AthenasArch/ESP32-CLP-Parana-V1.0/Documentos/CLP_ESP32_PIN_MAP/ESP32.xlsx

Sheet: WROOM
Name | Type | GPIO | OBS | ADC | UART | Parallel QSPI | APPLICATION | USED FOR | Setado no projeto
IO00 | I/O | GPIO00 | outputs PWM signal at boot | ADC2_CH01 |  |  | BOOTLOADER-SWITCH | INPUT | ok
TXD0 | I/O | GPIO01 |  |  | U0TXD |  | Fiwmare |  | ok
IO02 | I/O | GPIO02 |  | ADC2_CH02 |  | HSPIWP | PWM |  | ok
RXD0 | I/O | GPIO03 |  |  | U0RXD |  | Fiwmare |  | ok
IO04 | I/O | GPIO04 |  | ADC2_CH0 |  | HSPIHD | PWM |  | ok
IO05 | I/O | GPIO05 |  |  |  | VSPICS0 | SPI-CS | SPI-CS | ok
SCK/CLK* | I/O | GPIO06 |  |  | U1CTS | SPICLK | INTERNAL |  | ok
SDO/SD0* | I/O | GPIO07 |  |  | U2RTS | SPIQ | INTERNAL |  | ok
SDI/SD1* | I/O | GPIO08 |  |  | U2CTS | SPID | INTERNAL |  | ok
SHD/SD2* | I/O | GPIO09 |  |  | U1RXD | SPIHD | INTERNAL |  | ok
SWP/SD3* | I/O | GPIO10 |  |  | U1TXD | SPIWP | INTERNAL |  | ok
SCS/CMD* | I/O | GPIO11 |  |  | U1RTS | SPICS0 | INTERNAL |  | ok
IO12 | I/O | GPIO12 |  | ADC2_CH05 |  | HSPIQ | RELAY | OUTPUT | ok
IO13 | I/O | GPIO13 |  | ADC2_CH04 |  | HSPID | RELAY | OUTPUT | ok
IO14 | I/O | GPIO14 |  | ADC2_CH06 |  | HSPICLK | RELAY | OUTPUT | ok
IO15 | I/O | GPIO15 |  | ADC2_CH03 |  | HSPICS0 | BUTTON | INPUT | ok
IO16 | I/O | GPIO16 |  |  | U2RXD |  | EXTERNAL-COMM | RX2 | ok
IO17 | I/O | GPIO17 |  |  | U2TXD |  | EXTERNAL-COMM | TX2 | ok
IO18 | I/O | GPIO18 |  |  |  | VSPICLK | SPI-SCK | - | ok
IO19 | I/O | GPIO19 |  |  | U0CTS | VSPIQ | SPI-MISO | - | ok
IO21 | I/O | GPIO21 |  |  |  | VSPIHD | I2C | SDA | ok
IO22 | I/O | GPIO22 |  |  | U0RTS | VSPIWP | I2C | SCL | ok
IO23 | I/O | GPIO23 |  |  |  | VSPID | SPI-MOSI | - | ok
IO25 | I/O | GPIO25 |  | ADC2_CH08 |  |  | BUZZER | OUTPUT | ok
IO26 | I/O | GPIO26 |  | ADC2_CH09 |  |  | Temperature DS18B20 | ANALOG | ok
IO27 | I/O | GPIO27 |  | ADC2_CH07 |  |  | RELAY | OUTPUT | ok
IO32 | I/O | GPIO32 |  | ADC1_CH04 |  |  | DIGITAL-INPUT | INPUT | ok
IO33 | I/O | GPIO33 |  | ADC1_CH05 |  |  | DIGITAL-INPUT | INPUT | ok
IO34 | I | GPIO34 |  | ADC1_CH06 |  |  | DIGITAL-INPUT | INPUT | ok
IO35 | I | GPIO35 |  | ADC1_CH07 |  |  | DIGITAL-INPUT | INPUT | ok
SENSOR_VP | I | GPIO36 |  | ADC1_CH0 |  |  | ANALOG-INPUT | ANALOG | ok
SENSOR_VN | I | GPIO39 |  | ADC1_CH03 |  |  | ANALOG-INPUT | ANALOG | ok
GND | P |  |  |  |  |  | INTERNAL |  | ok
3V3 | P |  |  |  |  |  | INTERNAL |  | ok
EN | I |  |  |  |  |  | INTERNAL |  | ok
GND | P |  |  |  |  |  | INTERNAL |  | ok
NC | - |  |  |  |  |  | INTERNAL |  | ok
GND | P |  |  |  |  |  | INTERNAL |  | ok
GND | P |  |  |  |  |  | INTERNAL |  | ok

Sheet: ESP32 Chip
Name | No. | Type |  |  |  |  |  |  |  |  | Function
VDDA | 1 | P | Analog power supply (2.3V ~ 3.6V)
LNA_IN | 2 | I/O | RF input and output
VDD3P3 | 3 | P | Power supply (2.3V ~ 3.6V)
VDD3P3 | 4 | P | Power supply (2.3V ~ 3.6V)
SENSOR_VP | 5 | I | GPIO36 | ADC_PRE_AMP | ADC1_CH0 |  |  |  |  |  | RTC_GPIO0 Note: Connects a 270 pF capacitor from SENSOR_VP to SENSOR_ CAPP w
SENSOR_CAPP | 6 | I | GPIO37 | ADC_PRE_AMP | ADC1_CH1 |  |  |  |  |  | RTC_GPIO1 Note: Connects a 270 pF capacitor from SENSOR_VP to SENSOR_ CAPP w
SENSOR_CAPN | 7 | I | GPIO38 | ADC1_CH2 | ADC_PRE_AMP |  |  |  |  |  | RTC_GPIO2 Note: Connects a 270 pF capacitor from SENSOR_VN to SENSOR_ CAPN w
SENSOR_VN | 8 | I | GPIO39 | ADC1_CH3 | ADC_PRE_AMP |  |  |  |  |  | RTC_GPIO3 Note: Connects a 270 pF capacitor from SENSOR_VN to SENSOR_ CAPN w
CHIP_PU | 9 | I | High: On; enables the chip Low: Off; resets the chip Note: Do not leave the CHIP_PU pin floating.
VDET_1 | 10 | I | GPIO34 | ADC1_CH6 |  |  |  |  |  |  | RTC_GPIO4
VDET_2 | 11 | I | GPIO35 | ADC1_CH7 |  |  |  |  |  |  | RTC_GPIO5
32K_XP | 12 | I/O | GPIO32 | 32K_XP (32.768 kHz crystal oscillator input) | ADC1_CH4 | TOUCH9 |  |  |  |  | RTC_GPIO9
32K_XN | 13 | I/O | GPIO33 | 32K_XN (32.768 kHz crystal oscillator output) | ADC1_CH5 | TOUCH8 |  |  |  |  | RTC_GPIO8
GPIO25 | 14 | I/O | GPIO25 | DAC_1 | ADC2_CH8 | RTC_GPIO6 |  |  |  |  | EMAC_RXD0
GPIO26 | 15 | I/O | GPIO26 | DAC_2 | ADC2_CH9 | RTC_GPIO7 |  |  |  |  | EMAC_RXD1
GPIO27 | 16 | I/O | GPIO27 | ADC2_CH7 | TOUCH7 | RTC_GPIO17 |  |  |  |  | EMAC_RX_DV
MTMS | 17 | I/O | GPIO14 | ADC2_CH6 | TOUCH6 | RTC_GPIO16 | MTMS | HSPICLK | HS2_CLK | SD_CLK | EMAC_TXD2
MTDI | 18 | I/O | GPIO12 | ADC2_CH5 | TOUCH5 | RTC_GPIO15 | MTDI | HSPIQ | HS2_DATA2 | SD_DATA2 | EMAC_TXD3
VDD3P3_RTC | 19 | P | Input power supply for RTC IO (1.8V ~ 3.6V)
MTCK | 20 | I/O | GPIO13 | ADC2_CH4 | TOUCH4 | RTC_GPIO14 | MTCK | HSPID | HS2_DATA3 | SD_DATA3 | EMAC_RX_ER
MTDO | 21 | I/O | GPIO15 | ADC2_CH3 | TOUCH3 | RTC_GPIO13 | MTDO | HSPICS0 | HS2_CMD | SD_CMD | EMAC_RXD3
GPIO2 | 22 | I/O | GPIO2 | ADC2_CH2 | TOUCH2 | RTC_GPIO12 | HSPIWP | HS2_DATA0 |  |  | SD_DATA0
GPIO0 | 23 | I/O | GPIO0 | ADC2_CH1 | TOUCH1 | RTC_GPIO11 | CLK_OUT1
GPIO4 | 24 | I/O | GPIO4 | ADC2_CH0 | TOUCH0 | RTC_GPIO10 | HSPIHD | HS2_DATA1 | SD_DATA1 |  | EMAC_TX_ER
GPIO16 | 25 | I/O | GPIO16 | HS1_DATA4 | U2RXD |  |  |  |  |  | EMAC_CLK_OUT
VDD_SDIO | 26 | P | Output power supply: 1.8V or the same voltage as
GPIO17 | 27 | I/O | GPIO17 | HS1_DATA5 | U2TXD |  |  |  |  |  | EMAC_CLK_OUT_180
SD_DATA_2 | 28 | I/O | GPIO9 | SD_DATA2 | SPIHD | HS1_DATA2 | UNUSABLE !!! (Flash memory) |  |  |  | U1RXD
SD_DATA_3 | 29 | I/O | GPIO10 | SD_DATA3 | SPIWP | HS1_DATA3 | UNUSABLE !!! (Flash memory) |  |  |  | U1TXD
SD_CMD | 30 | I/O | GPIO11 | SD_CMD | SPICS0 | HS1_CMD | UNUSABLE !!! (Flash memory) |  |  |  | U1RTS
SD_CLK | 31 | I/O | GPIO6 | SD_CLK | SPICLK | HS1_CLK | UNUSABLE !!! (Flash memory) |  |  |  | U1CTS
SD_DATA_0 | 32 | I/O | GPIO7 | SD_DATA0 | SPIQ | HS1_DATA0 | UNUSABLE !!! (Flash memory) |  |  |  | U2RTS
SD_DATA_1 | 33 | I/O | GPIO8 | SD_DATA1 | SPID | HS1_DATA1 | UNUSABLE !!! (Flash memory) |  |  |  | U2CTS
GPIO5 | 34 | I/O | GPIO5 | VSPICS0 | HS1_DATA6 |  |  |  |  |  | EMAC_RX_CLK
GPIO18 | 35 | I/O | GPIO18 | VSPICLK |  |  |  |  |  |  | HS1_DATA7
GPIO23 | 36 | I/O | GPIO23 | VSPID |  |  |  |  |  |  | HS1_STROBE
VDD3P3_CPU | 37 | P | Input power supply for CPU IO (1.8V ~ 3.6V)
GPIO19 | 38 | I/O | GPIO19 | VSPIQ | U0CTS |  |  |  |  |  | EMAC_TXD0
GPIO22 | 39 | I/O | GPIO22 | VSPIWP | U0RTS |  |  |  |  |  | EMAC_TXD1
U0RXD | 40 | I/O | GPIO3 | U0RXD |  |  |  |  |  |  | CLK_OUT2
U0TXD | 41 | I/O | GPIO1 | U0TXD | CLK_OUT3 |  |  |  |  |  | EMAC_RXD2
GPIO21 | 42 | I/O | GPIO21 | VSPIHD |  |  |  |  |  |  | EMAC_TX_EN
VDDA | 43 | P | Analog power supply (2.3V ~ 3.6V)
XTAL_N | 44 | O | External crystal output
XTAL_P | 45 | I | External crystal input
VDDA | 46 | P | Digital power supply for PLL (2.3V ~ 3.6V)
CAP2 | 47 | I | Connects to a 3 nF capacitor and 20 kÎ© resistor in parallel
CAP1 | 48 | I | Connects to a 10 nF series capacitor to ground
GND | 49 | P | Ground

Sheet: Planilha1
ITEM | APLICAÇÃO | DESCRIÇÃO | QTDE | UNIDADE MEDIDA | OBSERVAÇÕES
0 | Alimentação AC | Tensão de alimentação | 1 | 90 a 240 VAC
1 | Alimentação DC | Tensão de alimentação | 1 | 12VDC
2 | - | Corrente de alimentação | 1 | 200mA
3 | Entradas | Entradas Digitais (Contato seco) | 4 | 7-24VDC
5 |  | Entradas analógicas (Tensão) | 2 | 0-32V
6 |  | Entrada digital (por chave tactil - botão) | 1 | -
 |  | Entrada de sinal AC - 90 a 240VAC | 2
8 | Saídas | Saídas Relé | 4 | -
- | - | - Tensão AC | " | 250V
- | - | - Corrente AC | " | 5A
- | - | - Tensão DC | " | 30V
- | - | - Corrente DC | " | 5A
9 | Saídas | Saídas por trasistores de efeito de campo - Mosfet’s (0 A 12V) | 2 | -
- | - | - Tensão DC | " | 30V
- | - | - Corrente DC | " | 5A
 | Buzzer | Buzzer passivo | 1 | 12VDC
10 | Comunicações | Porta de comunicação serial - (RS232) | 1 | TTL
11 | - | comunicação ISP | 1 | TTL
12 | - | comunicação I2C | 1 | TTL
14 | - | Rolégio em tempo real (RTC) - Precisão | 1 | SIM
 |  | WIFI 2,4 Gh | 1 | SIM
 |  | BLUETOOTH 5.0 | 1 | SIM
15 | Programação | Programação direta na placa | 1 | SIM
16 |  | Ambiente de programação | - | - | Arduino IDE (Ladder em desenvolvimento)
17 | Características | Condições de temperatura ambiente - min | - | -40°
18 |  | Condições de temperatura ambiente - max | - | +80°
19 |  | Dimensões | - | 150x119mm
20 | DISPLAY | display touch screen |  | 2,8" a 7,0" | Programação na interface do fabricante
