AthenasArch/ESP32-CLP-Parana-V1.0/Documentos/Schematic_v2.0/GETEWAY_V2.0.pdf

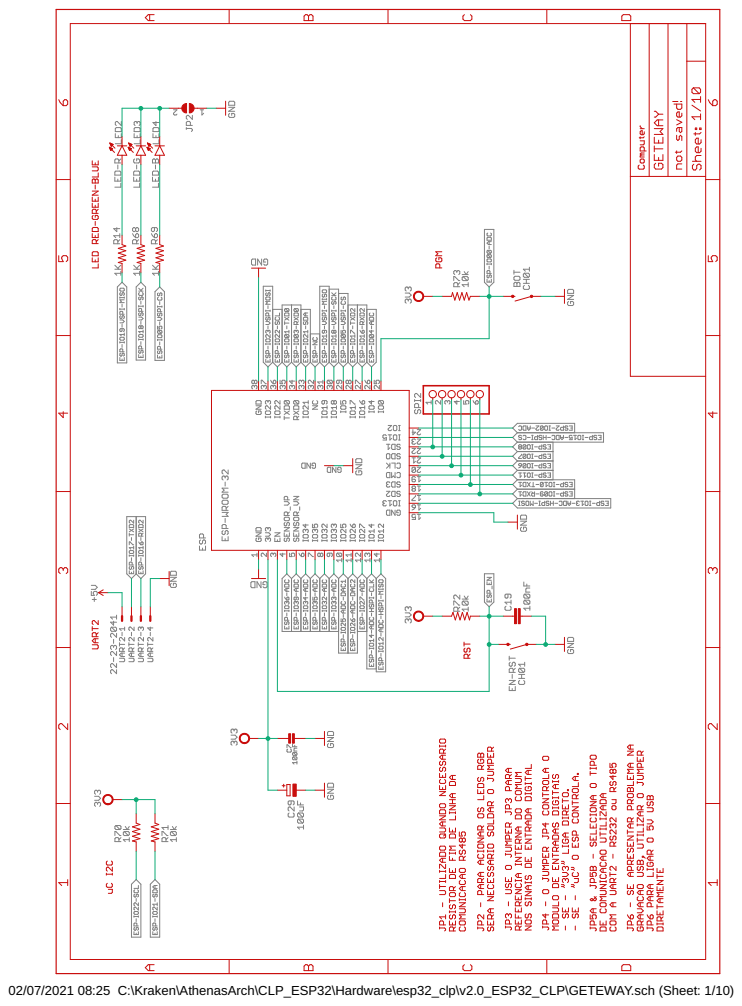
[picture p1: page 1]

02/07/2021 08:25 C:\Kraken\AthenasArch\CLP_ESP32\Hardware\esp32_clp\v2.0_ESP32_CLP\GETEWAY.sch (Sheet: 1/10)

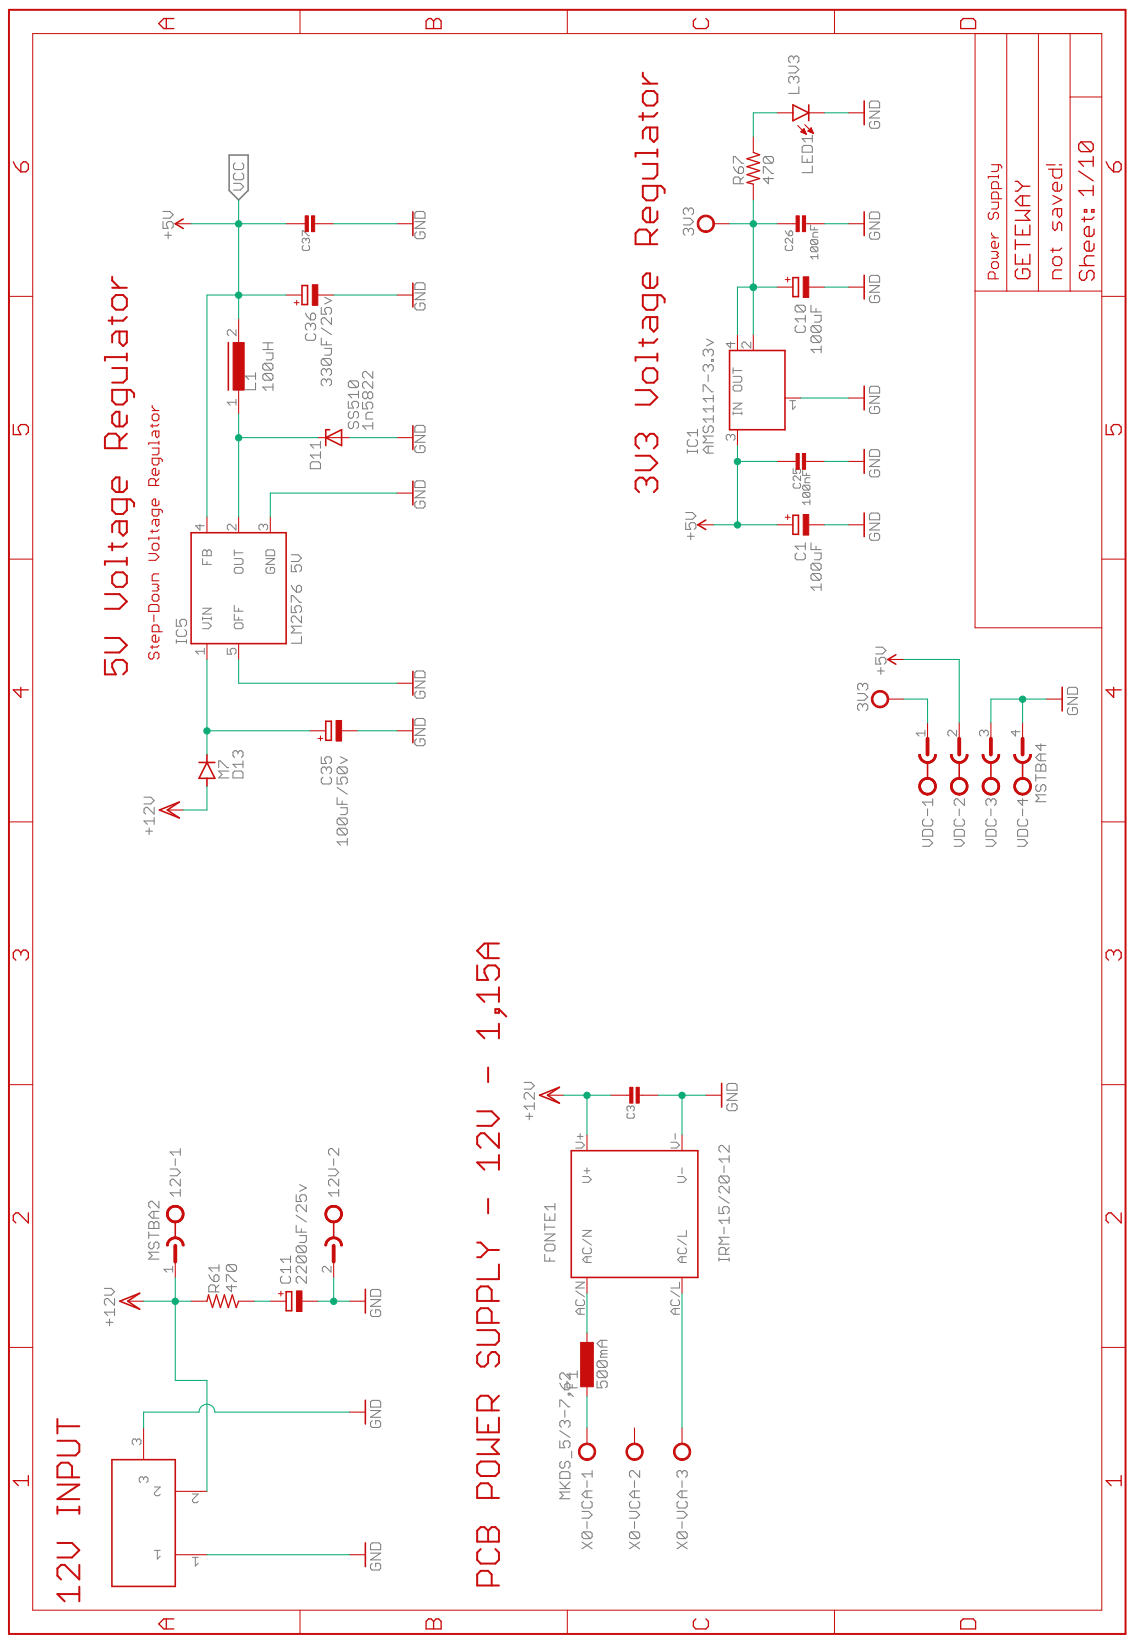
[picture p2: page 2]

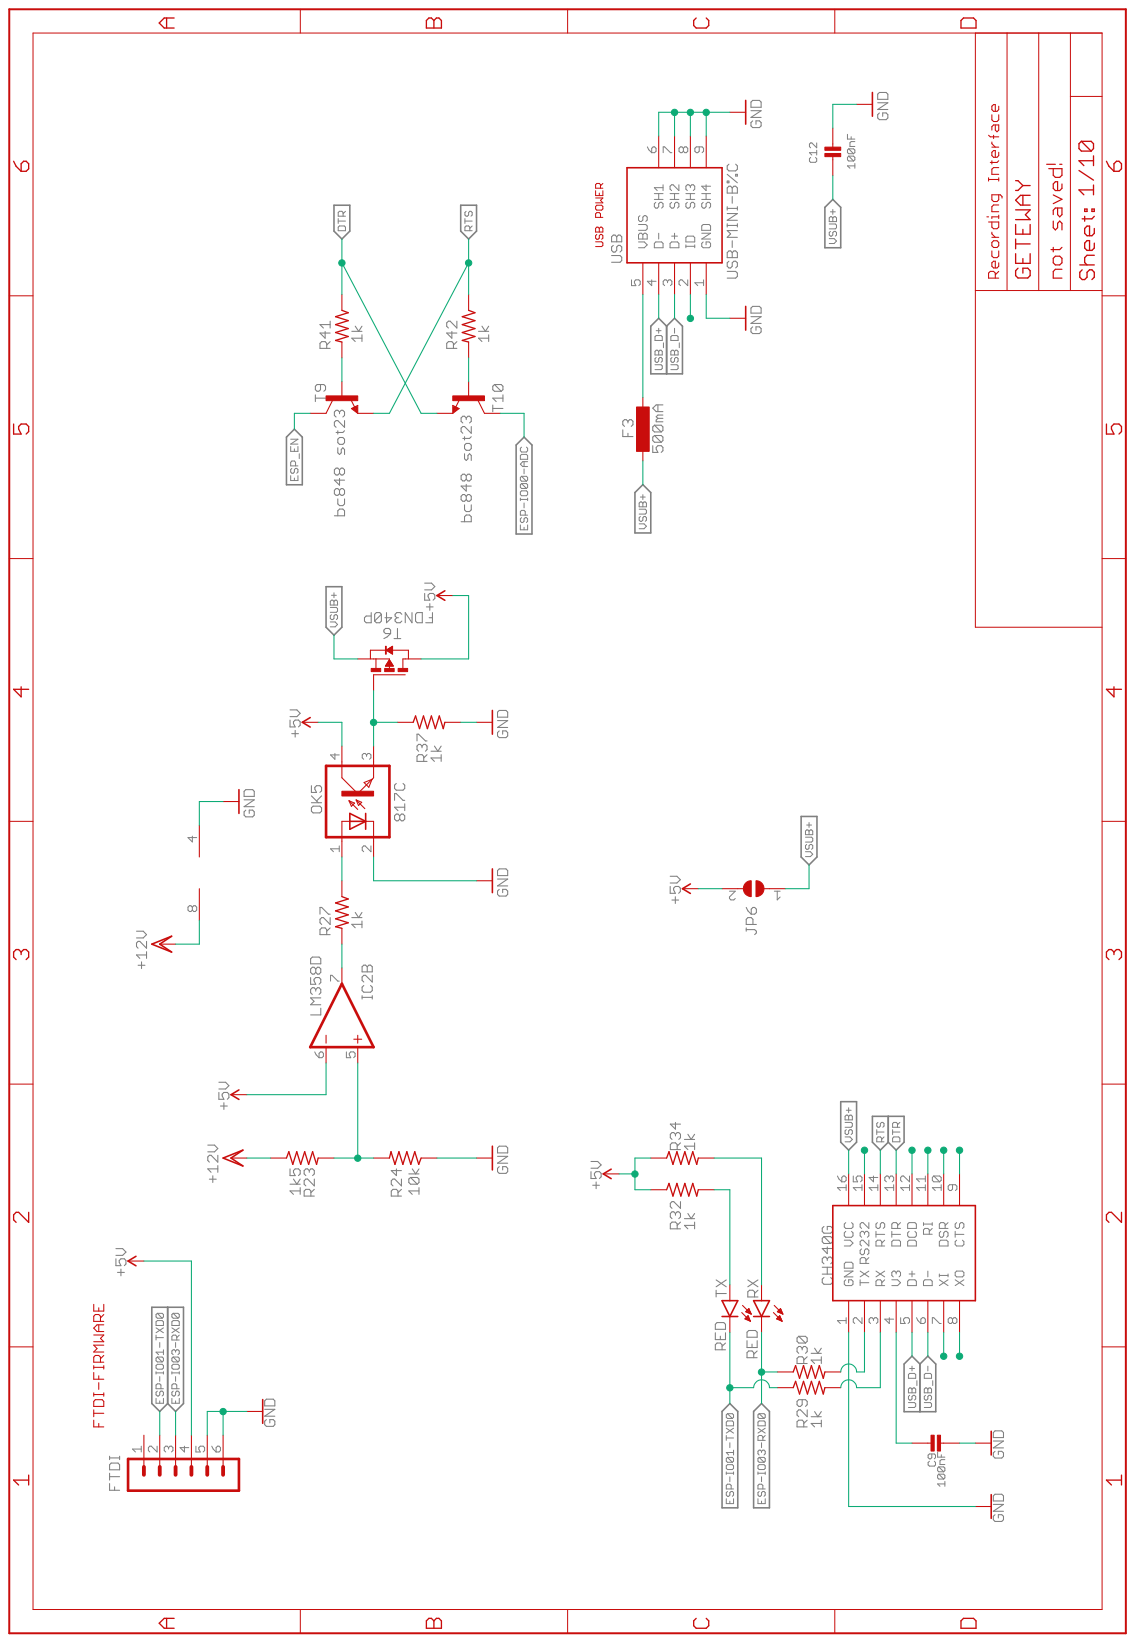
[picture p3: page 3]

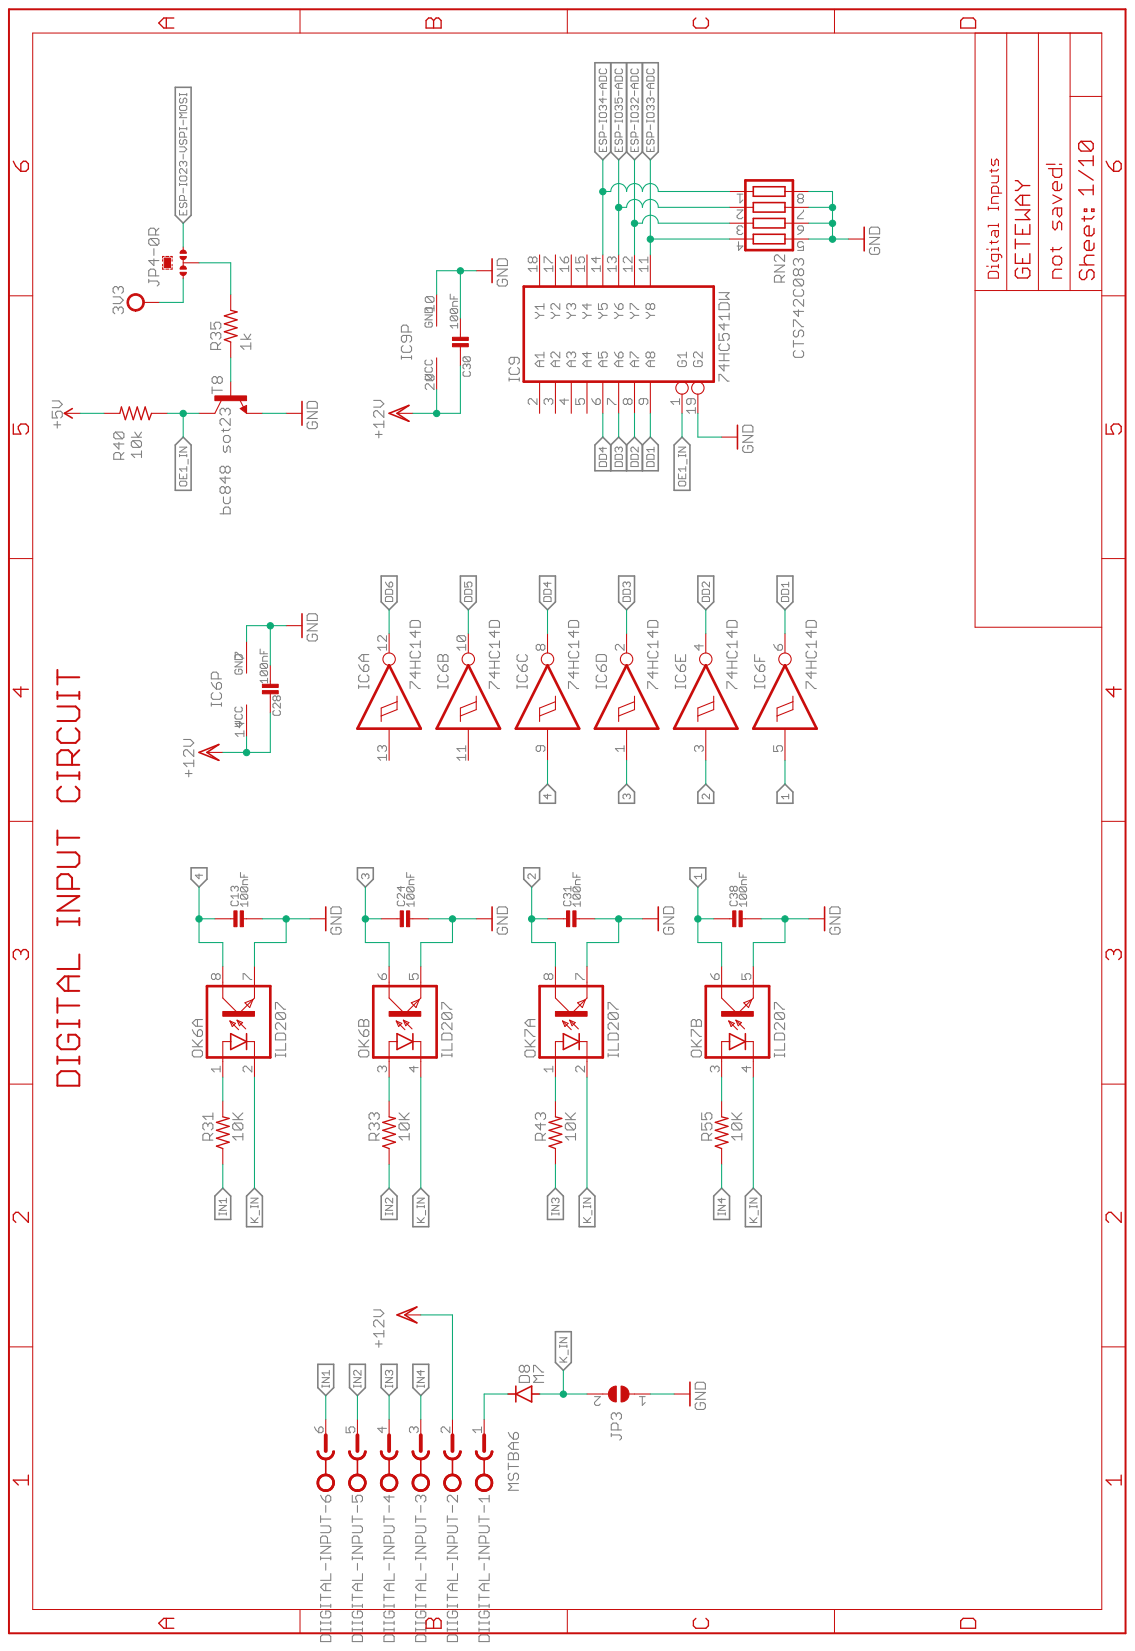
[picture p4: page 4]

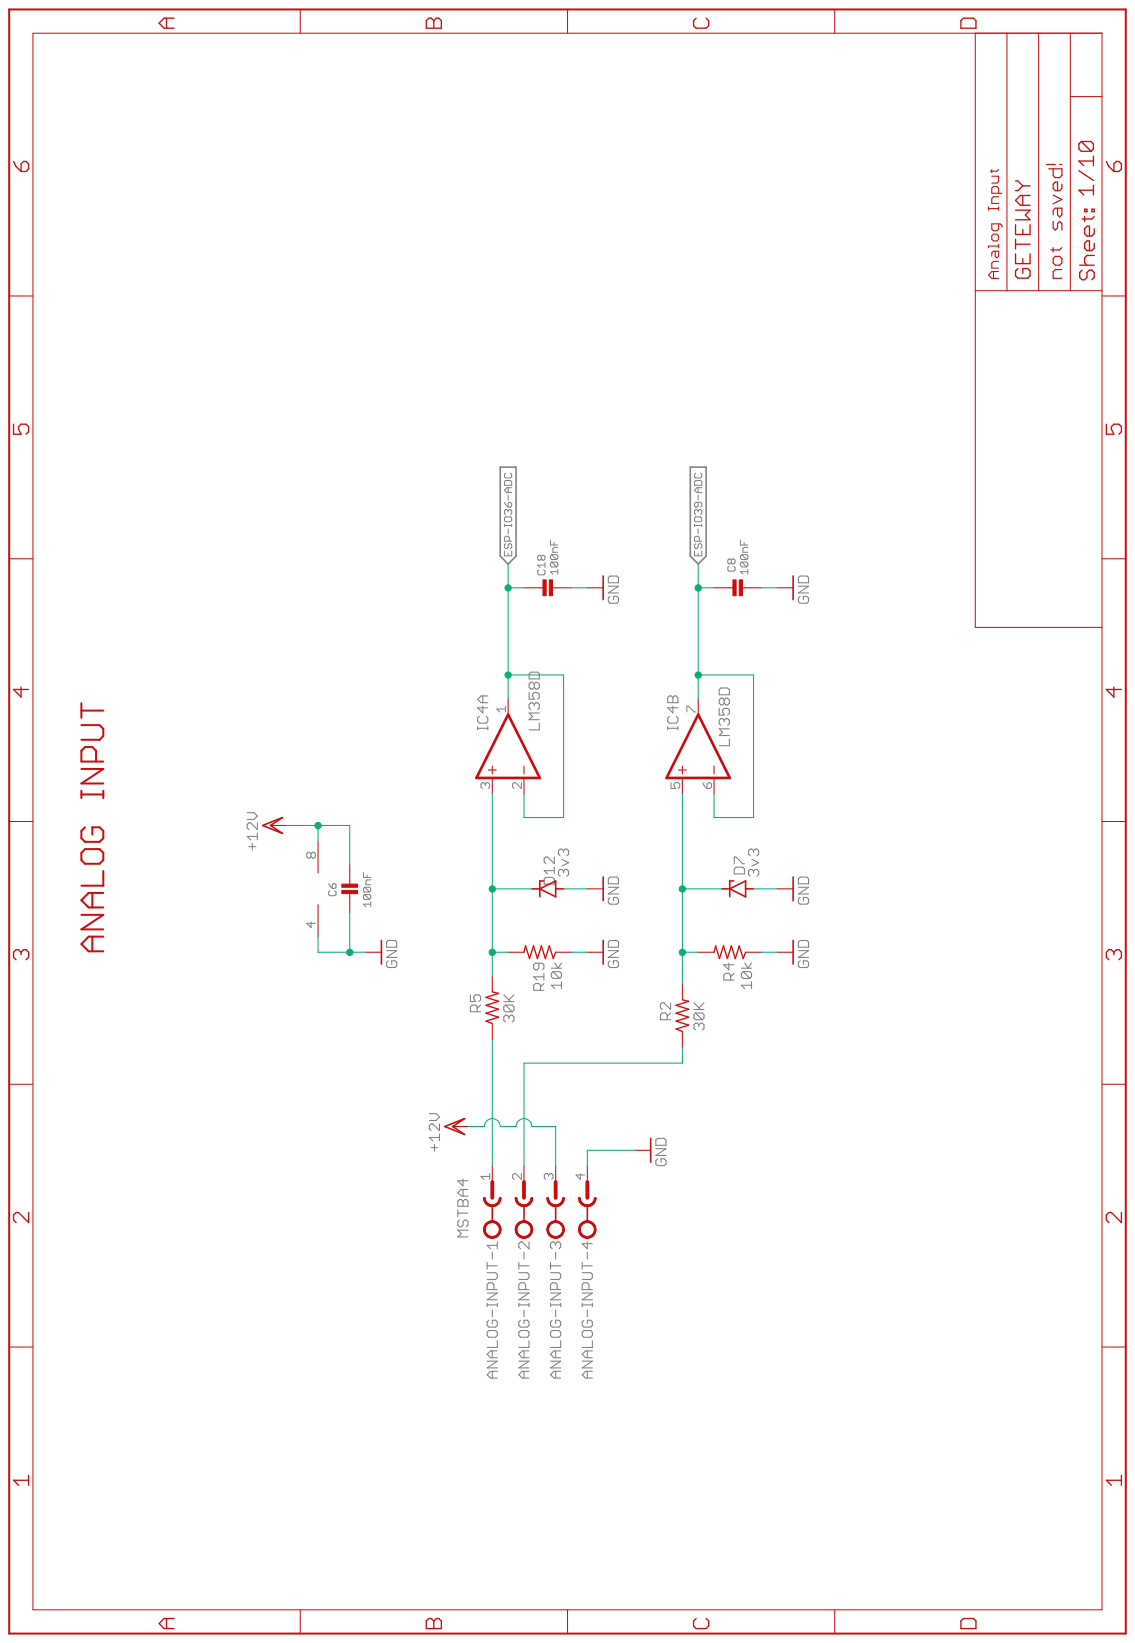
[picture p5: page 5]

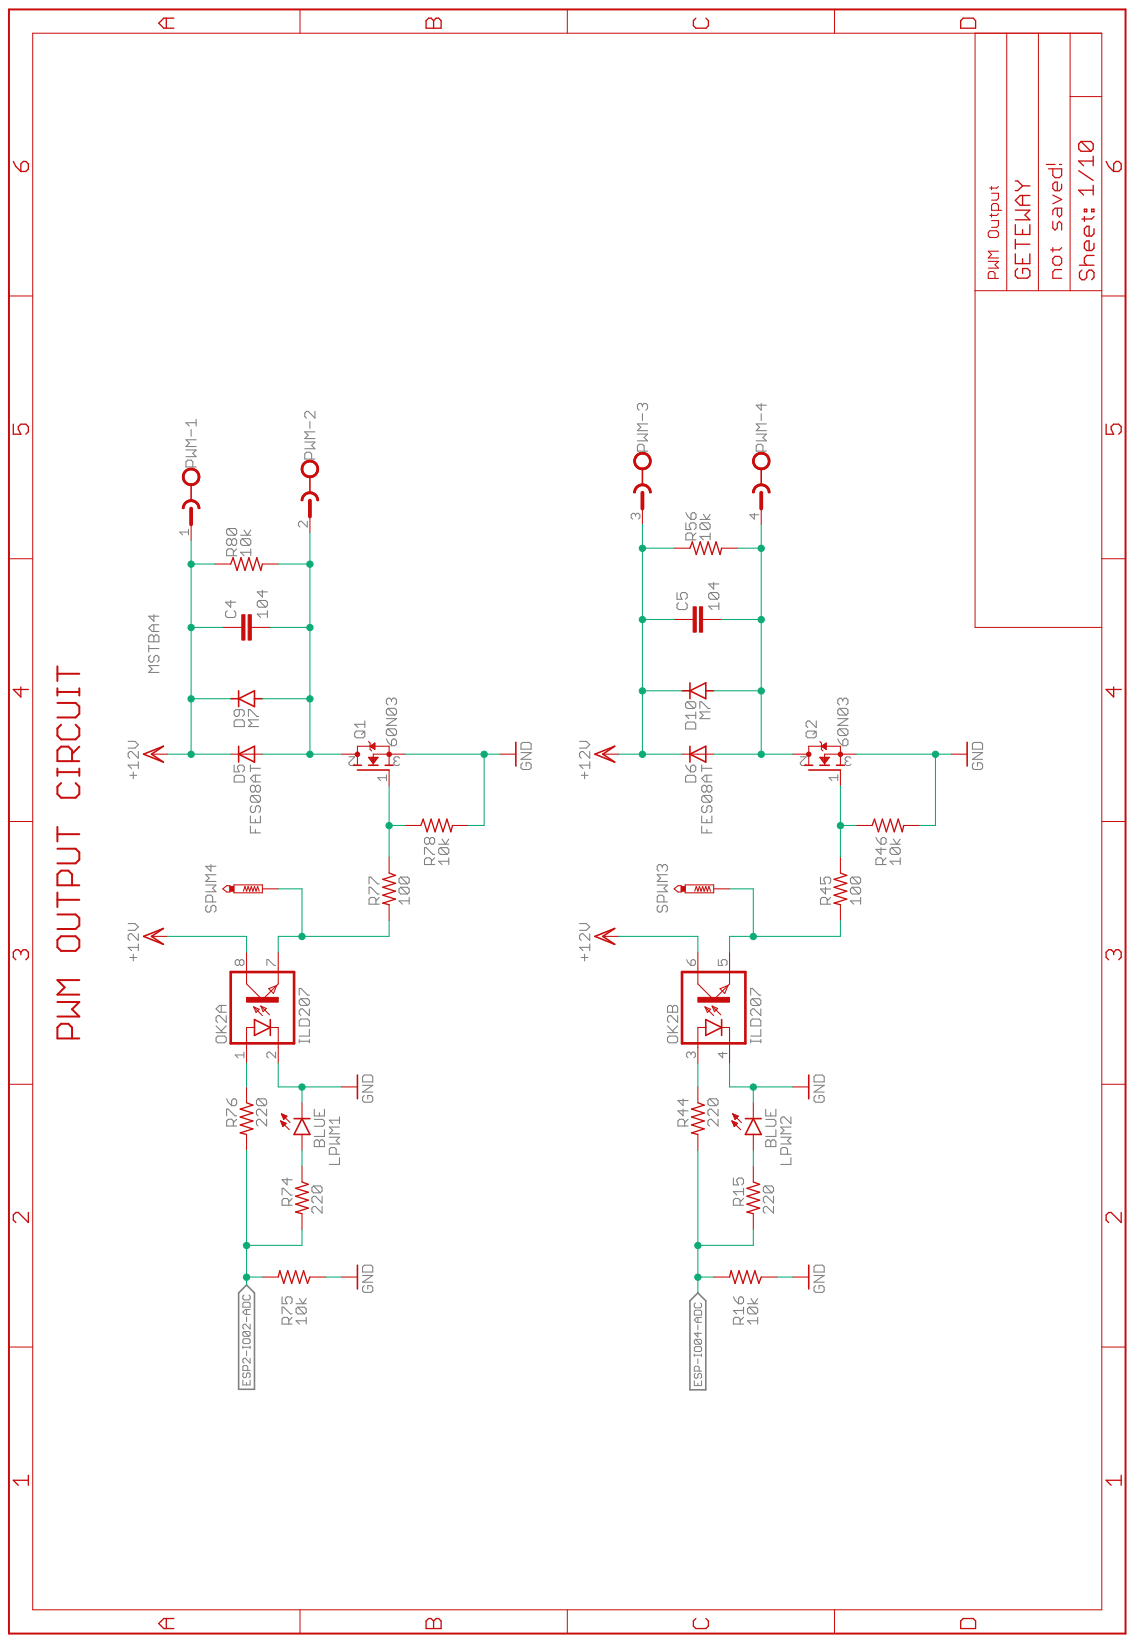
[picture p6: page 6]

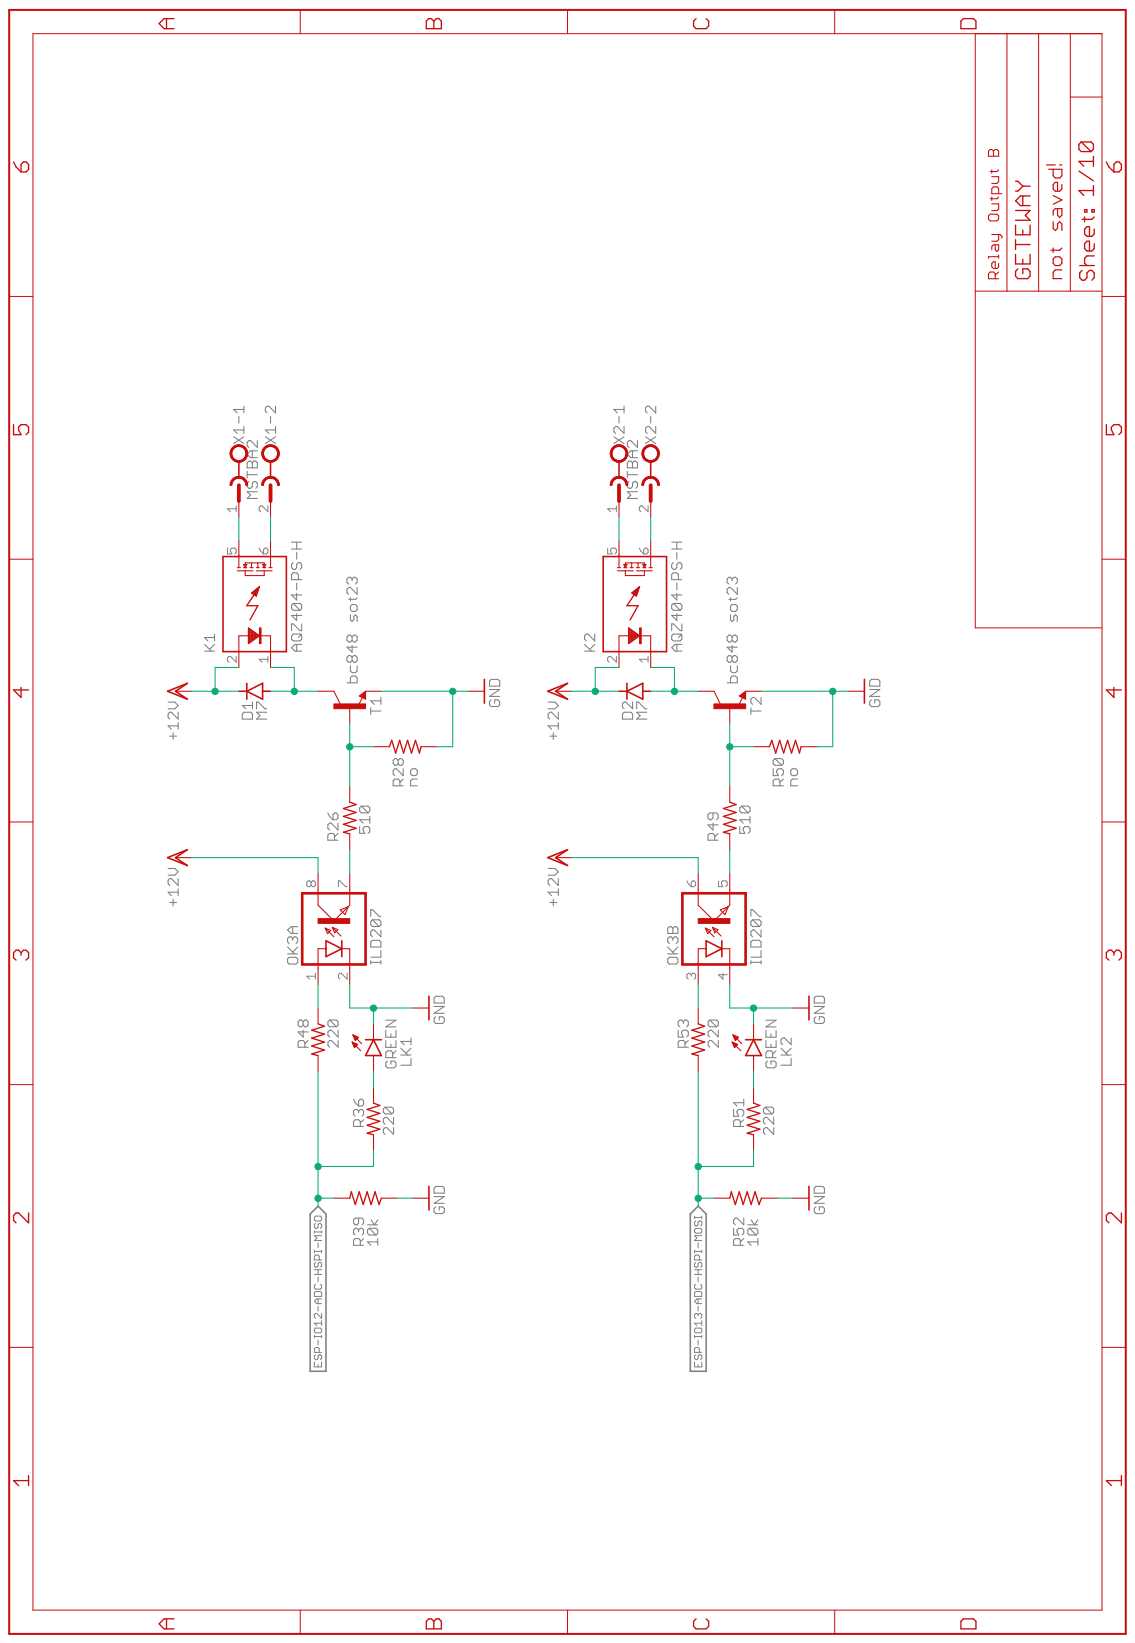
[picture p7: page 7]

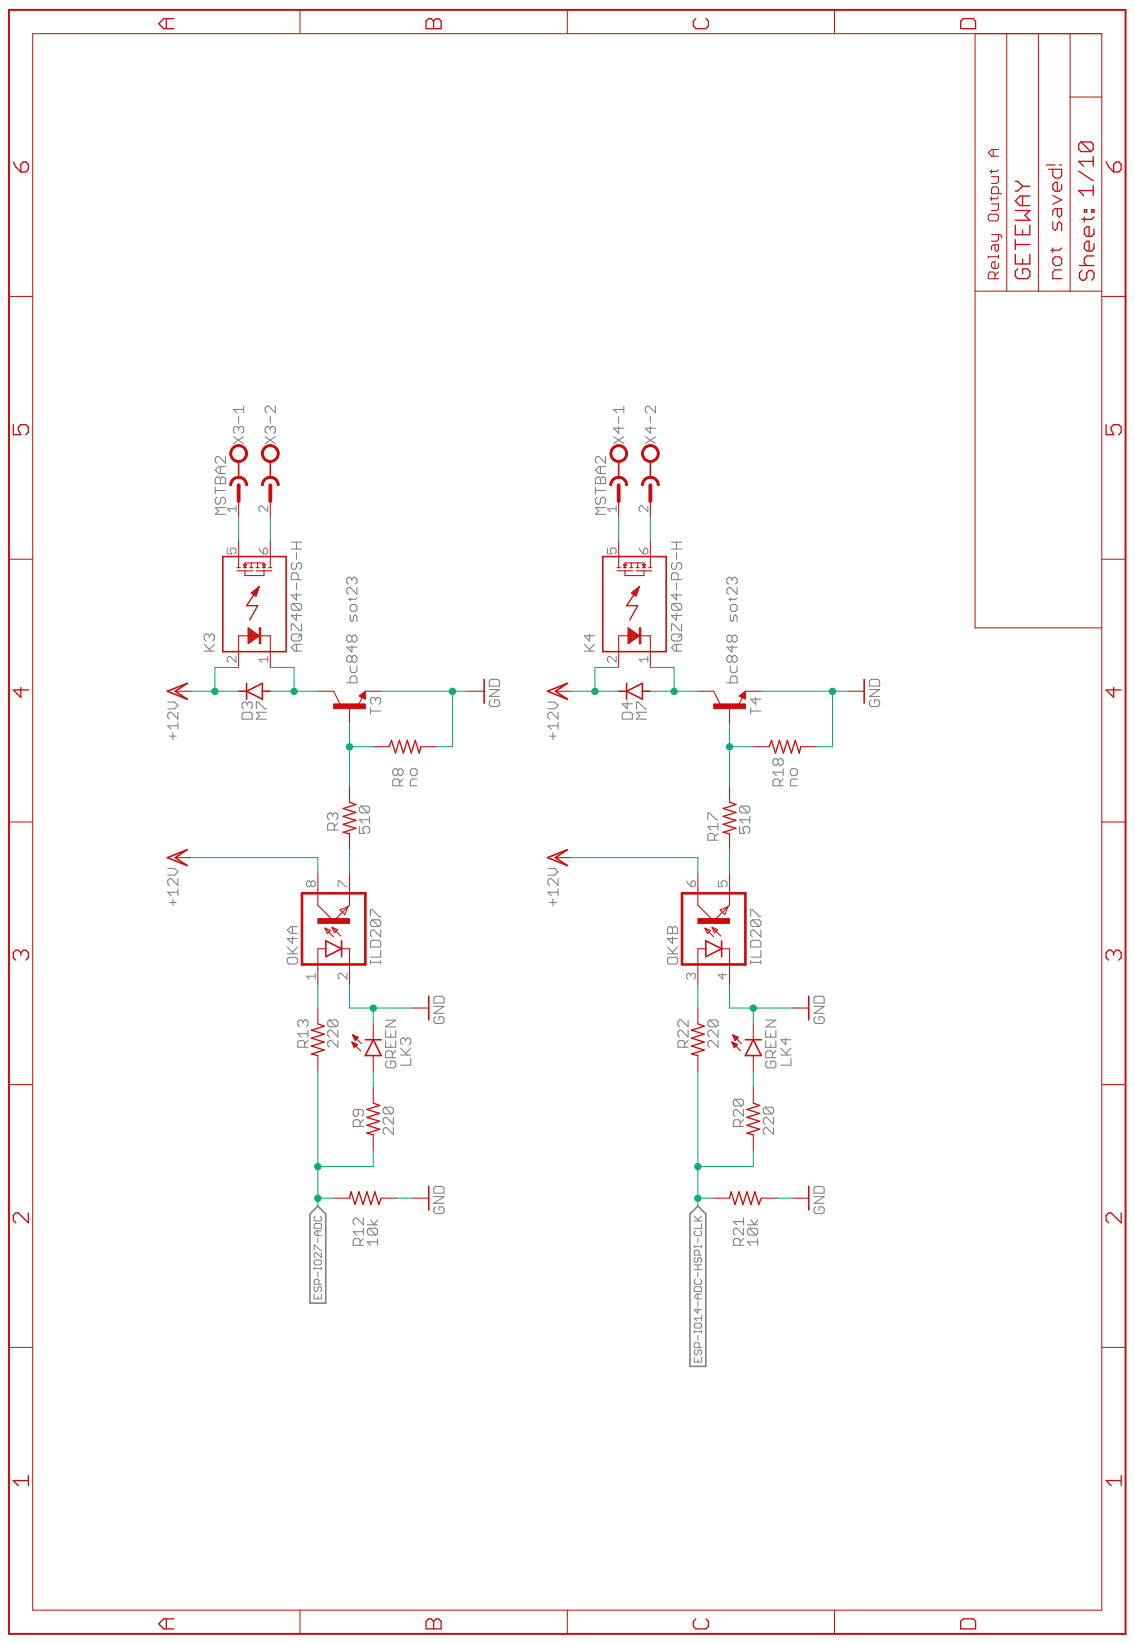
[picture p8: page 8]

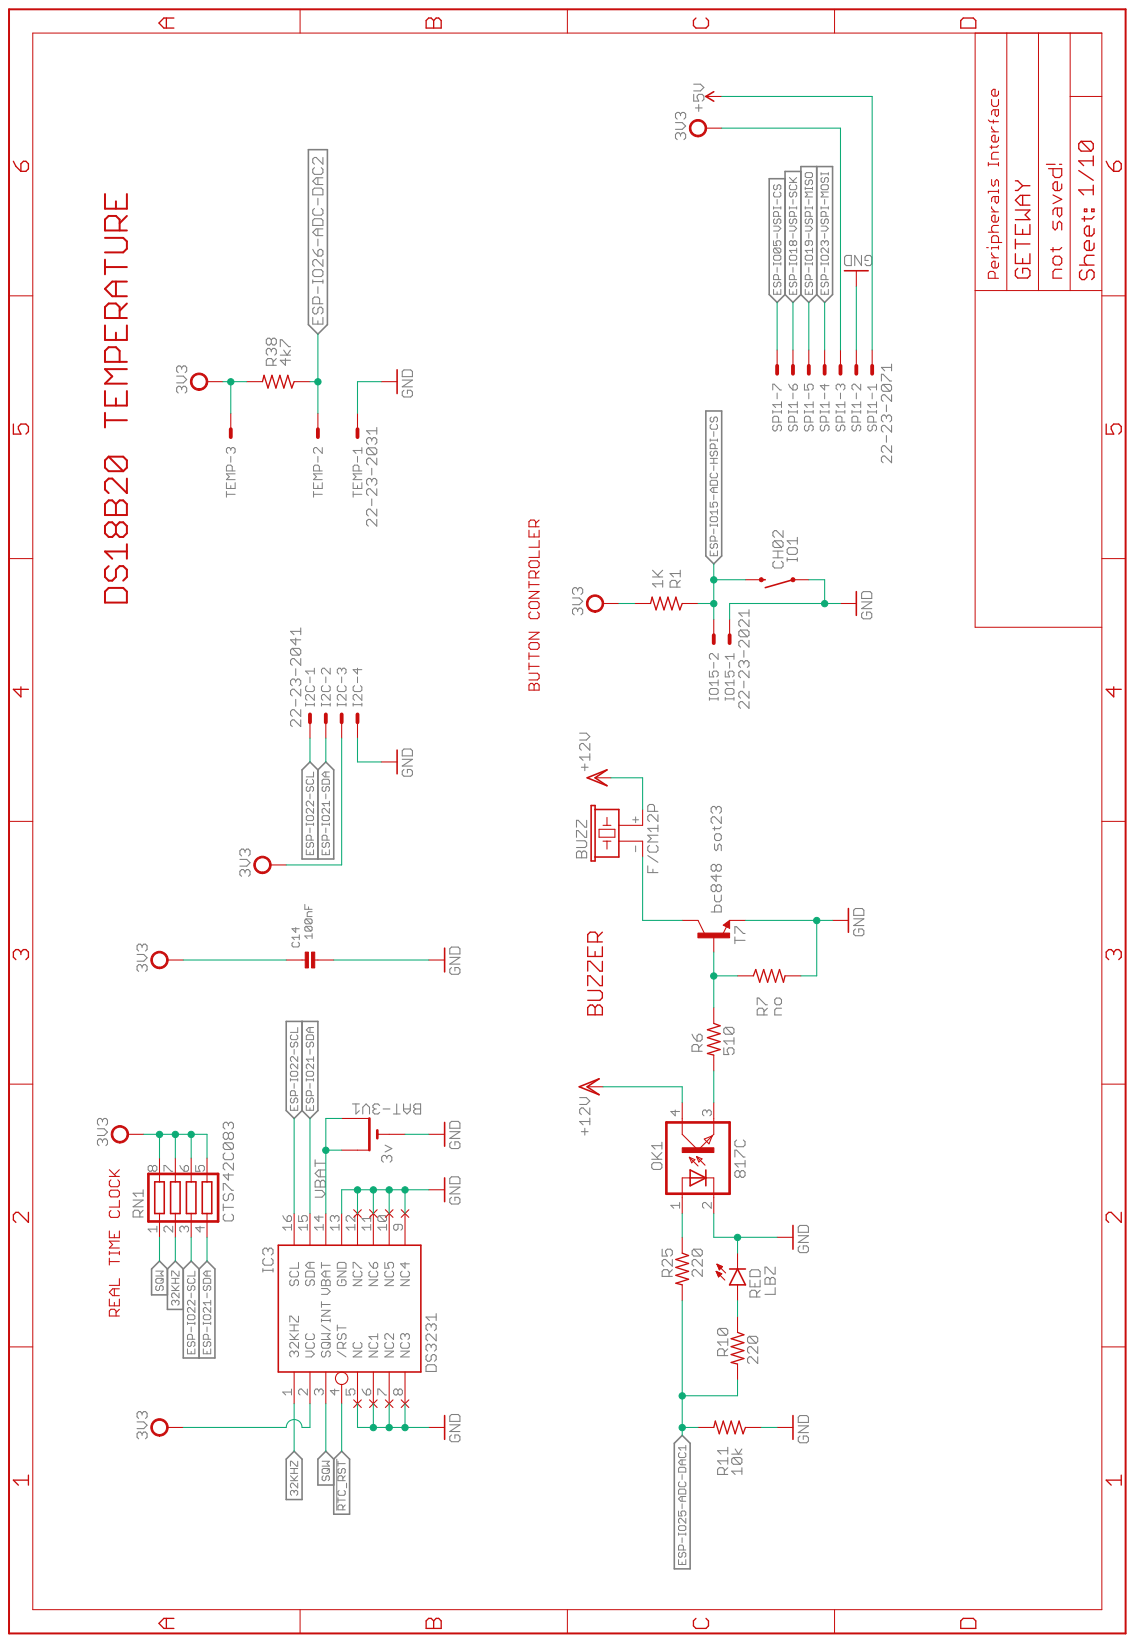
[picture p9: page 9]

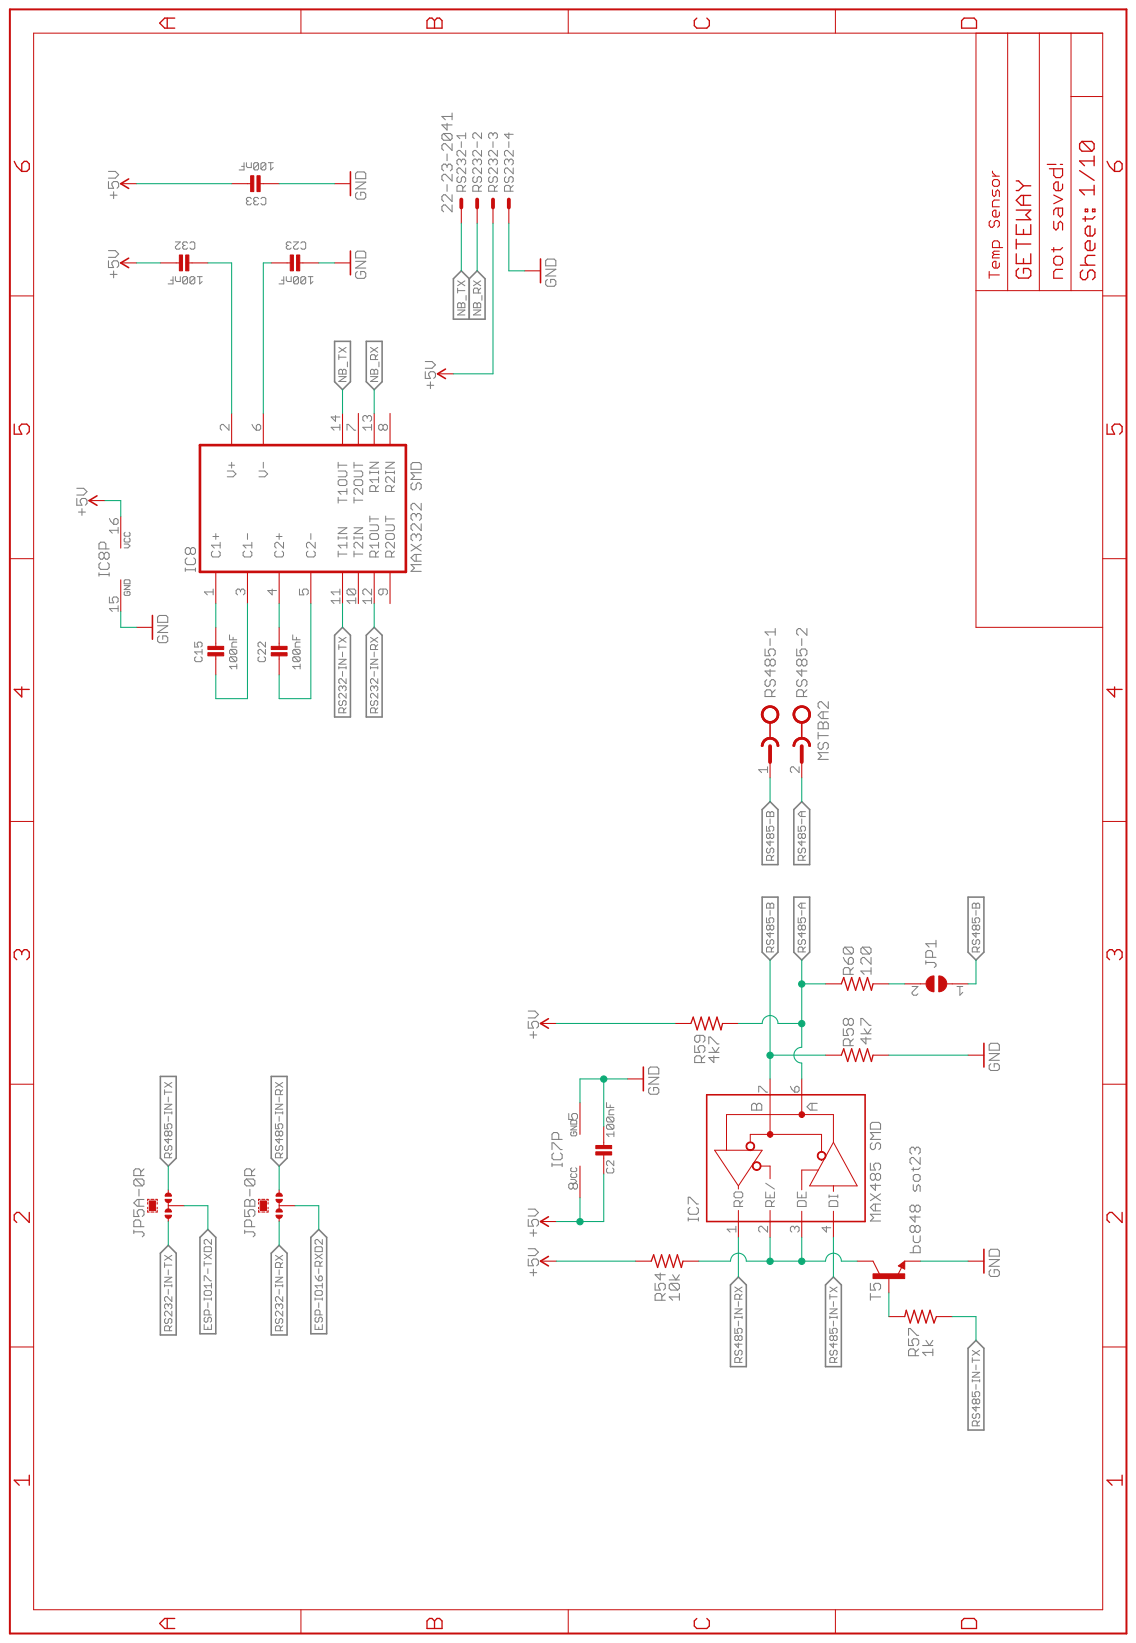
[picture p10: page 10]
