AthenasArch/ESP32-CLP-Parana-V1.0/v2.0_ESP32_CLP/ESP32_CLP.pdf

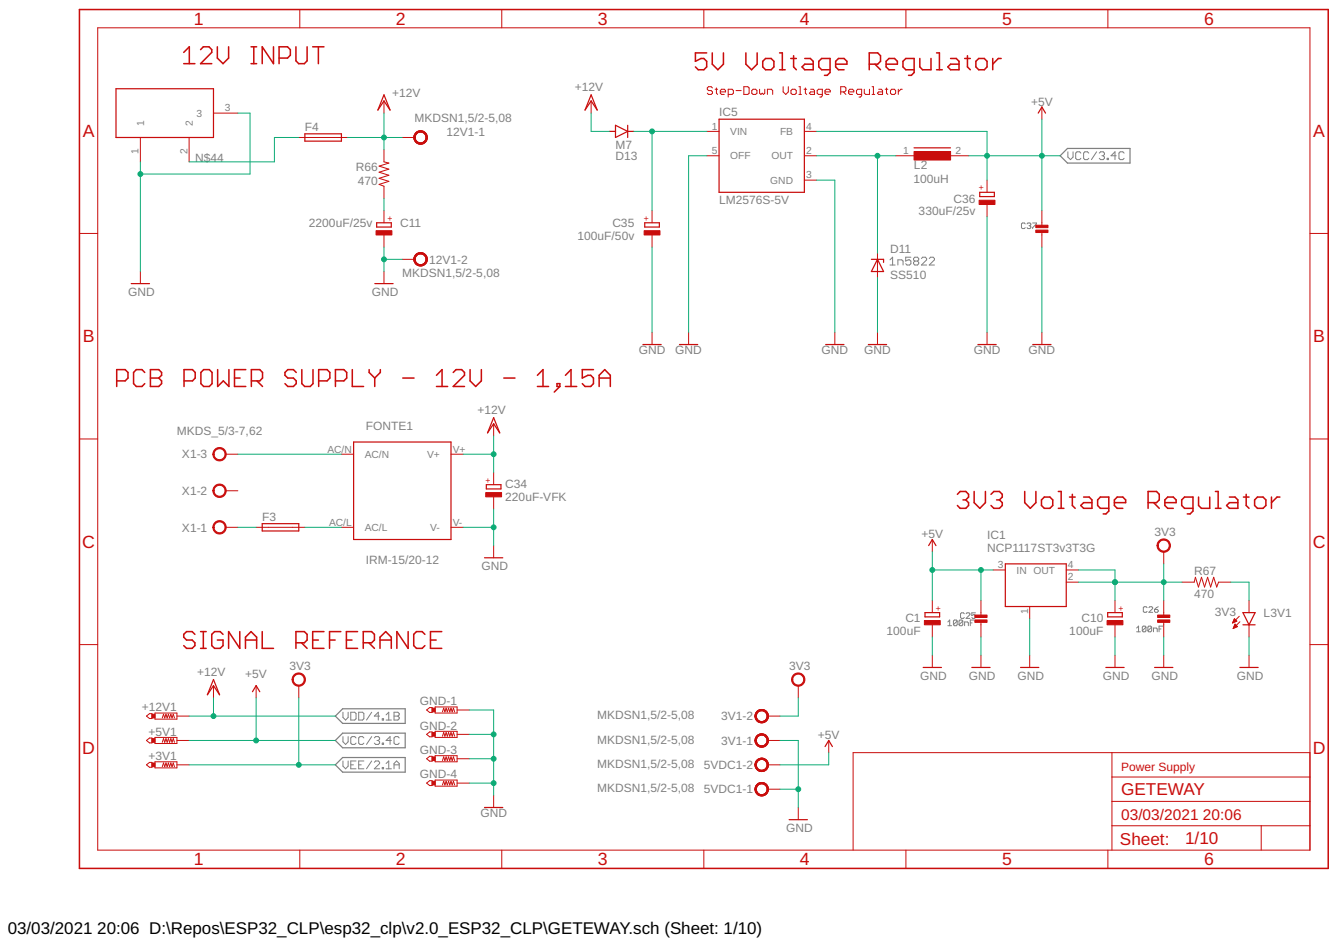
[picture p11: page 1]

03/03/2021 20:06 D:\Repos\ESP32_CLP\esp32_clp\v2.0_ESP32_CLP\GETEWAY.sch (Sheet: 1/10)

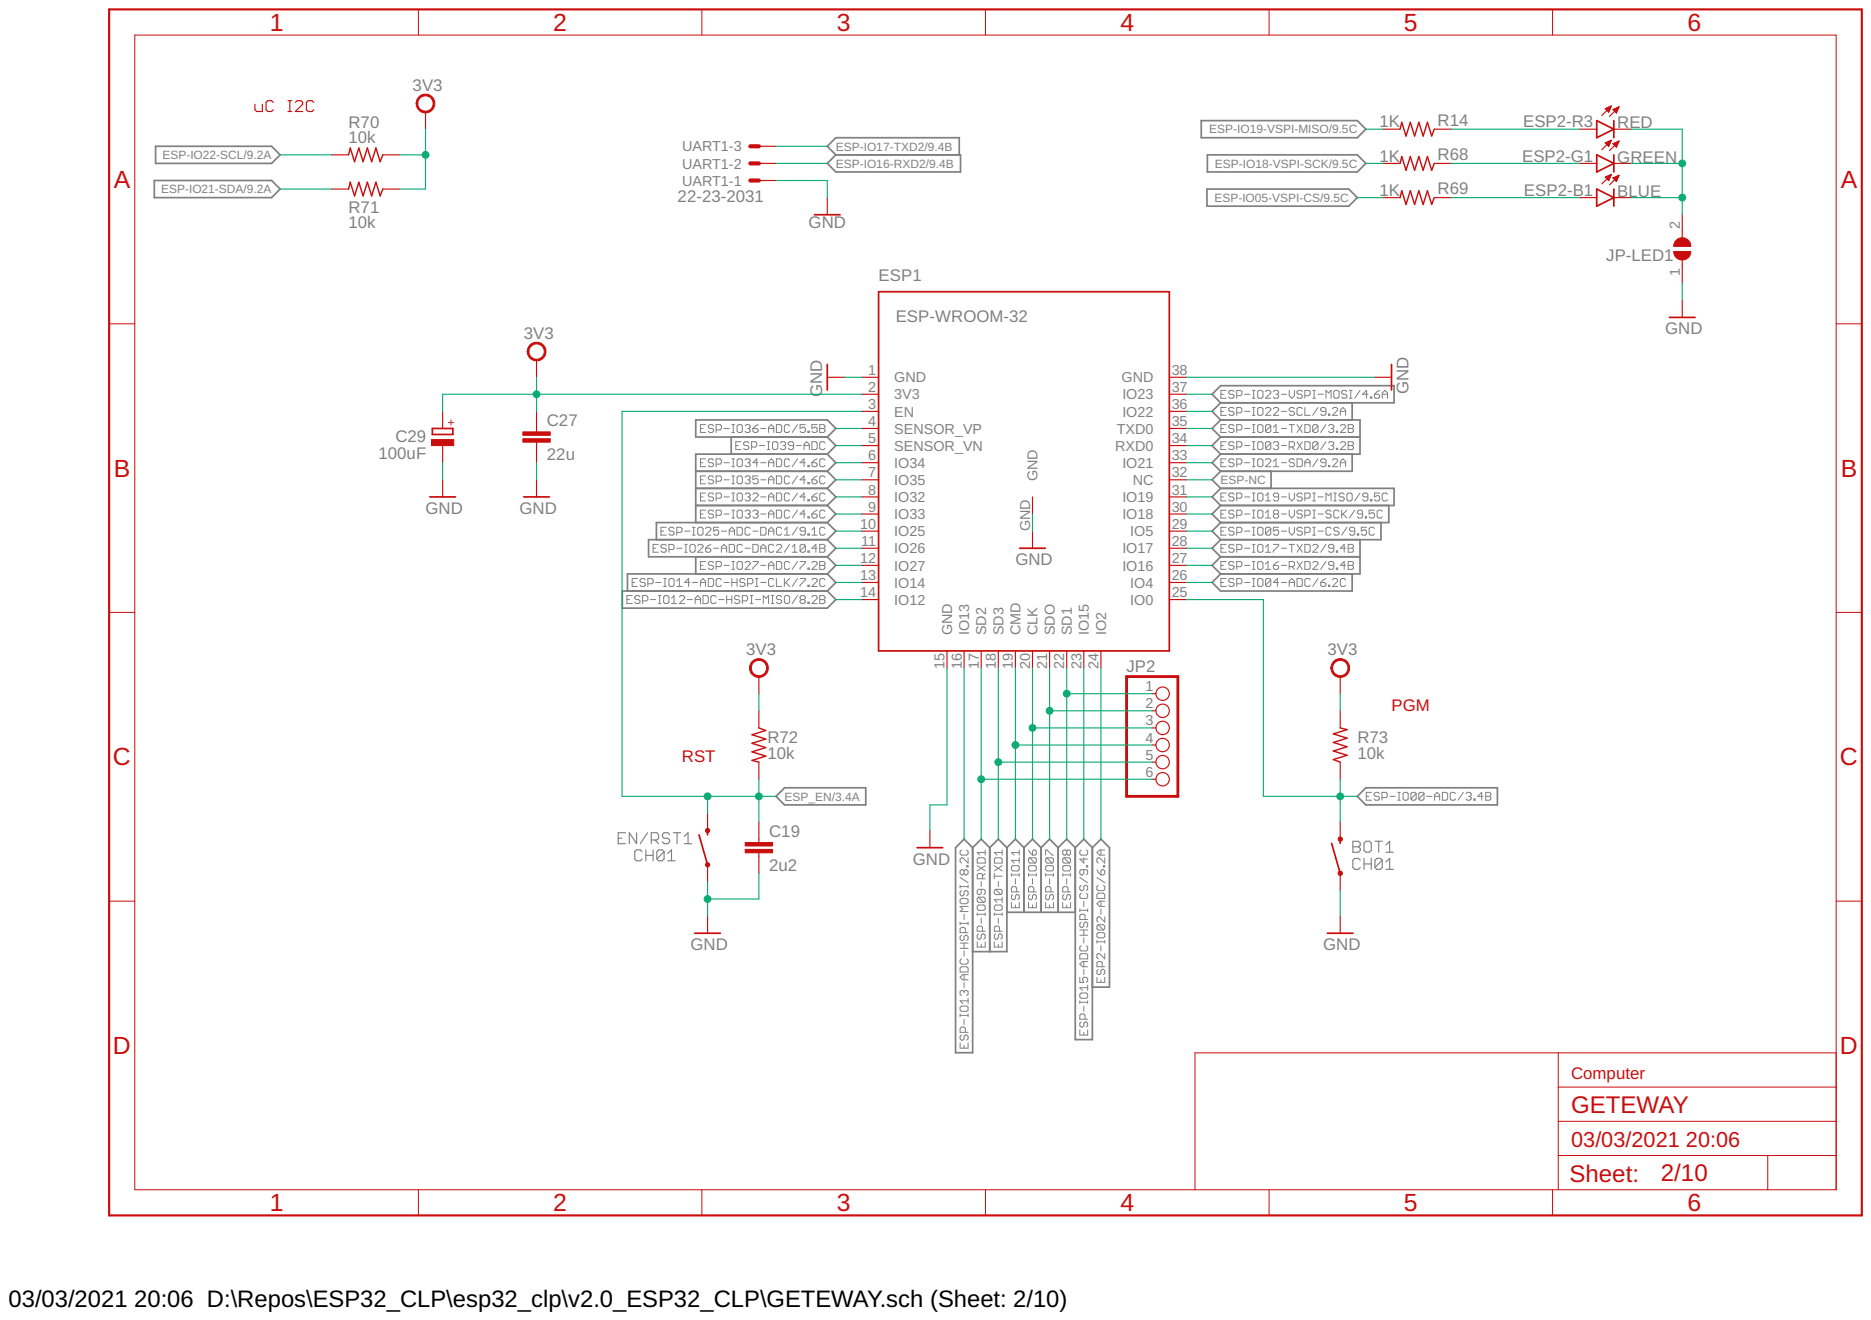
[picture p12: page 2]

03/03/2021 20:06 D:\Repos\ESP32_CLP\esp32_clp\v2.0_ESP32_CLP\GETEWAY.sch (Sheet: 2/10)

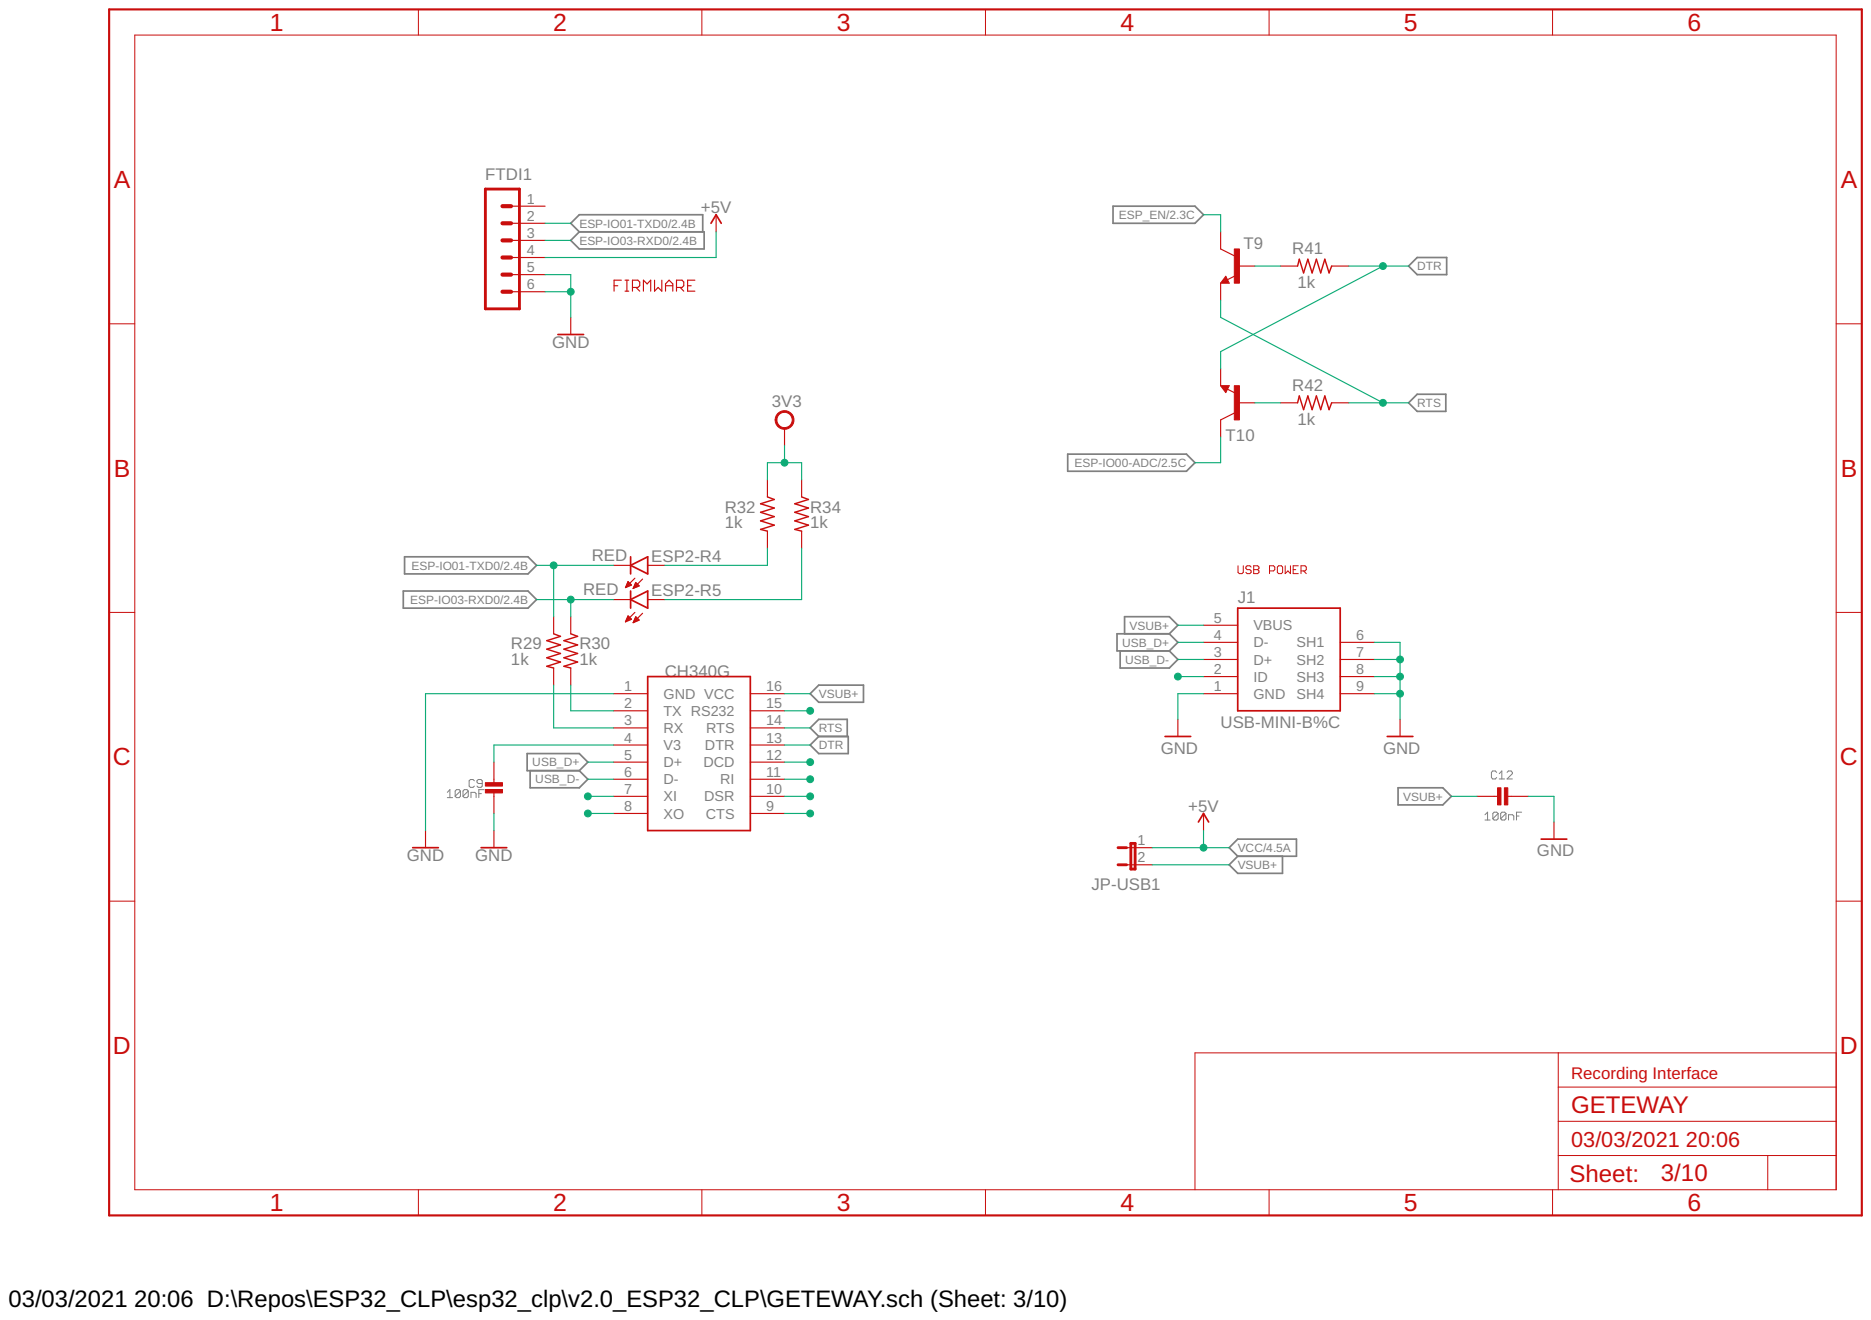
[picture p13: page 3]

03/03/2021 20:06 D:\Repos\ESP32_CLP\esp32_clp\v2.0_ESP32_CLP\GETEWAY.sch (Sheet: 3/10)

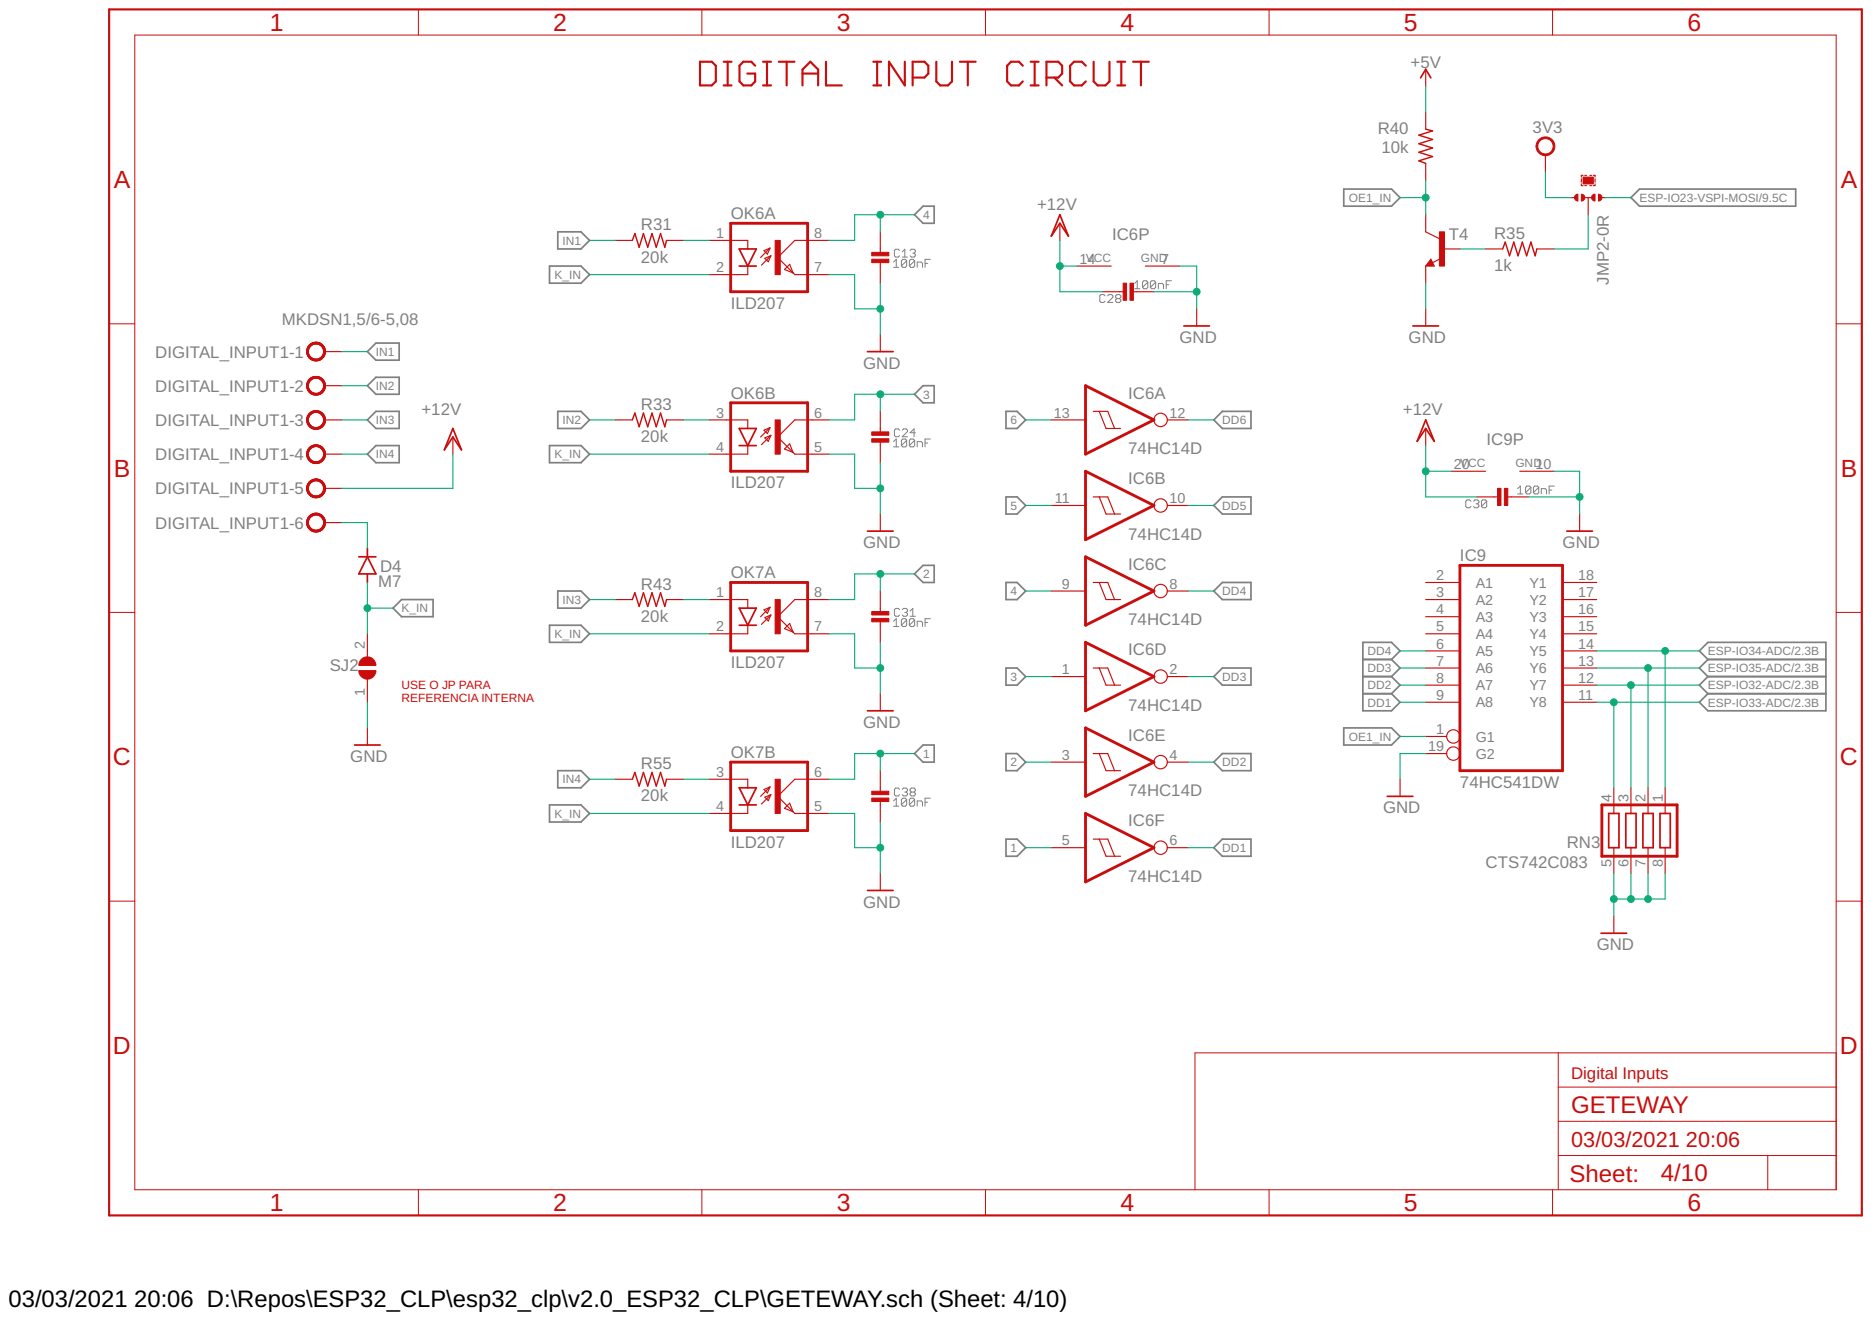
[picture p14: page 4]

USE O JP PARA REFERENCIA INTERNA

03/03/2021 20:06 D:\Repos\ESP32_CLP\esp32_clp\v2.0_ESP32_CLP\GETEWAY.sch (Sheet: 4/10)

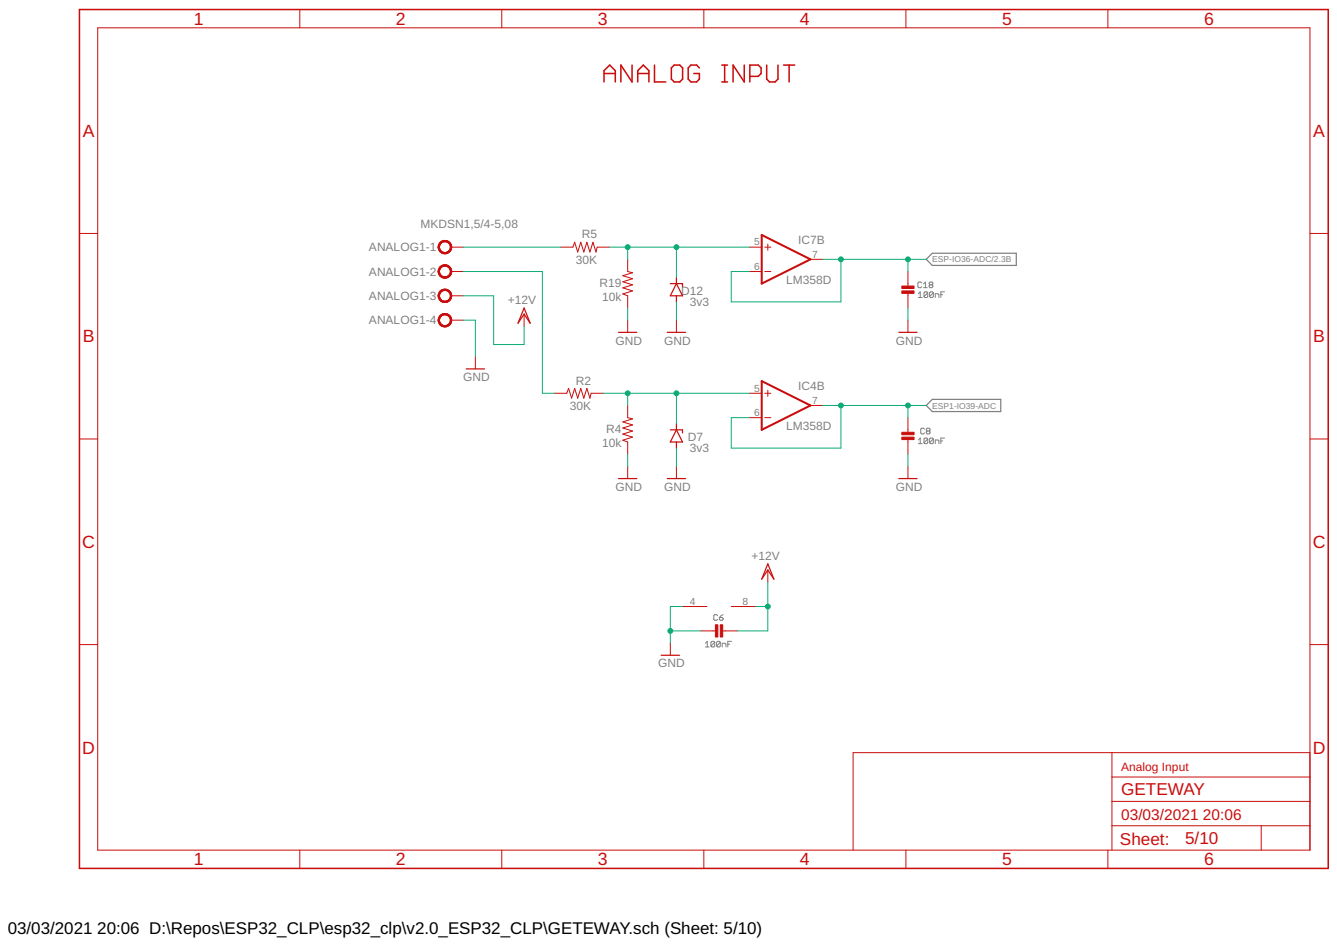
[picture p15: page 5]

03/03/2021 20:06 D:\Repos\ESP32_CLP\esp32_clp\v2.0_ESP32_CLP\GETEWAY.sch (Sheet: 5/10)

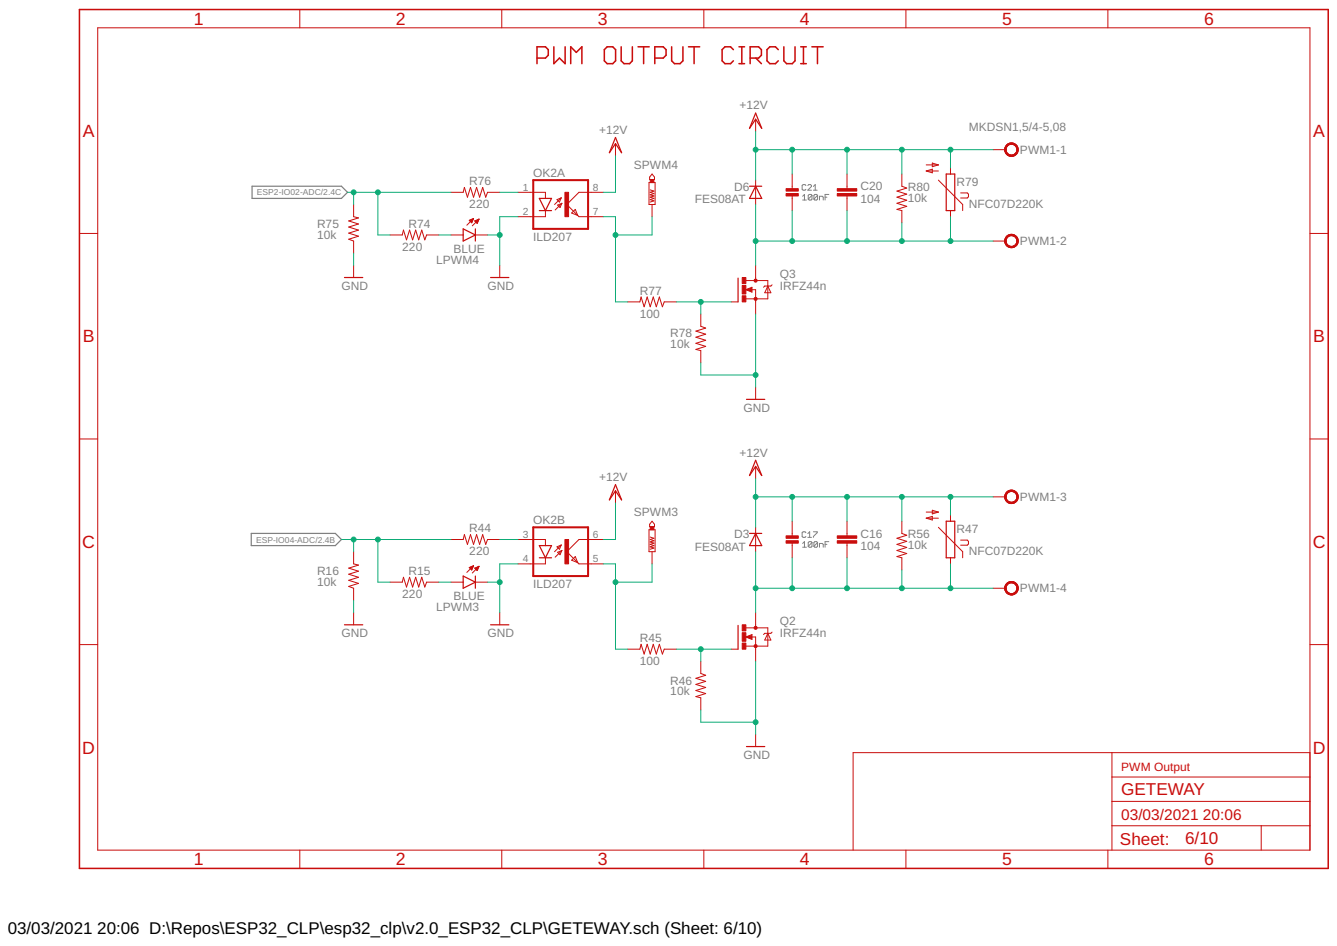
[picture p16: page 6]

03/03/2021 20:06 D:\Repos\ESP32_CLP\esp32_clp\v2.0_ESP32_CLP\GETEWAY.sch (Sheet: 6/10)

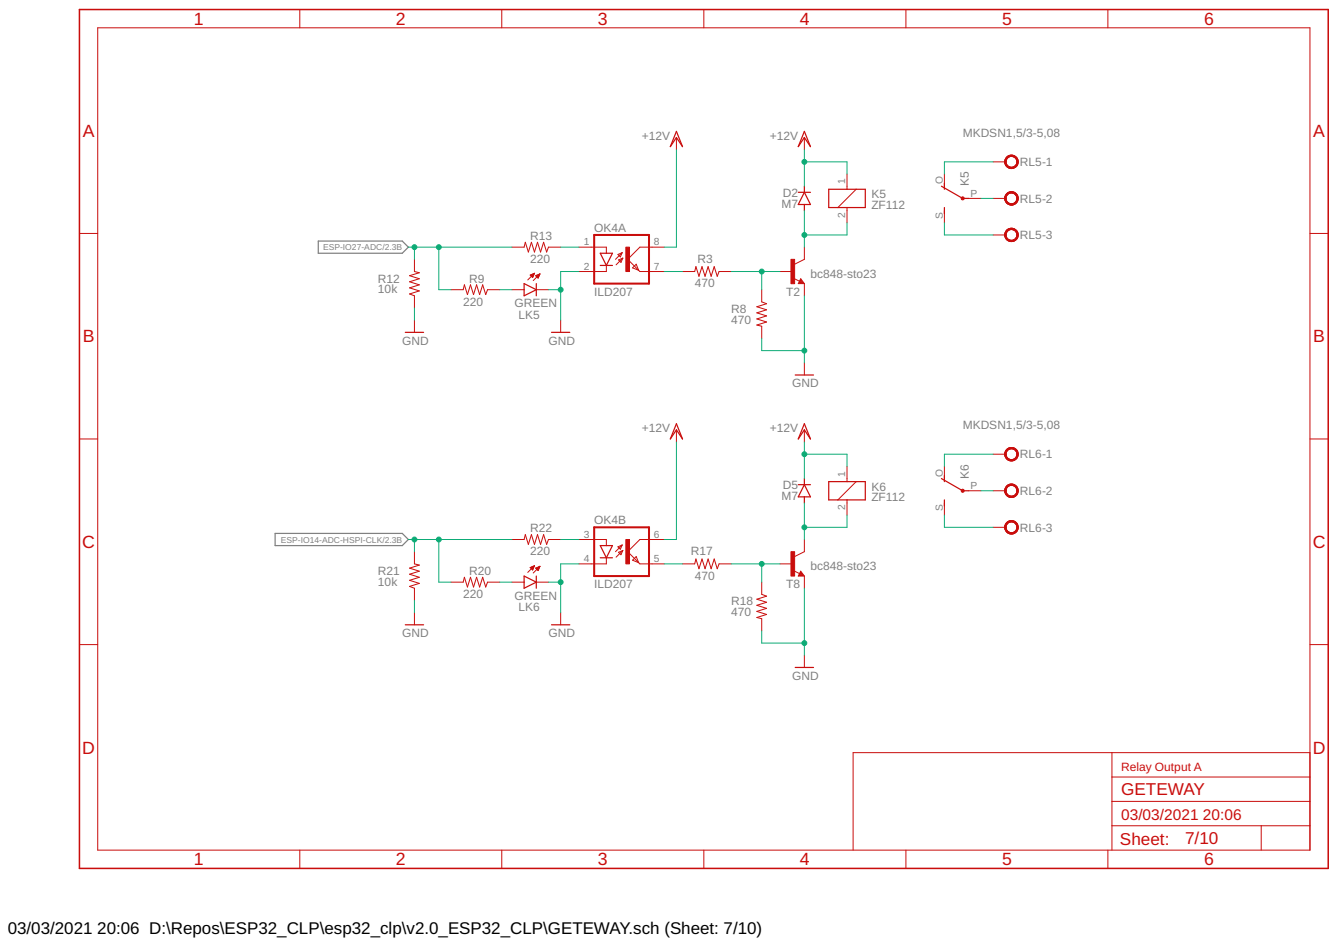
[picture p17: page 7]

ESP-IO14-ADC-HSPI-CLK/2.3B

03/03/2021 20:06 D:\Repos\ESP32_CLP\esp32_clp\v2.0_ESP32_CLP\GETEWAY.sch (Sheet: 7/10)

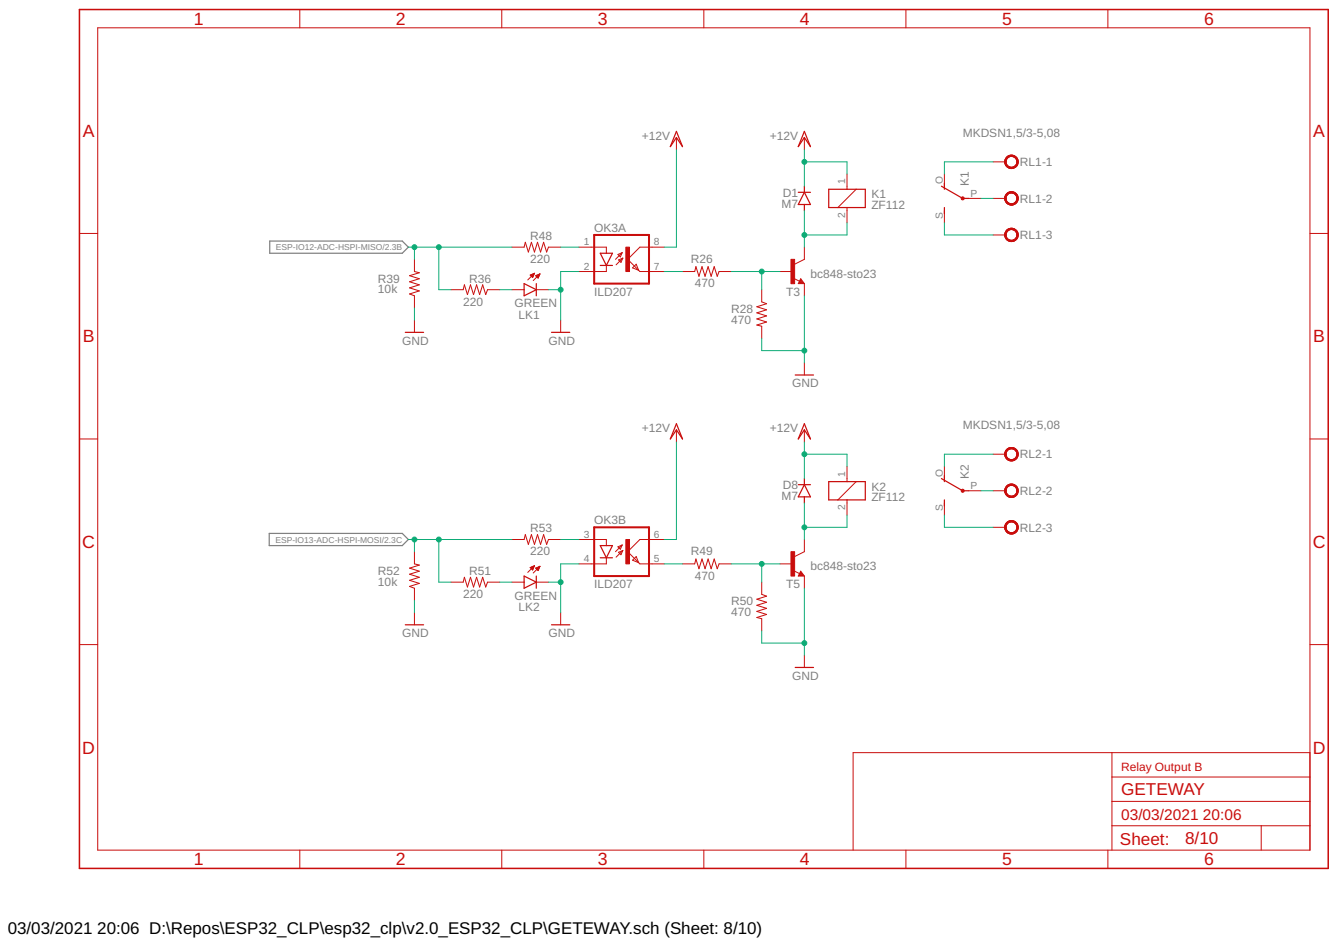
[picture p18: page 8]

ESP-IO12-ADC-HSPI-MISO/2.3B

ESP-IO13-ADC-HSPI-MOSI/2.3C

03/03/2021 20:06 D:\Repos\ESP32_CLP\esp32_clp\v2.0_ESP32_CLP\GETEWAY.sch (Sheet: 8/10)

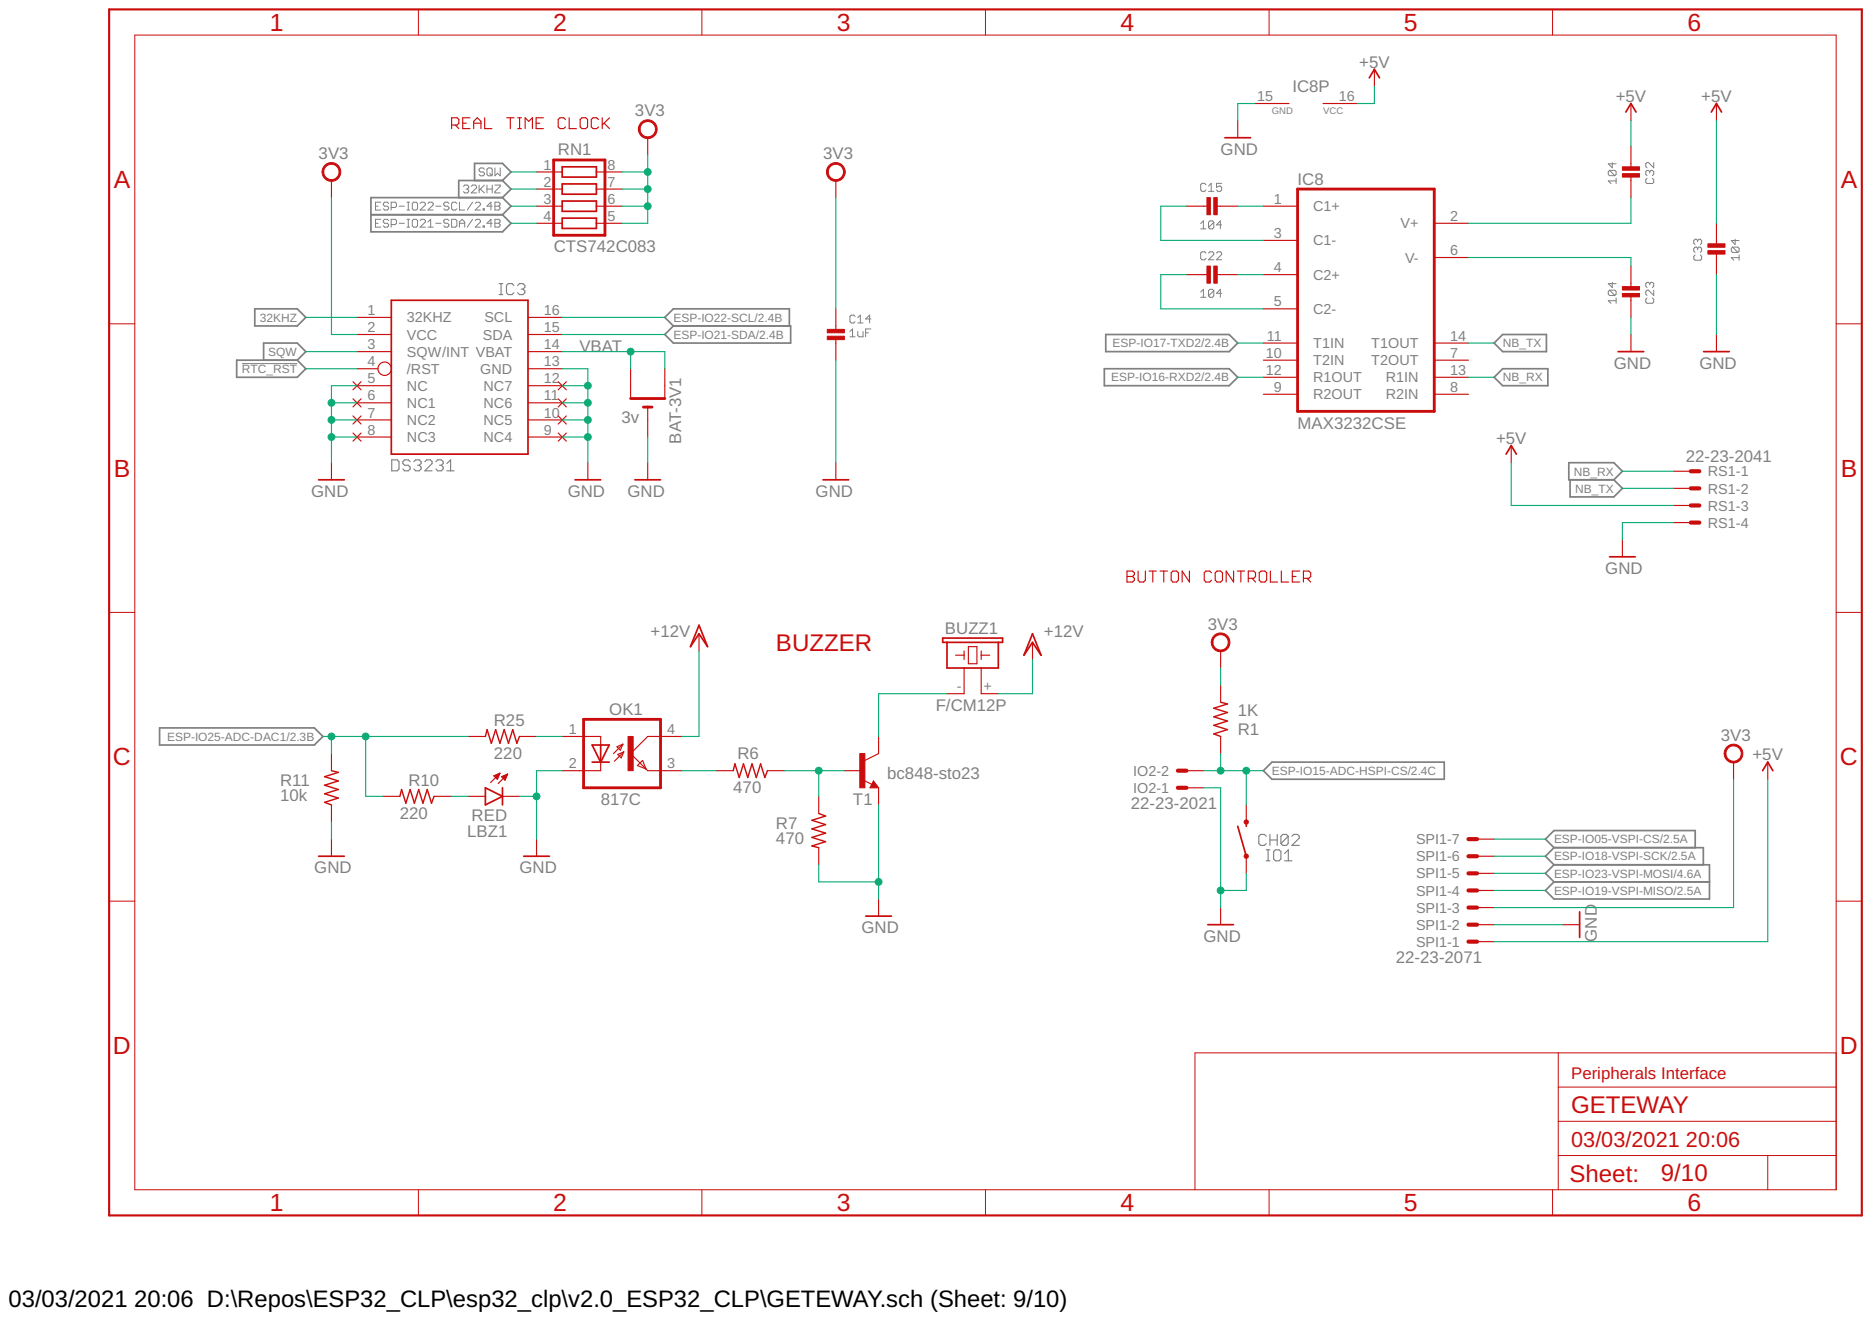
[picture p19: page 9]

ESP-IO15-ADC-HSPI-CS/2.4C

03/03/2021 20:06 D:\Repos\ESP32_CLP\esp32_clp\v2.0_ESP32_CLP\GETEWAY.sch (Sheet: 9/10)

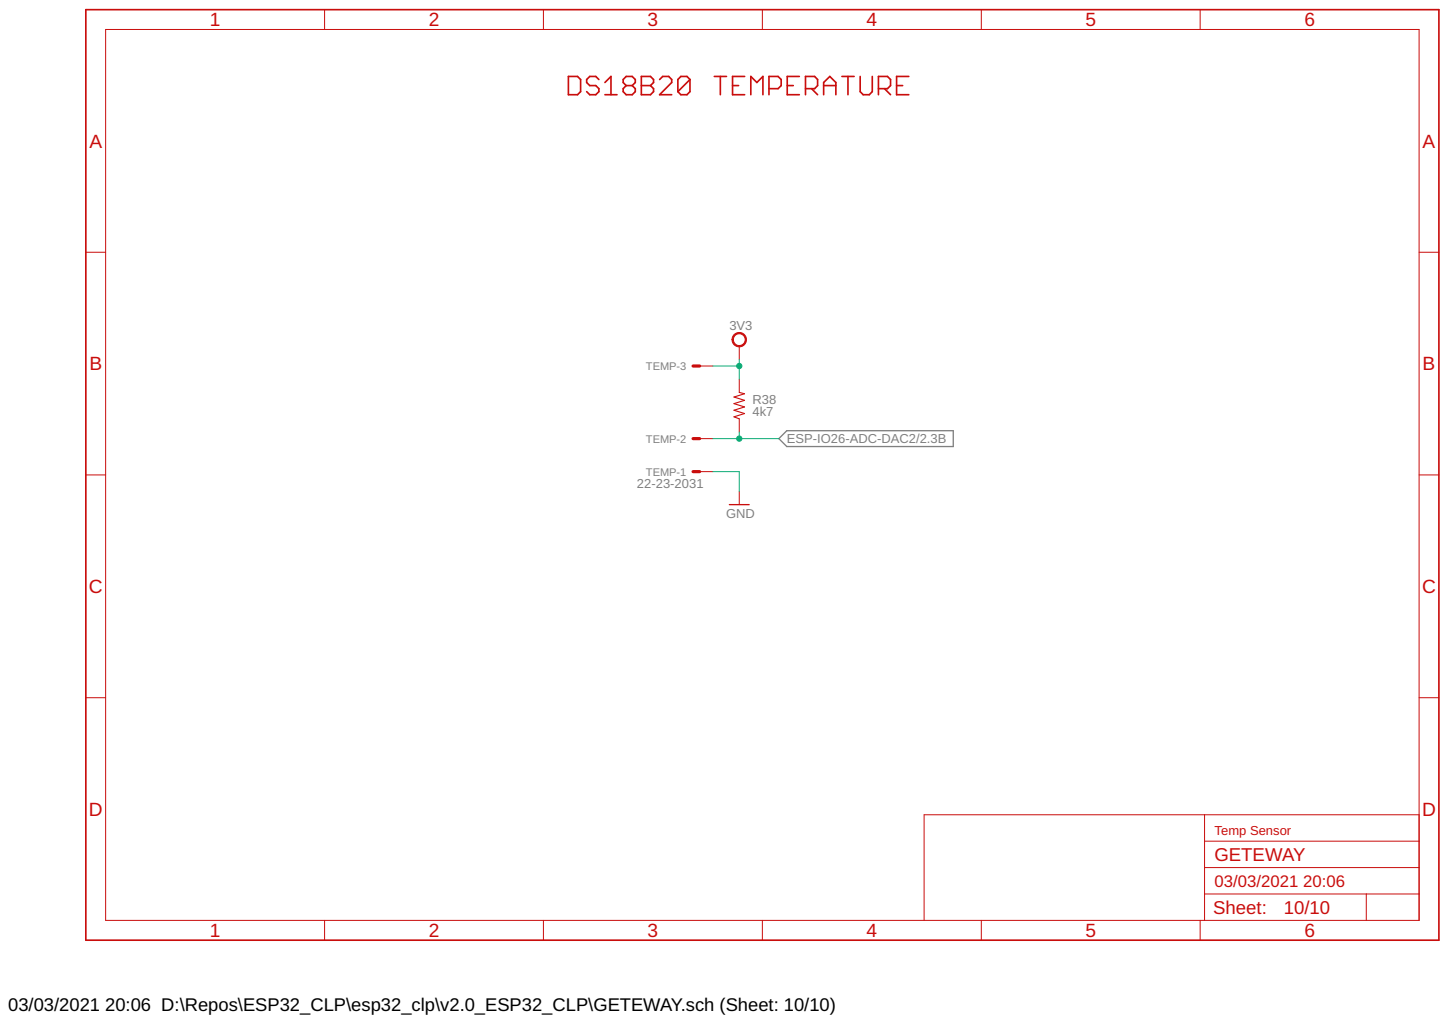
[picture p20: page 10]

03/03/2021 20:06 D:\Repos\ESP32_CLP\esp32_clp\v2.0_ESP32_CLP\GETEWAY.sch (Sheet: 10/10)
