AthenasArch/ESP32-CLP-Parana-V1.0/v2.0_ESP32_CLP/GETEWAY.pdf

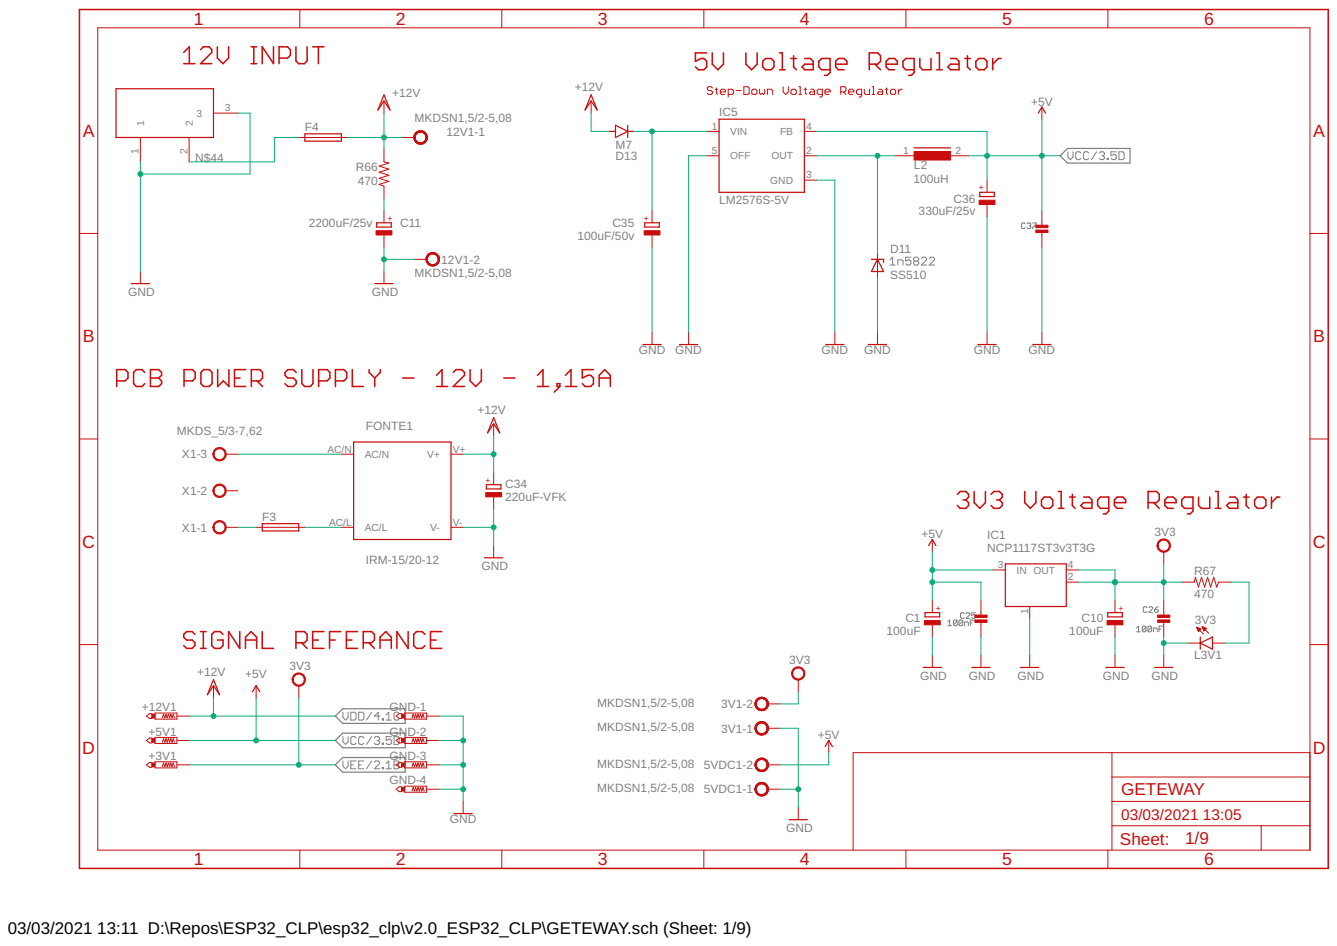
[picture p21: page 1]

03/03/2021 13:11 D:\Repos\ESP32_CLP\esp32_clp\v2.0_ESP32_CLP\GETEWAY.sch (Sheet: 1/9)

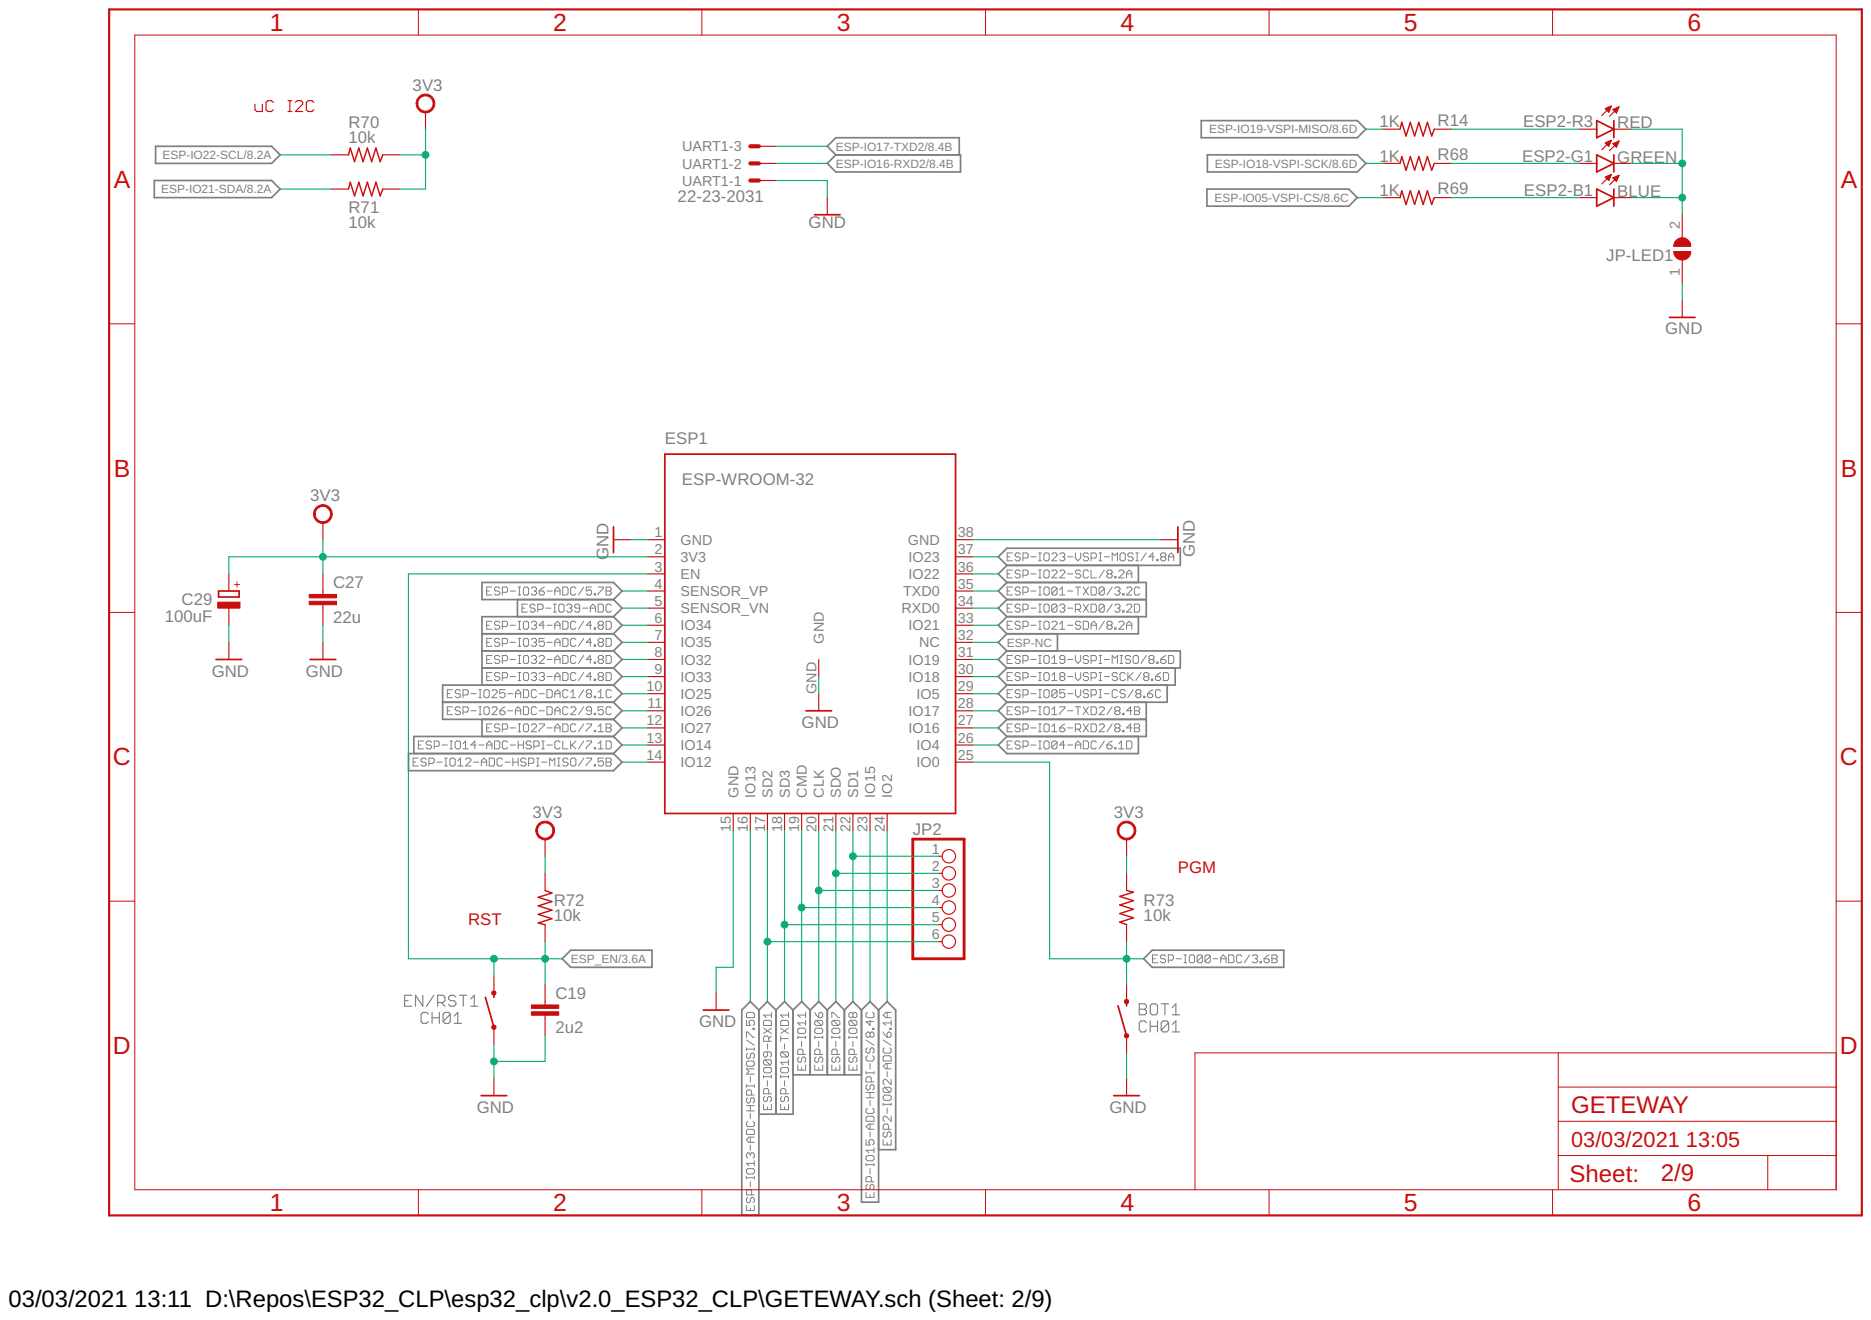
[picture p22: page 2]

03/03/2021 13:11 D:\Repos\ESP32_CLP\esp32_clp\v2.0_ESP32_CLP\GETEWAY.sch (Sheet: 2/9)

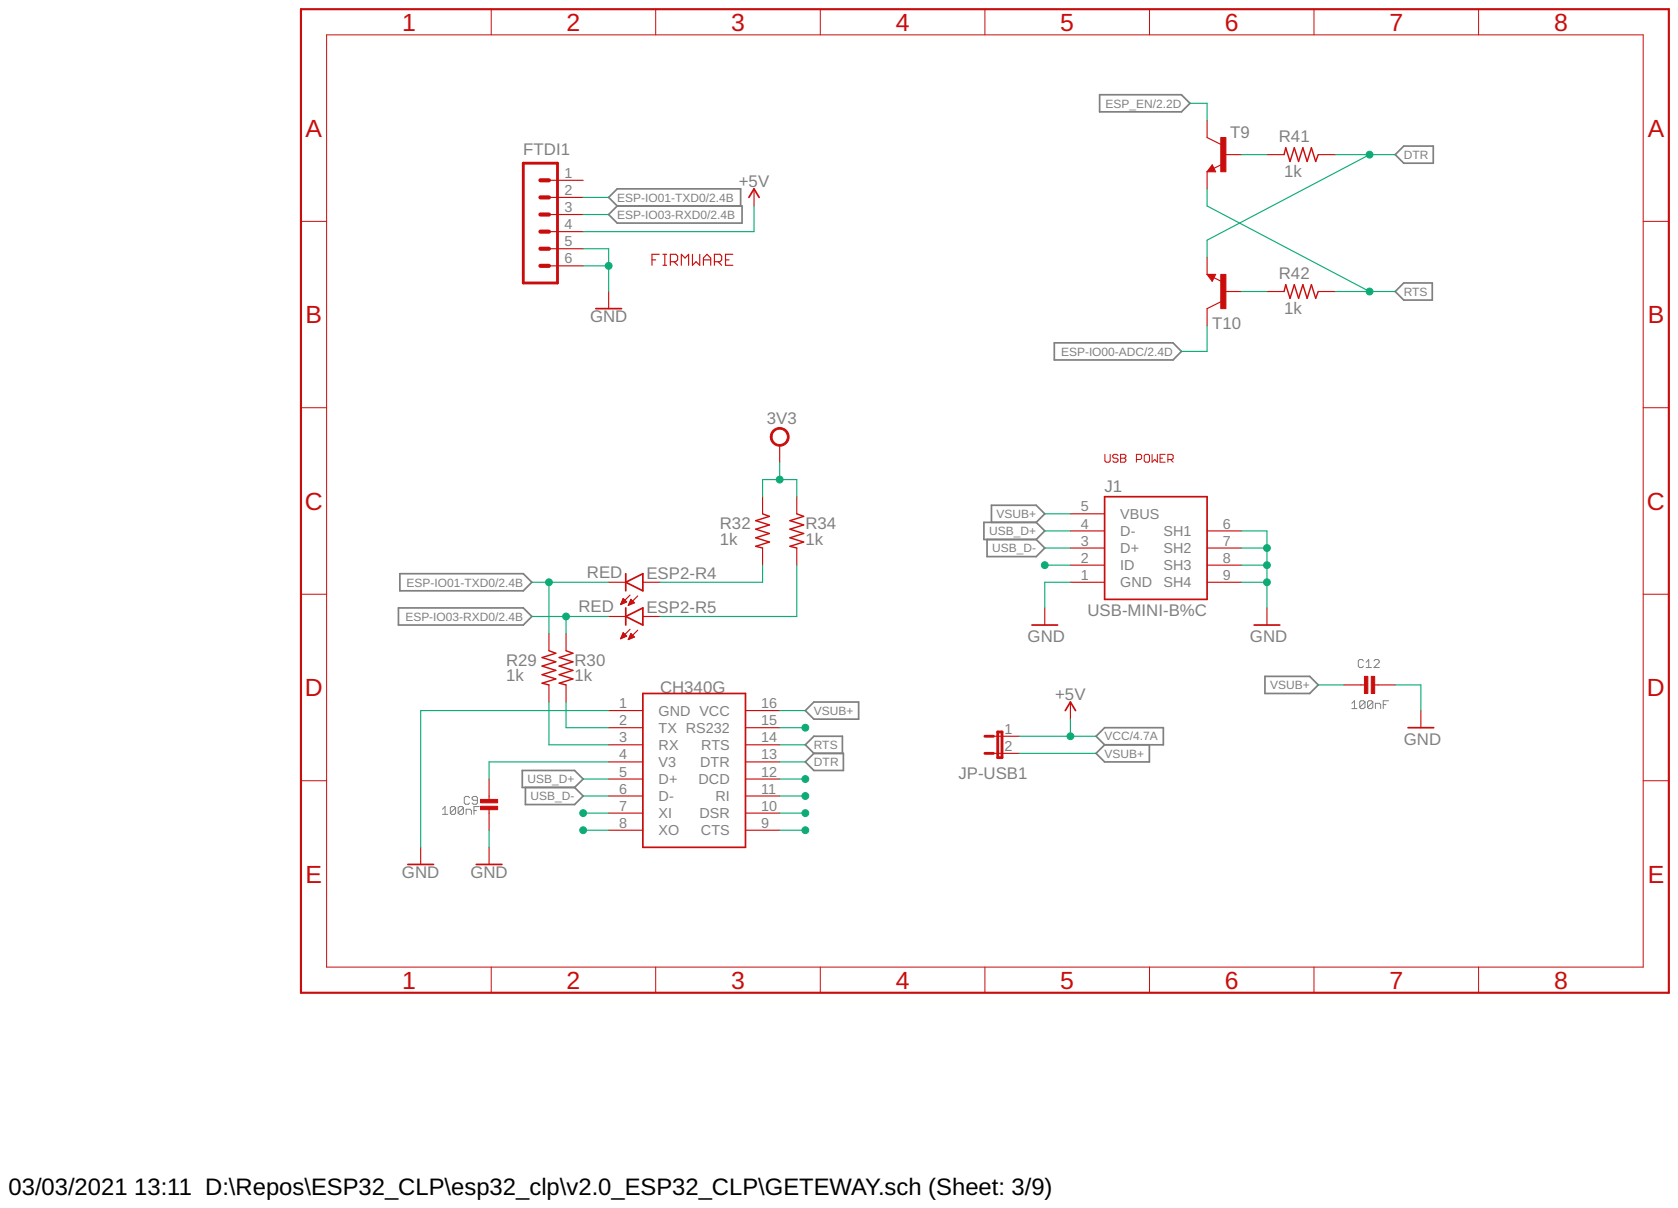
[picture p23: page 3]

03/03/2021 13:11 D:\Repos\ESP32_CLP\esp32_clp\v2.0_ESP32_CLP\GETEWAY.sch (Sheet: 3/9)

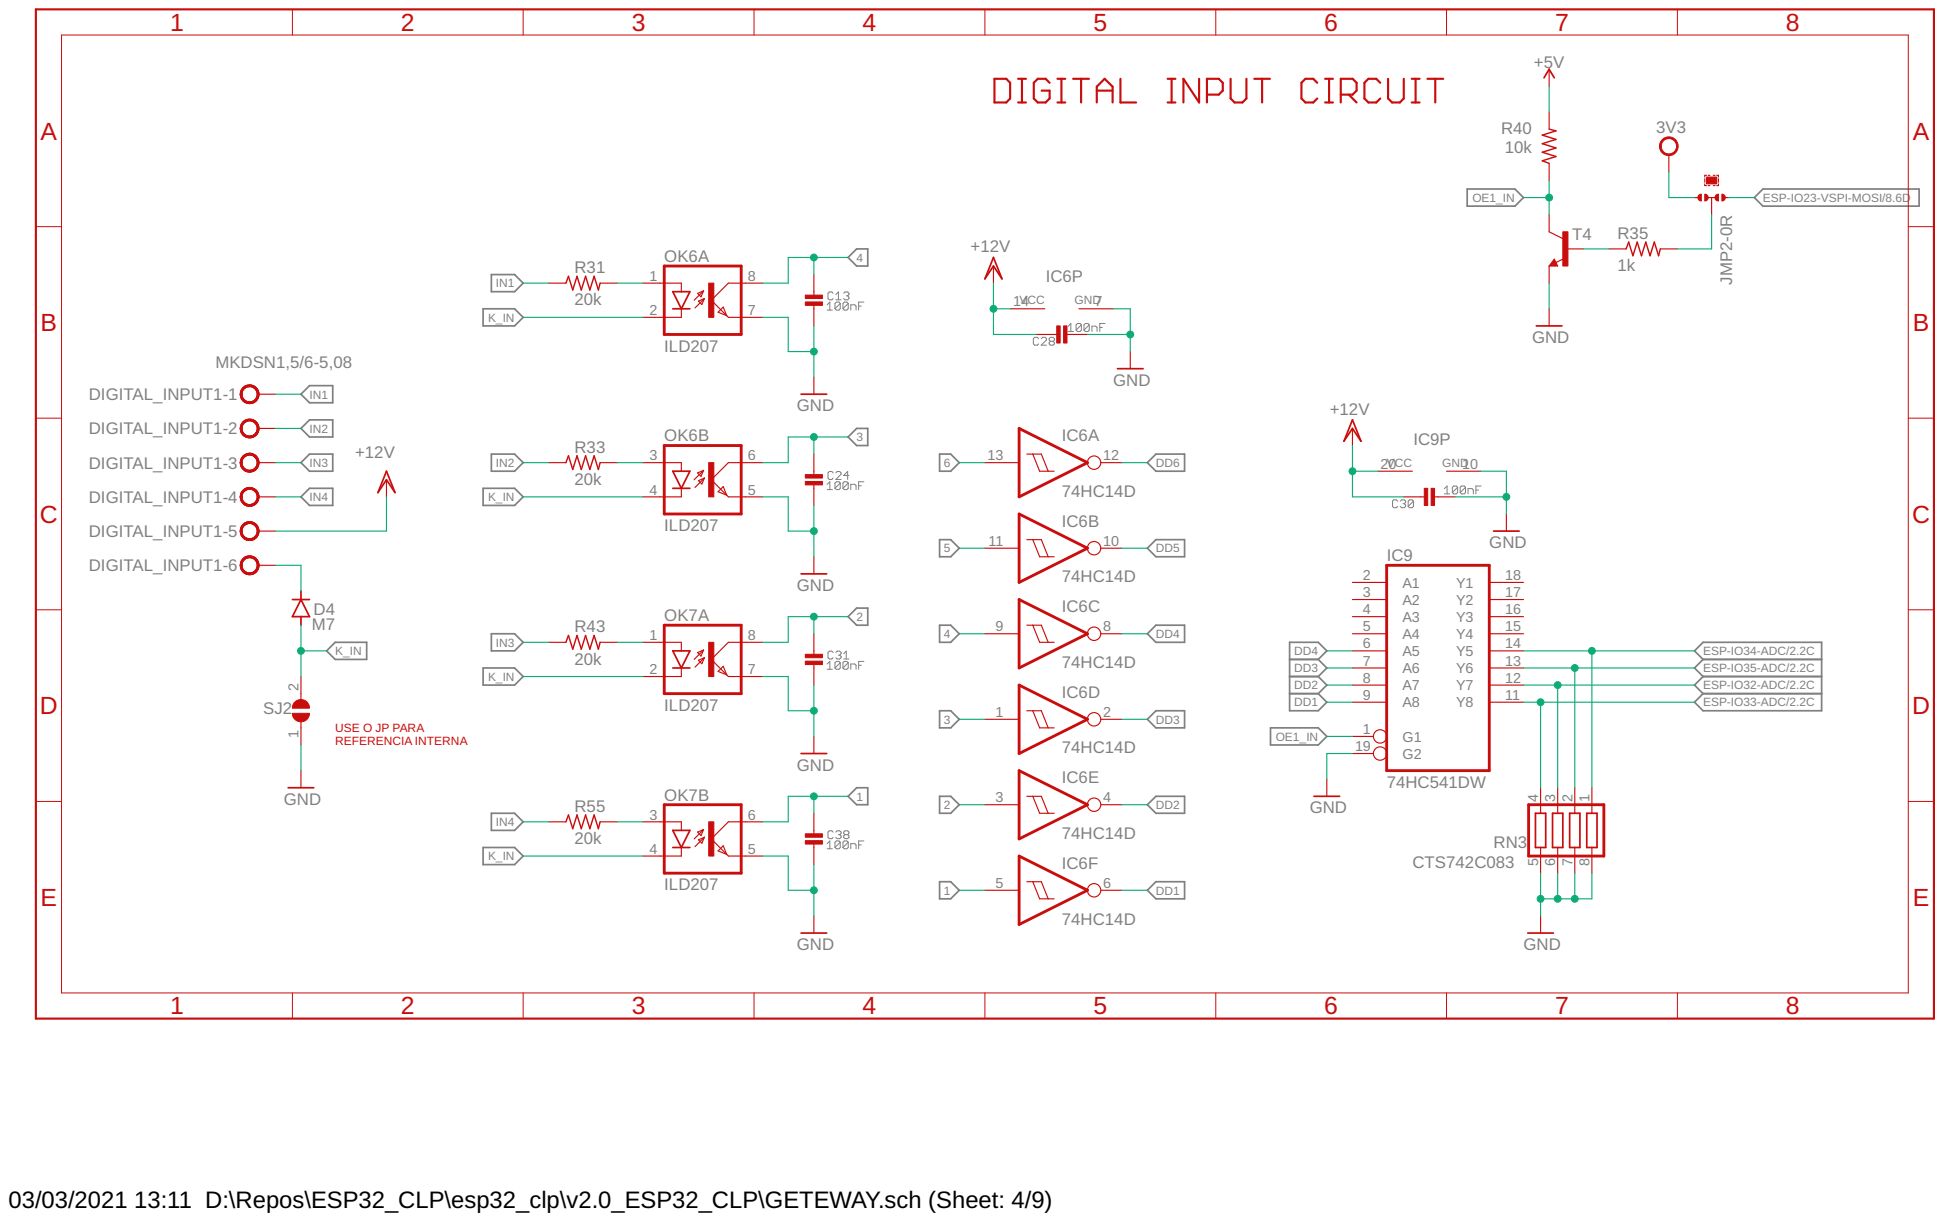
[picture p24: page 4]

USE O JP PARA REFERENCIA INTERNA

03/03/2021 13:11 D:\Repos\ESP32_CLP\esp32_clp\v2.0_ESP32_CLP\GETEWAY.sch (Sheet: 4/9)

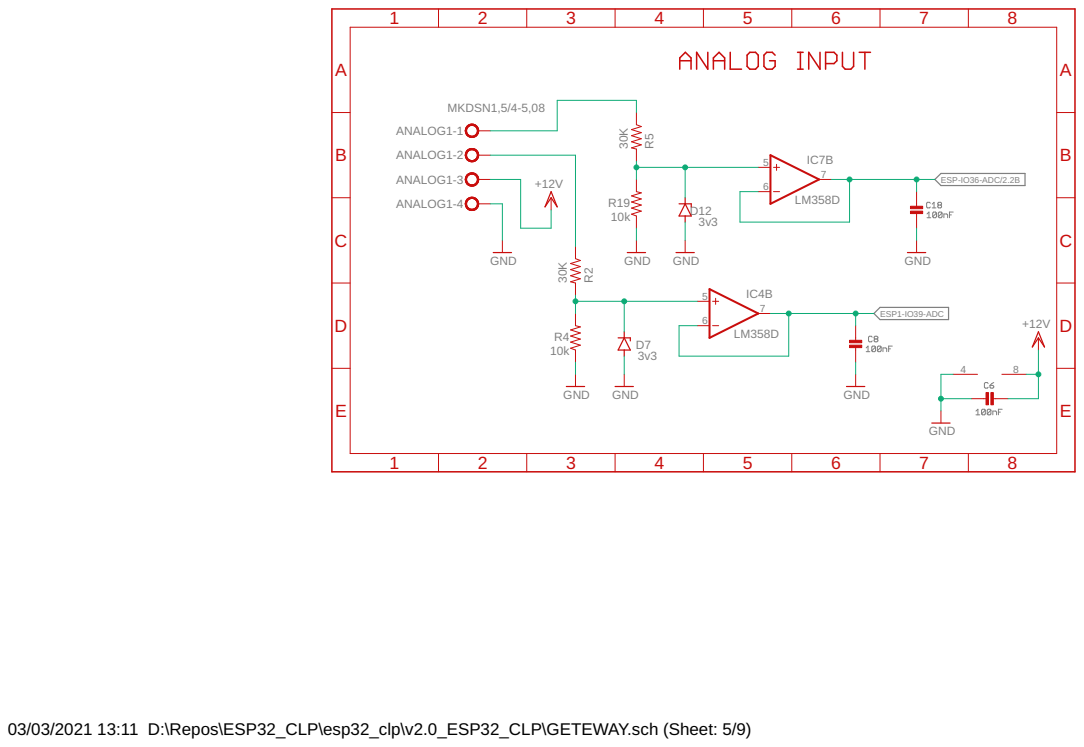
[picture p25: page 5]

03/03/2021 13:11 D:\Repos\ESP32_CLP\esp32_clp\v2.0_ESP32_CLP\GETEWAY.sch (Sheet: 5/9)

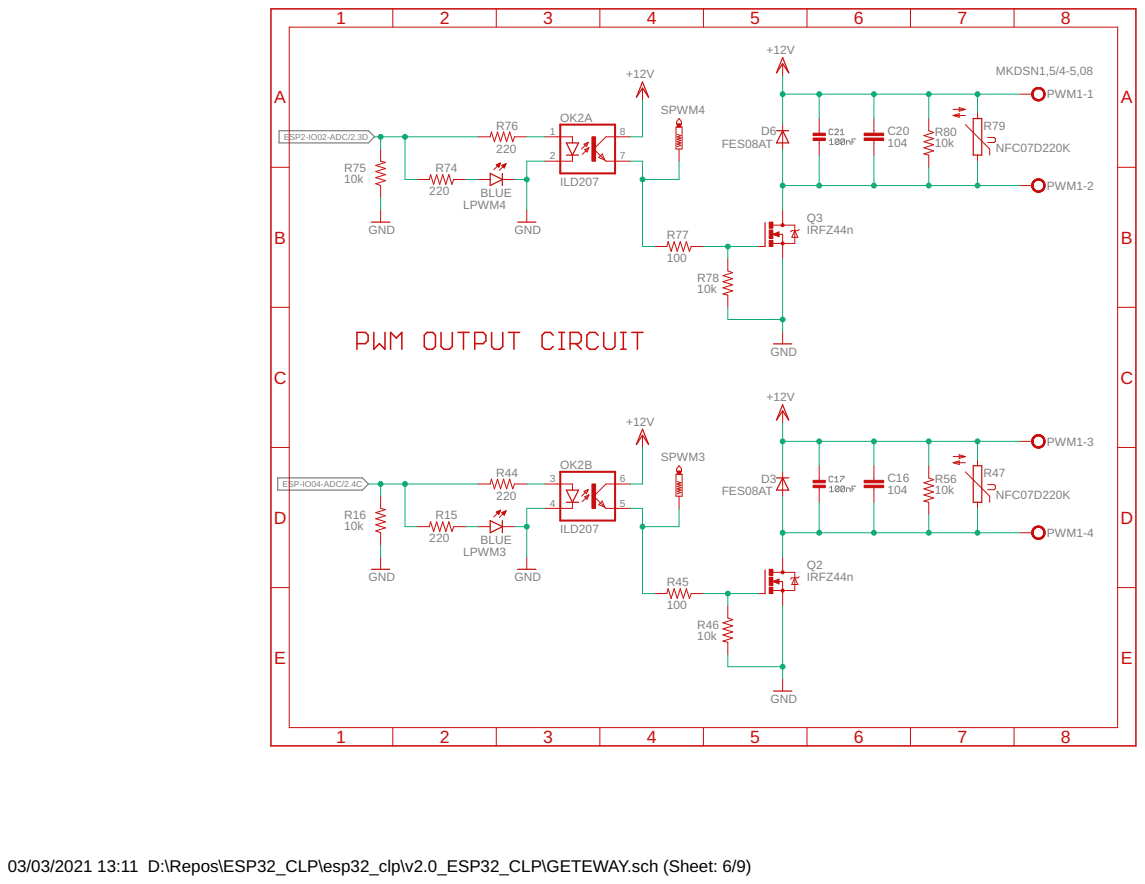
[picture p26: page 6]

03/03/2021 13:11 D:\Repos\ESP32_CLP\esp32_clp\v2.0_ESP32_CLP\GETEWAY.sch (Sheet: 6/9)

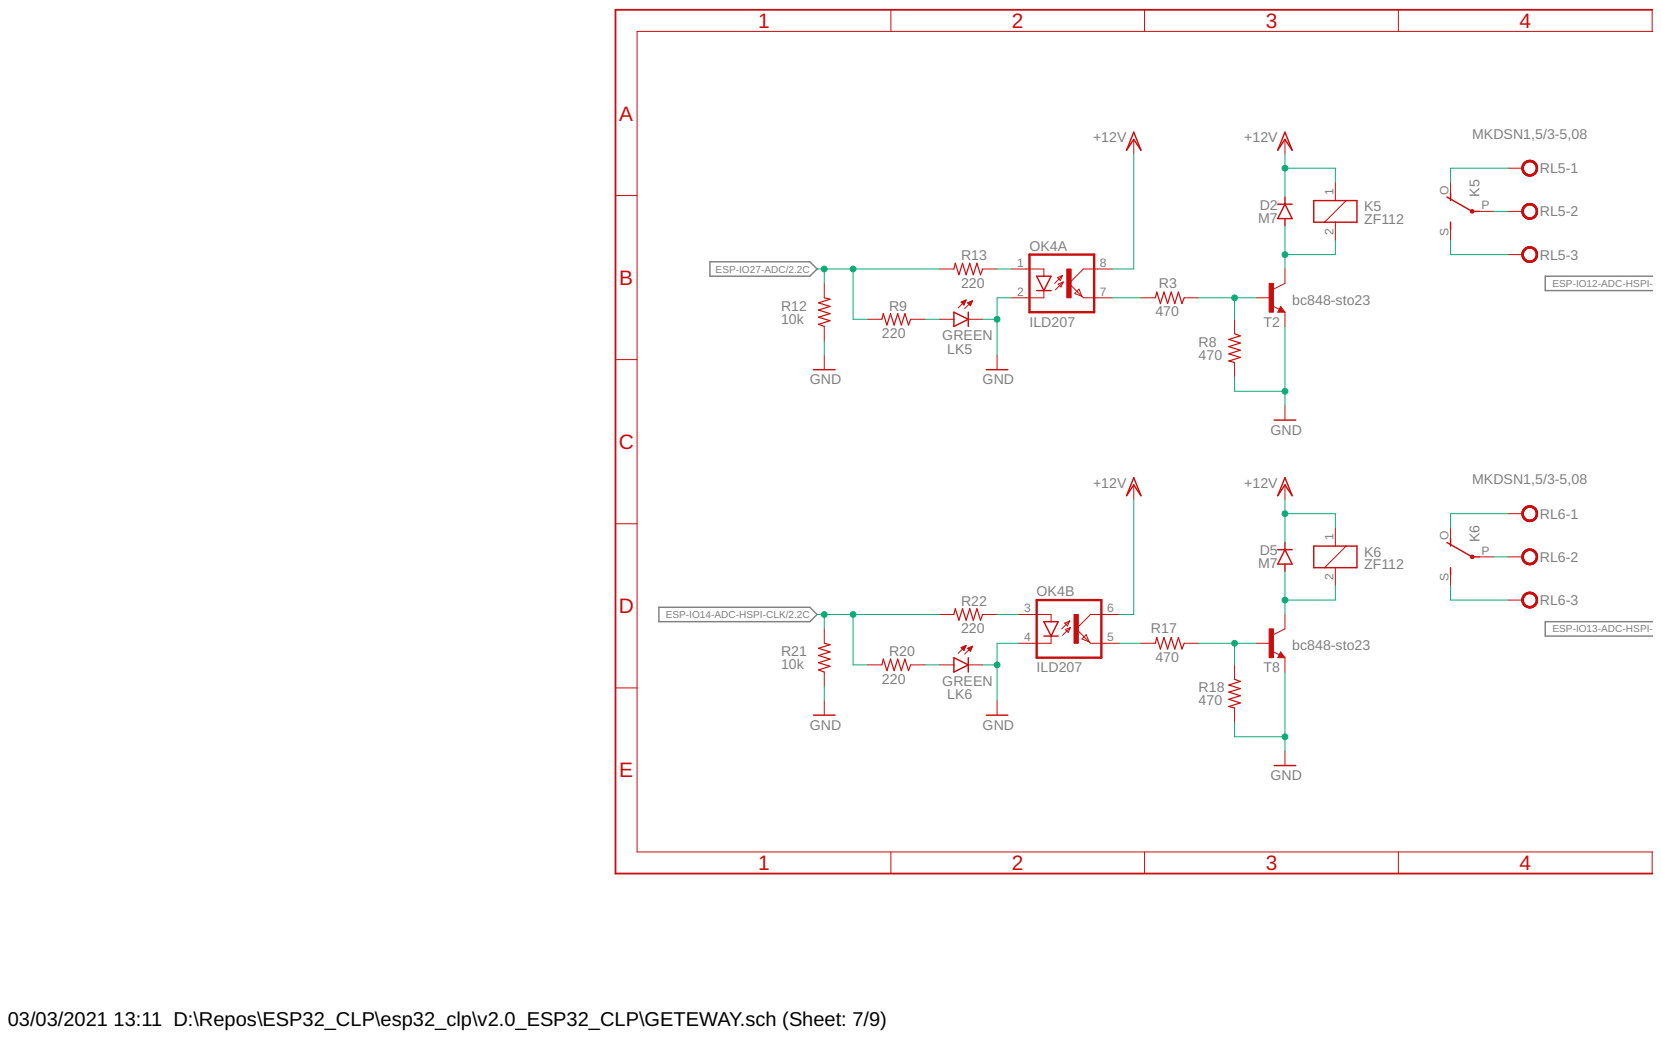
[picture p27: page 7]

ESP-IO14-ADC-HSPI-CLK/2.2C

03/03/2021 13:11 D:\Repos\ESP32_CLP\esp32_clp\v2.0_ESP32_CLP\GETEWAY.sch (Sheet: 7/9)

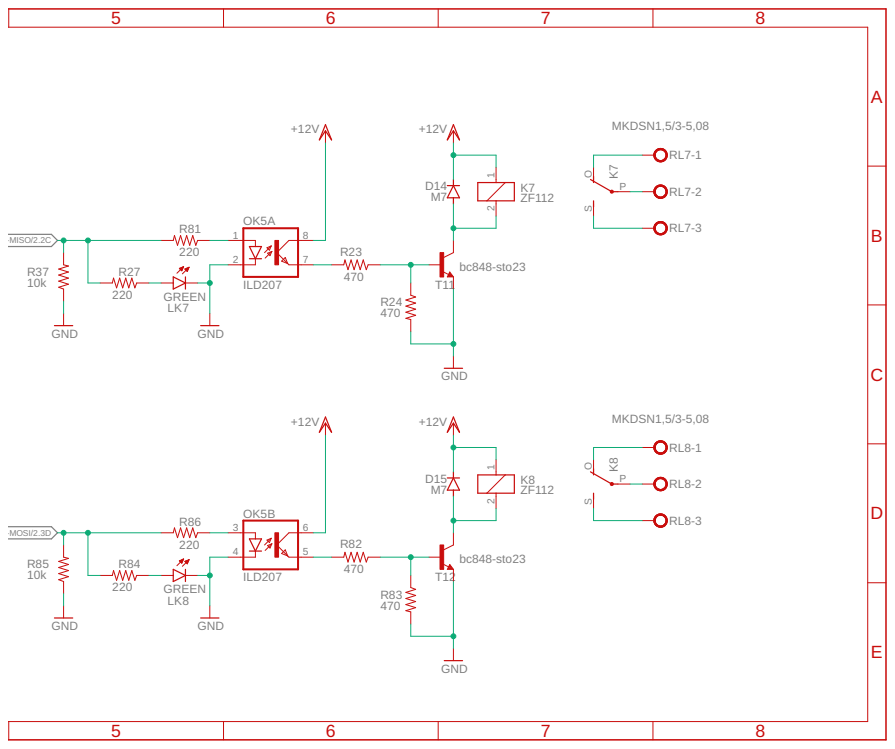
[picture p28: page 8]

ESP-IO12-ADC-HSPI-MISO/2.2C

ESP-IO13-ADC-HSPI-MOSI/2.3D

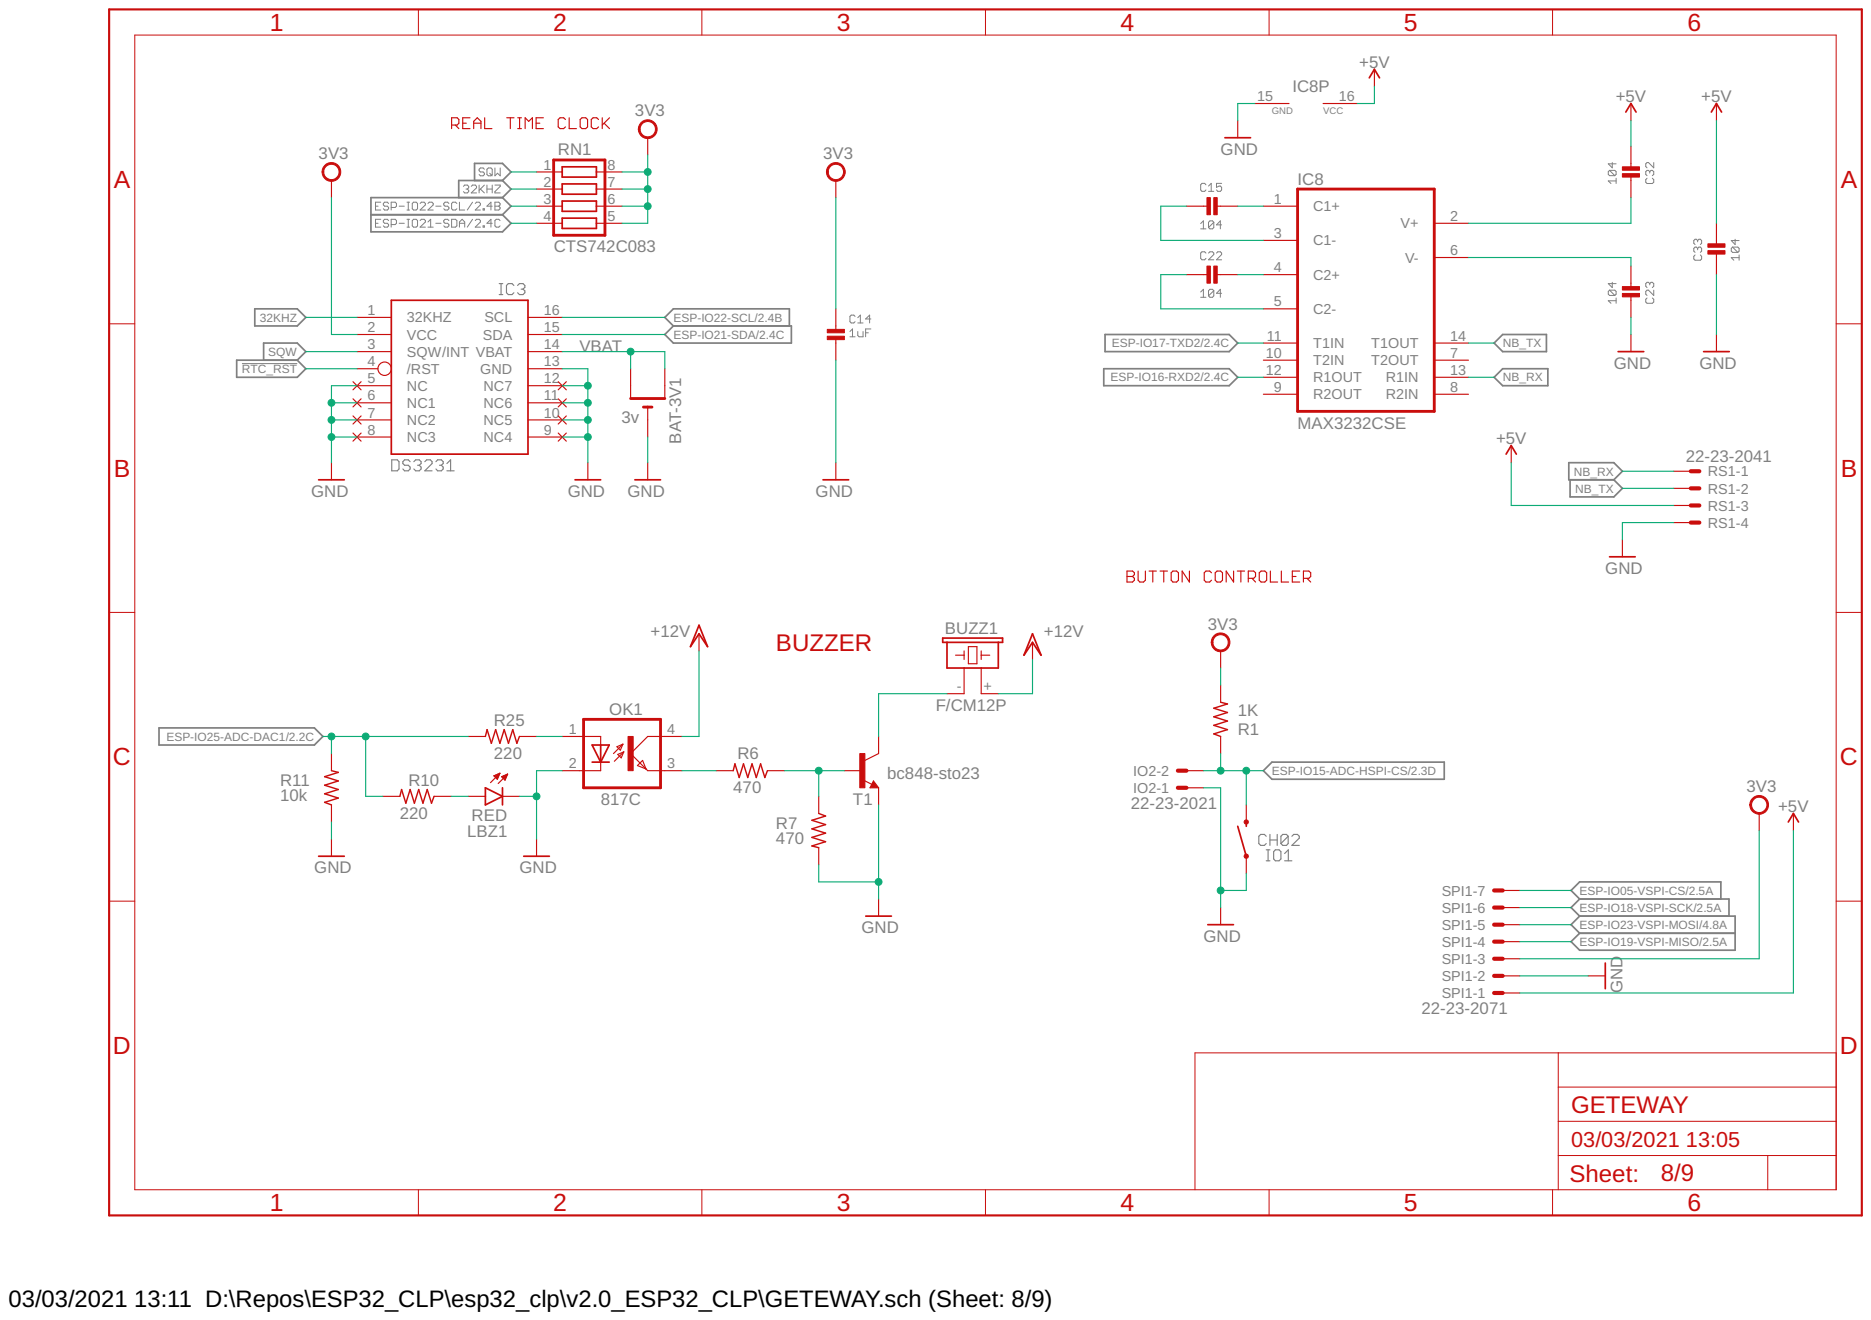
[picture p29: page 9]

ESP-IO15-ADC-HSPI-CS/2.3D

03/03/2021 13:11 D:\Repos\ESP32_CLP\esp32_clp\v2.0_ESP32_CLP\GETEWAY.sch (Sheet: 8/9)

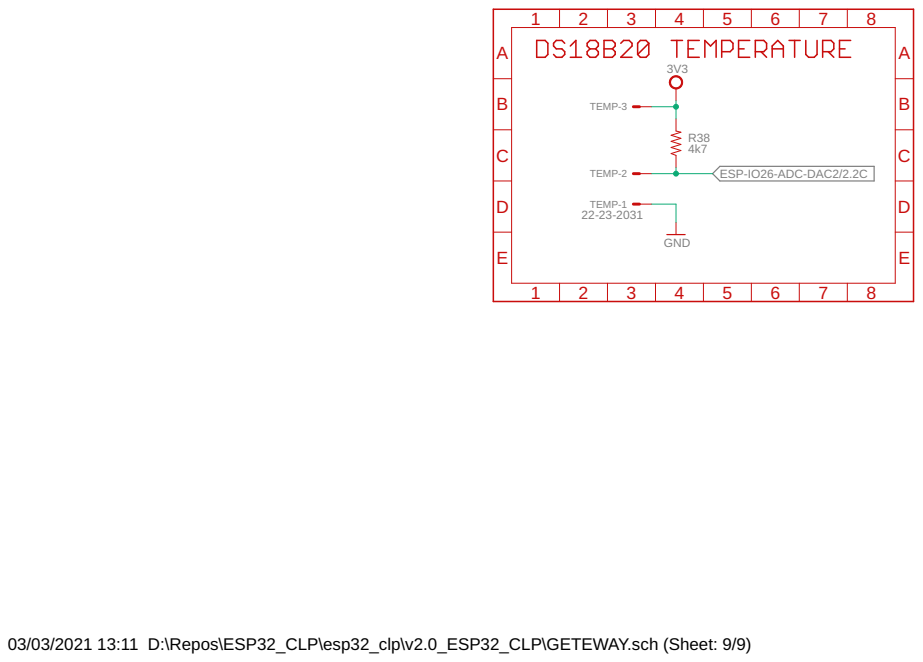
[picture p30: page 10]

03/03/2021 13:11 D:\Repos\ESP32_CLP\esp32_clp\v2.0_ESP32_CLP\GETEWAY.sch (Sheet: 9/9)
