AthenasArch/ESP32-CLP-Parana-V1.0/v2.0_ESP32_CLP/GETEWAY.brd

## EAGLE design v2.0_ESP32_CLP/GETEWAY.brd (2022-11-21)

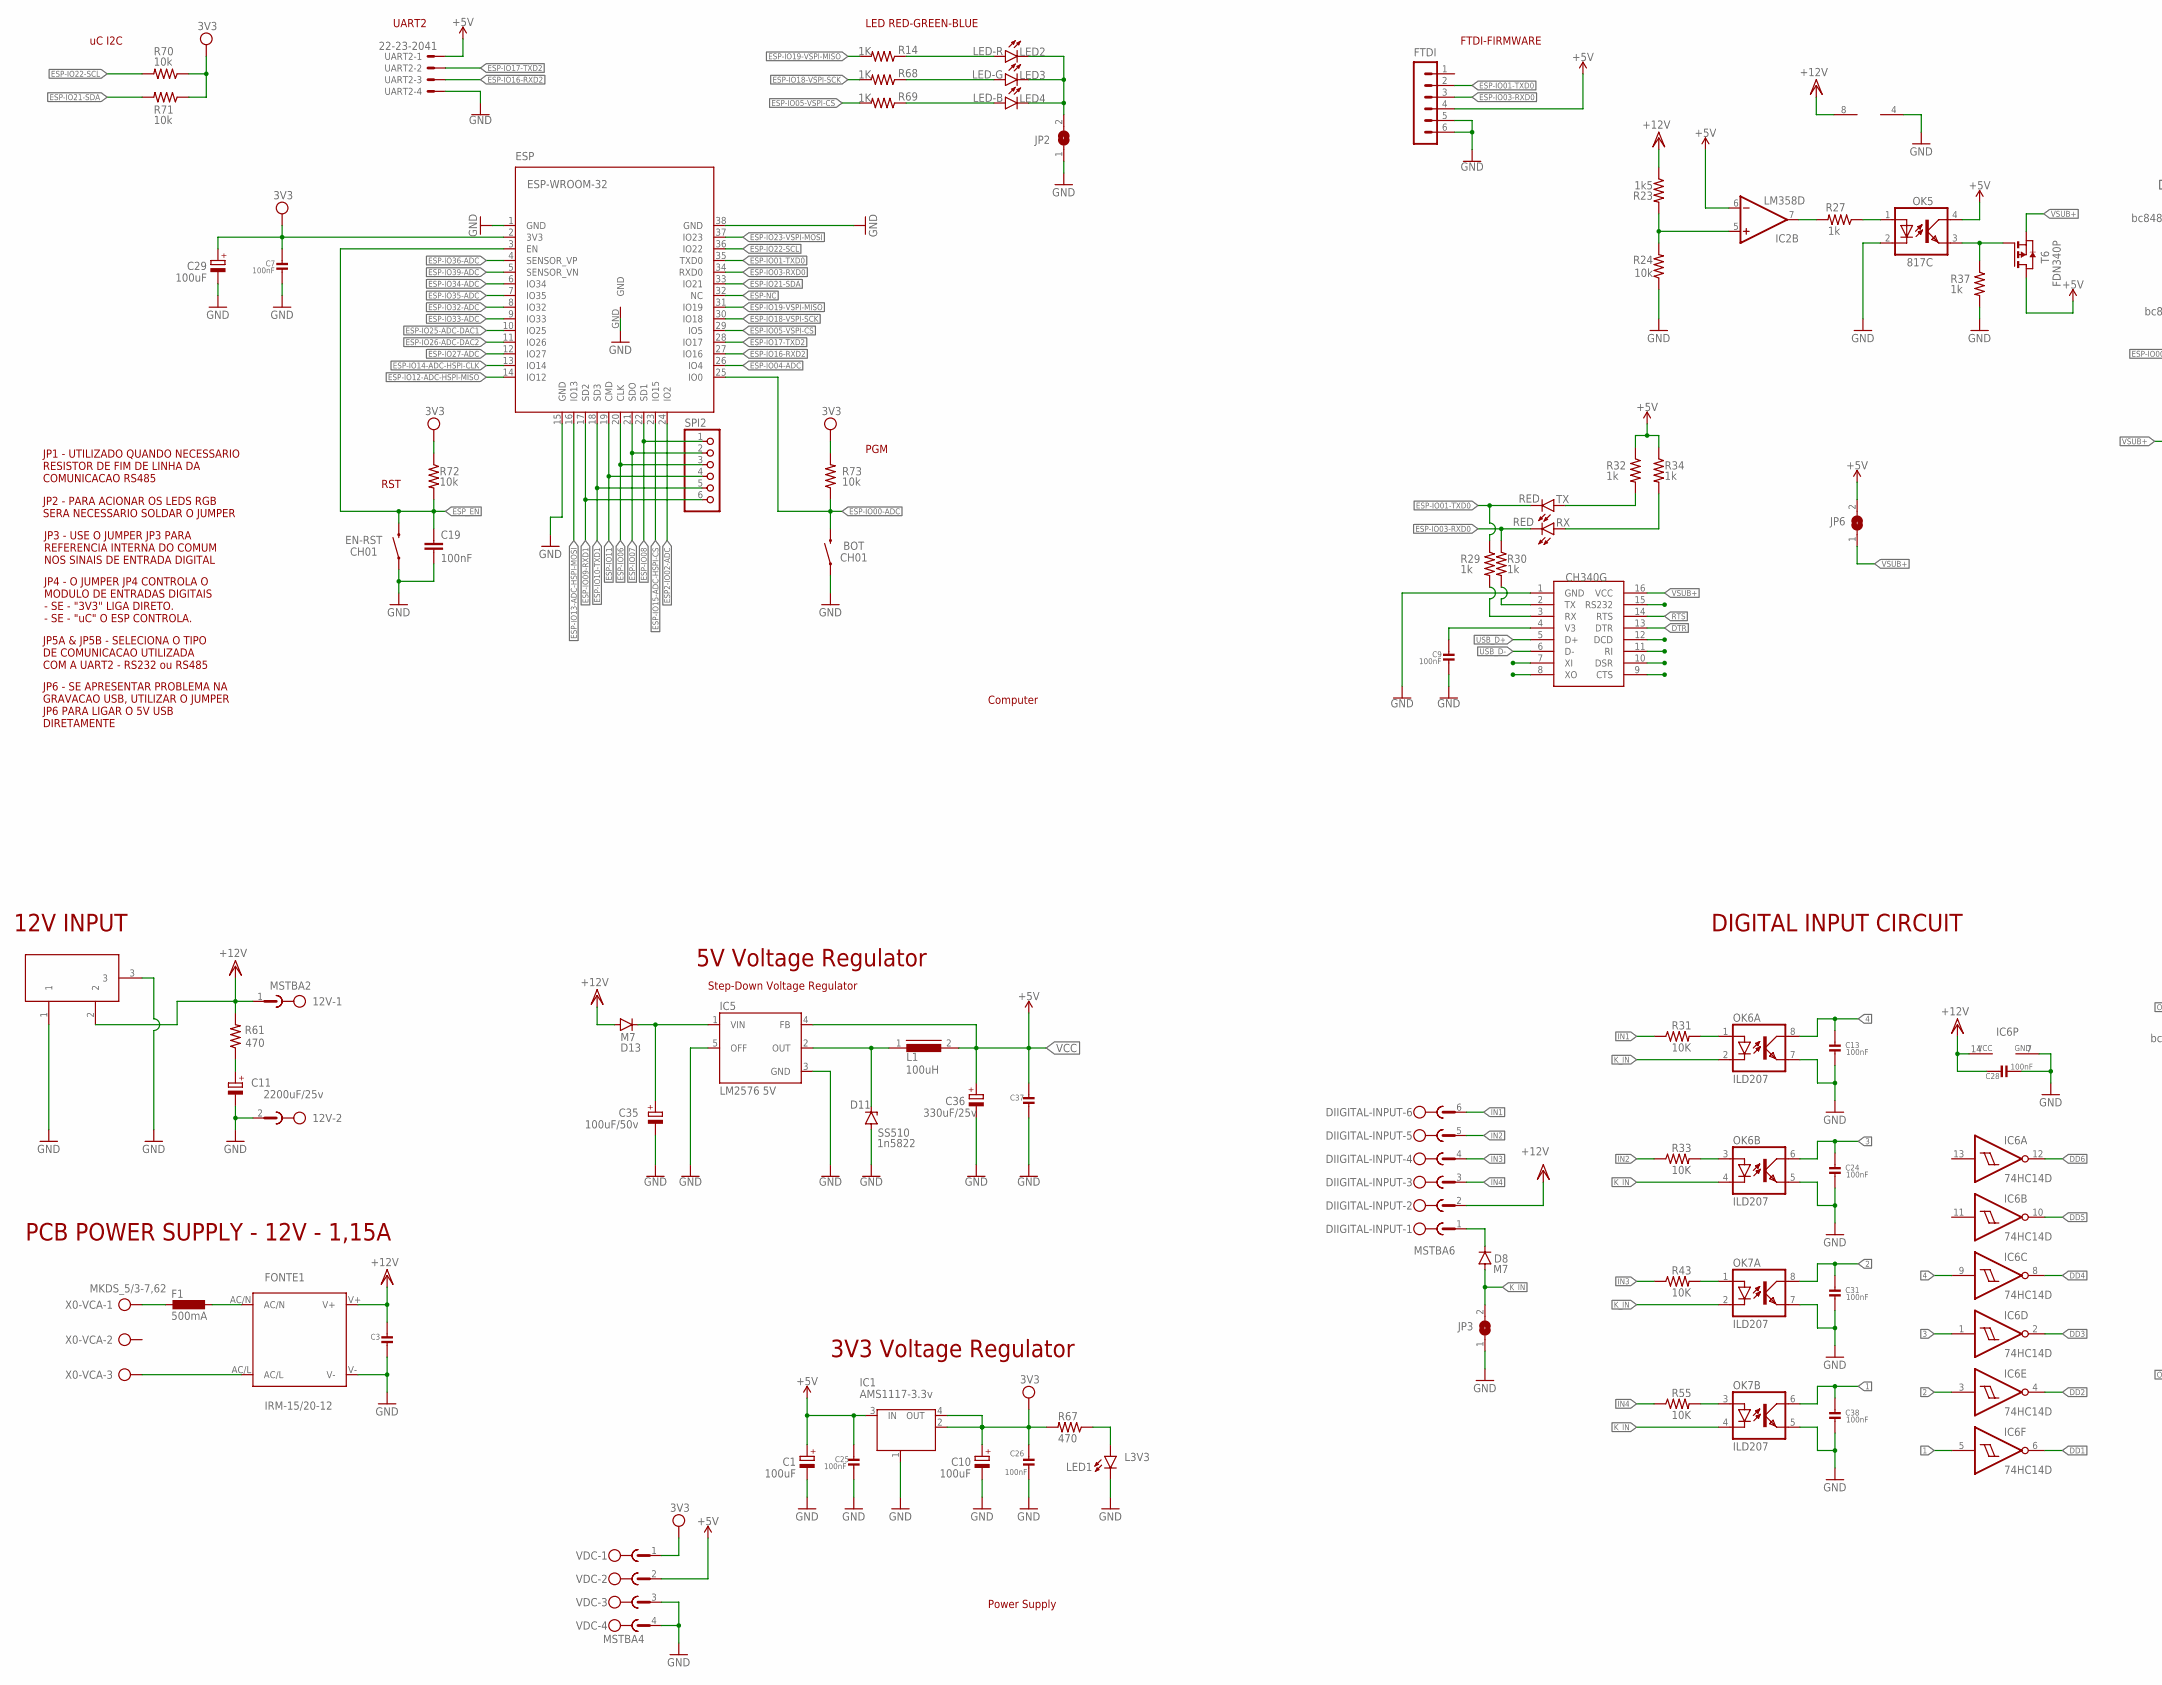
[picture p31: schematic GETEWAY.sch, sheet 1, part in row 1, column 1]

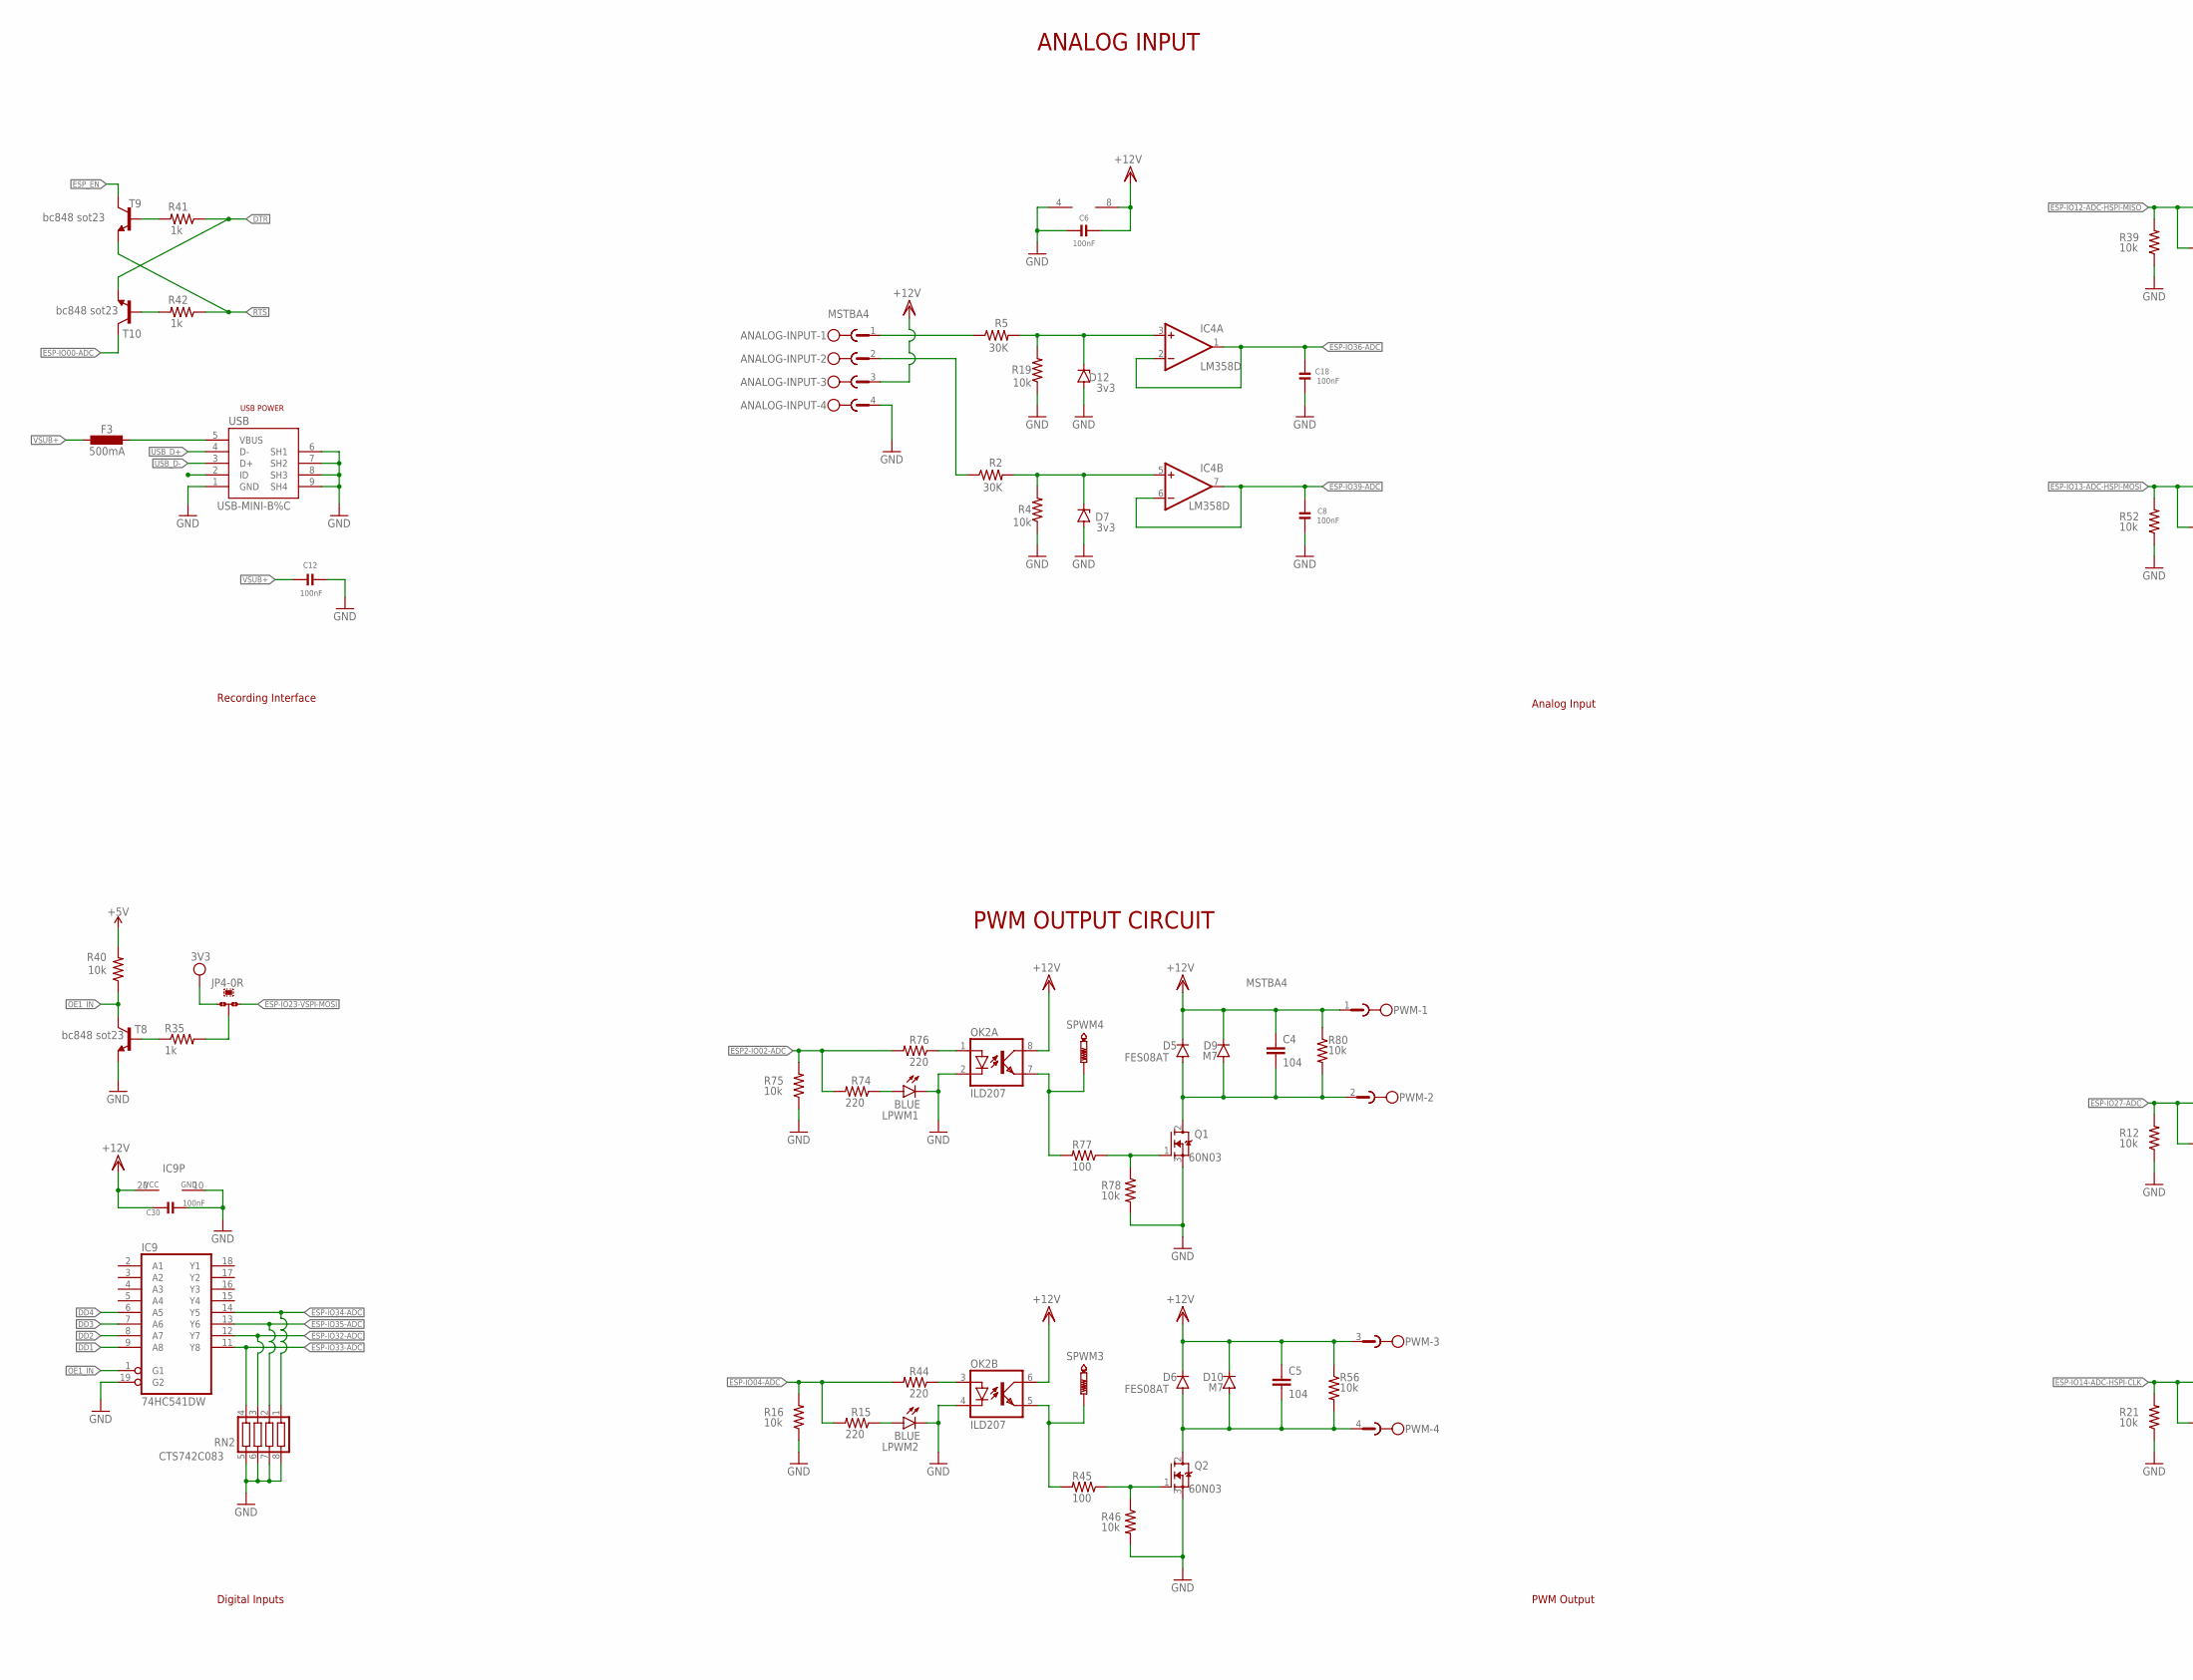
[picture p32: schematic GETEWAY.sch, sheet 1, part in row 1, column 2]

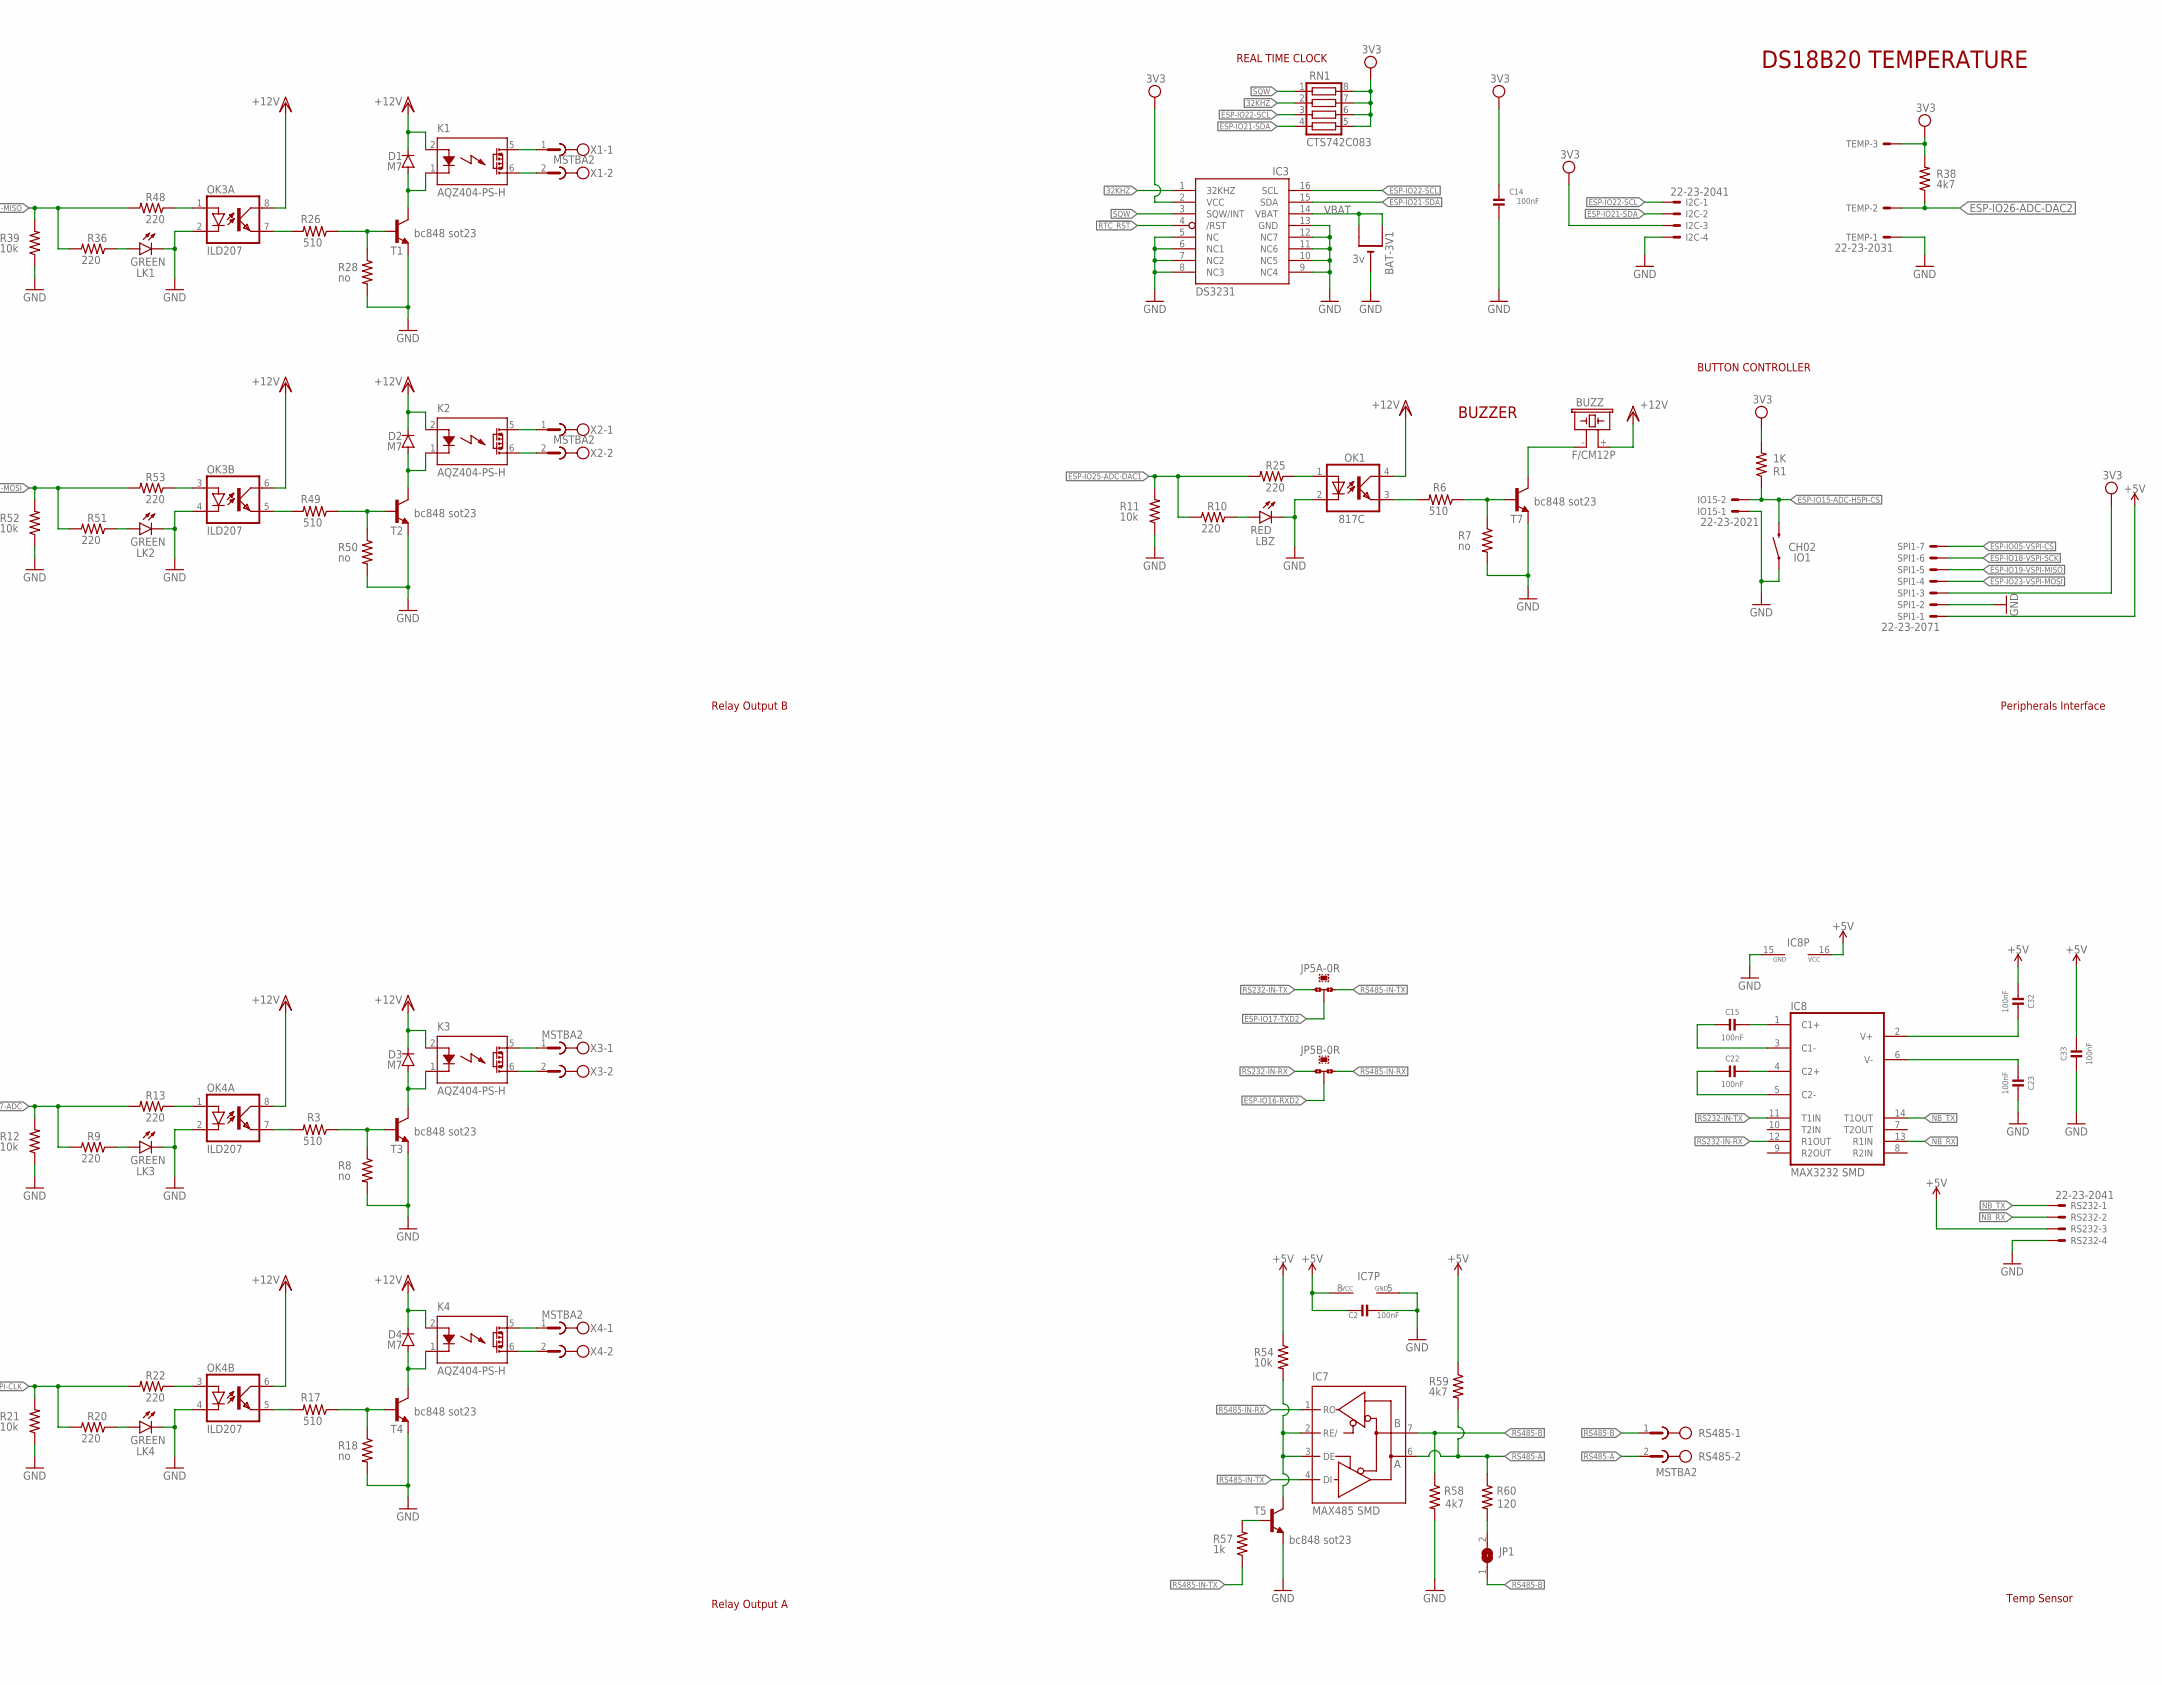
[picture p33: schematic GETEWAY.sch, sheet 1, part in row 1, column 3]

Parts:
7V-15VDC: DC21MMX; DC-21MM
12V: MSTBA2
ANALOG-INPUT: MSTBA4
BAT-3V1: 3v; CR2032-SMD
BOT: CH01; TACTILE_SWITCH_SMD_6.0X3.5MM
BUZZ: F/CM12P
C1, C10, C29: 100uF; E2,5-7
C2, C3, C6, C7, C8, C9, C12, C13, C14, C15, C18, C22, C23, C24, C25, C26, C28, C30, C31, C32, C33, C37, C38: 100nF; 0805-NO
C4, C5: 104; 0805
C11: 2200uF/25v; E5-13
C19: 100nF; C0603
C35: 100uF/50v; E3,5-8
C36: 330uF/25v; E3,5-8
D1, D2, D3, D4, D8, D9, D10, D13: M7; SMB
D5, D6: FES08AT; DO220S
D7, D12: 3v3; SMB
D11: SS510; SMB
DIIGITAL-INPUT: MSTBA6
EN-RST: CH01; TACTILE_SWITCH_SMD_6.0X3.5MM
ESP: ESP-WROOM-32
F1, F3: 500mA; L1812
FONTE1: IRM-15/20-12; IRM_15/20
FTDI: MA06-1
I2C: 22-23-2041
IC1: AMS1117-3.3v; SOT223
IC2, IC4: LM358D; SO08
IC3: DS3231/SO; SO16W
IC5: LM2576 5V; TO263-5
IC6: 74HC14D; SO14
IC7: MAX485 SMD; SO08
IC8: MAX3232 SMD; SO16
IC9: 74HC541DW; SO20W
IO1: CH02; TACTILE_SWITCH_SMD_6.0X3.5MM
IO15: 22-23-2021
JP1, JP2, JP3, JP6: SJ
JP4, JP5A, JP5B: 0R-JUMPA; A0R-JMP
K1, K2, K3, K4: AQZ404-PS-H
L1: 100uH; DR125
L3V3: LED1; CHIPLED_0805
LBZ: RED; CHIPLED_0805
LED-B: LED4; CHIPLED_0805
LED-G: LED3; CHIPLED_0805
LED-R: LED2; CHIPLED_0805
LK1, LK2, LK3, LK4: GREEN; CHIPLED_0805
LPWM1, LPWM2: BLUE; CHIPLED_0805
OK1, OK5: 817C; SMD4-7
OK2, OK3, OK4, OK6, OK7: ILD207; SOIC08
PWM: MSTBA4
Q1, Q2: 60N03; TRANS_AP70T03GH-HF-3TR
R1, R14, R68, R69: 1K; R0805
R2, R5: 30K; R0603
R3, R6, R17, R26, R49: 510; R0603
R4, R11, R12, R16, R19, R21, R24, R39, R40, R46, R52, R54, R56, R70, R71, R72, R73, R75, R78, R80: 10k; R0603
R7, R8, R18, R28, R50: no; R0603
R9, R10, R13, R15, R20, R22, R25, R36, R44, R48, R51, R53, R74, R76: 220; R0603
R23: 1k5; R0603
R27, R29, R30, R32, R34, R35, R37, R41, R42, R57: 1k; R0603
R31, R33, R43, R55: 10K; M1206
R38, R58, R59: 4k7; R0603
R45, R77: 100; R0603
R60: 120; R0603
R61: 470; M1206
R67: 470; R0603
RN1, RN2: CTS742C083
RS232: 22-23-2041
RS485: MSTBA2
RX: RED; CHIPLED_0805
SPI1: 22-23-2071
SPI2: PINHD-1X6; 1X06
SPWM3, SPWM4: PTR1PAD1-17; P1-17
T1, T2, T3, T4, T5, T7, T8, T9, T10: bc848 sot23; SOT23-BEC
T6: FDN340P; SOT-23
TEMP: 22-23-2031
TX: RED; CHIPLED_0805
U2: CH340G; SOIC16
UART2: 22-23-2041
USB: USB-MINI-B%C; USB-MINI-B_2
VDC: MSTBA4
X0-VCA: MKDS_5/3-7,62; MKDS_5/3-762
X1, X2, X3, X4: MSTBA2

Connections:
1: C38.2, IC6.5 (I), OK7.6 (COL)
2: C31.2, IC6.3 (I), OK7.8 (COL)
3: C24.2, IC6.1 (I), OK6.6 (COL)
4: C13.2, IC6.9 (I), OK6.8 (COL)
32KHZ: IC3.1 (32KHZ), RN1.2
!RTC_RST: IC3.4 (/RST)
DD1: IC6.6 (O), IC9.9 (A8)
DD2: IC6.4 (O), IC9.8 (A7)
DD3: IC6.2 (O), IC9.7 (A6)
DD4: IC6.8 (O), IC9.6 (A5)
DD5: IC6.10 (O)
DD6: IC6.12 (O)
DTR: R41.1, T10.E, U2.13 (DTR)
ESP2-IO02-ADC: ESP.24 (IO2), R74.2, R75.2, R76.2
ESP-IO00-ADC: BOT.2, ESP.25 (IO0), R73.1, T10.C
ESP-IO01-TXD0: ESP.35 (TXD0), FTDI.2, R29.1, TX.C
ESP-IO03-RXD0: ESP.34 (RXD0), FTDI.3, R30.1, RX.C
ESP-IO04-ADC: ESP.26 (IO4), R15.2, R16.2, R44.2
ESP-IO05-VSPI-CS: ESP.29 (IO5), R69.2, SPI1.7
ESP-IO06: ESP.20 (CLK), SPI2.3
ESP-IO07: ESP.21 (SDO), SPI2.2
ESP-IO08: ESP.22 (SD1), SPI2.1
ESP-IO09-RXD1: ESP.17 (SD2), SPI2.6
ESP-IO10-TXD1: ESP.18 (SD3), SPI2.5
ESP-IO11: ESP.19 (CMD), SPI2.4
ESP-IO12-ADC-HSPI-MISO: ESP.14 (IO12), R36.2, R39.2, R48.2
ESP-IO13-ADC-HSPI-MOSI: ESP.16 (IO13), R51.2, R52.2, R53.2
ESP-IO14-ADC-HSPI-CLK: ESP.13 (IO14), R20.2, R21.2, R22.2
ESP-IO15-ADC-HSPI-CS: ESP.23 (IO15), IO1.2, IO15.2, R1.1
ESP-IO16-RXD2: ESP.27 (IO16), JP5B.2, UART2.3
ESP-IO17-TXD2: ESP.28 (IO17), JP5A.2, UART2.2
ESP-IO18-VSPI-SCK: ESP.30 (IO18), R68.2, SPI1.6
ESP-IO19-VSPI-MISO: ESP.31 (IO19), R14.2, SPI1.5
ESP-IO21-SDA: ESP.33 (IO21), I2C.2, IC3.15 (SDA), R71.2, RN1.4
ESP-IO22-SCL: ESP.36 (IO22), I2C.1, IC3.16 (SCL), R70.2, RN1.3
ESP-IO23-VSPI-MOSI: ESP.37 (IO23), JP4.1, SPI1.4
ESP-IO25-ADC-DAC1: ESP.10 (IO25), R10.2, R11.2, R25.2
ESP-IO26-ADC-DAC2: ESP.11 (IO26), R38.1, TEMP.2
ESP-IO27-ADC: ESP.12 (IO27), R9.2, R12.2, R13.2
ESP-IO32-ADC: ESP.8 (IO32), IC9.12 (Y7), RN2.3
ESP-IO33-ADC: ESP.9 (IO33), IC9.11 (Y8), RN2.4
ESP-IO34-ADC: ESP.6 (IO34), IC9.14 (Y5), RN2.1
ESP-IO35-ADC: ESP.7 (IO35), IC9.13 (Y6), RN2.2
ESP-IO36-ADC: C18.2, ESP.4 (SENSOR_VP), IC4.1 (OUT), IC4.2 (-IN)
ESP-IO36-ADC1: IC2.7 (OUT), R27.2
ESP-IO39-ADC: C8.2, ESP.5 (SENSOR_VN), IC4.6 (-IN), IC4.7 (OUT)
ESP-NC: ESP.32 (NC)
ESP_EN: C19.1, EN-RST.2, ESP.3 (EN), R72.2, T9.C
GND: 7V-15VDC.1, 7V-15VDC.3, 12V.2, ANALOG-INPUT.4, BAT-3V1.-, BOT.1, C1.-, C2.1, C3.1, C6.2, C7.1, C8.1, C9.1, C10.-, C11.-, C12.1, C13.1, C14.1, C18.1, C19.2, C23.1, C24.1, C25.1, C26.1, C28.1, C29.-, C30.1, C31.1, C33.2, C35.-, C36.-, C37.1, C38.1, D7.A, D11.A, D12.A, EN-RST.1, ESP.1 (GND), ESP.15 (GND), ESP.38 (GND), ESP.GND, FONTE1.V-, FTDI.5, FTDI.6, I2C.4, IC1.1 (GND/ADJ), IC2.4 (V-), IC3.5 (NC), IC3.6 (NC1), IC3.7 (NC2), IC3.8 (NC3), IC3.9 (NC4), IC3.10 (NC5), IC3.11 (NC6), IC3.12 (NC7), IC3.13 (GND), IC4.4 (V-), IC5.3 (GND), IC5.5 (OFF), IC6.7 (GND), IC7.5 (GND), IC8.15 (GND), IC9.10 (GND), IC9.19 (G2), IO1.1, IO15.1, JP2.1, JP3.1, L3V3.C, LBZ.C, LK1.C, LK2.C, LK3.C, LK4.C, LPWM1.C, LPWM2.C, OK1.2 (C), OK2.2 (C), OK2.4 (C), OK3.2 (C), OK3.4 (C), OK4.2 (C), OK4.4 (C), OK5.2 (C), OK6.5 (EMIT), OK6.7 (EMIT), OK7.5 (EMIT), OK7.7 (EMIT), Q1.3 (S), Q2.3 (S), R4.1, R7.2, R8.2, R11.1, R12.1, R16.1, R18.2, R19.1, R21.1, R24.1, R28.2, R37.2, R39.1, R46.2, R50.2, R52.1, R58.2, R75.1, R78.2, RN2.5, RN2.6, RN2.7, RN2.8, RS232.4, SPI1.2, T1.E, T2.E, T3.E, T4.E, T5.E, T7.E, T8.E, TEMP.1, U2.1 (GND), UART2.4, USB.1 (GND), USB.6 (SH1), USB.7 (SH2), USB.8 (SH3), USB.9 (SH4), VDC.3, VDC.4
IN1: DIIGITAL-INPUT.6, R31.1
IN2: DIIGITAL-INPUT.5, R33.1
IN3: DIIGITAL-INPUT.4, R43.1
IN4: DIIGITAL-INPUT.3, R55.1
K_IN: D8.A, JP3.2, OK6.2 (C), OK6.4 (C), OK7.2 (C), OK7.4 (C)
unnamed: D1.A, K1.1 (K), T1.C
unnamed: R26.1, R28.1, T1.B
unnamed: OK3.7 (EMIT), R26.2
unnamed: C15.1, IC8.1 (C1+)
unnamed: C15.2, IC8.3 (C1-)
unnamed: C22.1, IC8.4 (C2+)
unnamed: C22.2, IC8.5 (C2-)
unnamed: C23.2, IC8.6 (V-)
unnamed: C32.1, IC8.2 (V+)
unnamed: BUZZ.- (2), T7.C
unnamed: R6.1, R7.1, T7.B
unnamed: K1.5 (DS1), X1.1
unnamed: K1.6 (DS2), X1.2
unnamed: K2.5 (DS1), X2.1
unnamed: ANALOG-INPUT.1, R5.1
unnamed: ANALOG-INPUT.2, R2.1
unnamed: D3.A, K3.1 (K), T3.C
unnamed: OK3.1 (A), R48.1
unnamed: D7.C, IC4.5 (+IN), R2.2, R4.2
unnamed: OK1.3 (EMIT), R6.2
unnamed: OK1.1 (A), R25.1
unnamed: R3.1, R8.1, T3.B
unnamed: LBZ.A, R10.1
unnamed: LK1.A, R36.1
unnamed: OK4.7 (EMIT), R3.2
unnamed: LED-R.A, R14.1
unnamed: R35.1, T8.B
unnamed: D2.A, K2.1 (K), T2.C
unnamed: K3.5 (DS1), X3.1
unnamed: K3.6 (DS2), X3.2
unnamed: K4.5 (DS1), X4.1
unnamed: R49.1, R50.1, T2.B
unnamed: OK6.1 (A), R31.2
unnamed: OK6.3 (A), R33.2
unnamed: OK4.1 (A), R13.1
unnamed: LK3.A, R9.1
unnamed: LED-G.A, R68.1
unnamed: LED-B.A, R69.1
unnamed: D4.A, K4.1 (K), T4.C
unnamed: R17.1, R18.1, T4.B
unnamed: OK3.5 (EMIT), R49.2
unnamed: OK2.3 (A), R44.1
unnamed: JP2.2, LED-B.C, LED-G.C, LED-R.C
unnamed: C9.2, U2.4 (V3)
unnamed: R29.2, U2.3 (RX)
unnamed: R30.2, U2.2 (TX)
unnamed: R34.2, RX.A
unnamed: OK7.1 (A), R43.2
unnamed: LPWM2.A, R15.1
unnamed: OK7.3 (A), R55.2
unnamed: OK2.5 (EMIT), R45.2, SPWM3.TP
unnamed: D8.C, DIIGITAL-INPUT.1
unnamed: JP4.2, R35.2
unnamed: D12.C, IC4.3 (+IN), R5.2, R19.2
unnamed: K2.6 (DS2), X2.2
unnamed: F1.2, X0-VCA.1
unnamed: F1.1, FONTE1.AC/N
unnamed: OK3.3 (A), R53.1
unnamed: LK2.A, R51.1
unnamed: IC2.5 (+IN), R23.2, R24.2
unnamed: K4.6 (DS2), X4.2
unnamed: OK5.1 (A), R27.1
unnamed: Q2.1 (G), R45.1, R46.1
unnamed: C5.2, D6.A, D10.A, PWM.4, Q2.2 (D), R56.2
unnamed: OK2.1 (A), R76.1
unnamed: LPWM1.A, R74.1
unnamed: OK2.7 (EMIT), R77.2, SPWM4.TP
unnamed: Q1.1 (G), R77.1, R78.1
unnamed: OK5.3 (EMIT), R37.1, T6.3 (G)
unnamed: F3.1, USB.5 (VBUS)
unnamed: FONTE1.AC/L, X0-VCA.3
unnamed: C4.2, D5.A, D9.A, PWM.2, Q1.2 (D), R80.2
unnamed: R57.2, T5.B
unnamed: IC7.2 (RE/), IC7.3 (DE), R54.2, T5.C
unnamed: L3V3.A, R67.1
unnamed: C11.+, R61.1
unnamed: JP1.2, R60.2
unnamed: D11.C, IC5.2 (OUT), L1.1
unnamed: C35.+, D13.C, IC5.1 (VIN)
unnamed: R32.2, TX.A
unnamed: R42.2, T10.B
unnamed: OK4.5 (EMIT), R17.2
unnamed: OK4.3 (A), R22.1
unnamed: R41.2, T9.B
unnamed: LK4.A, R20.1
NB_RX: IC8.13 (R1IN), RS232.2
NB_TX: IC8.14 (T1OUT), RS232.1
OE1_IN: IC9.1 (G1), R40.1, T8.C
RS232-IN-RX: IC8.12 (R1OUT), JP5B.3
RS232-IN-TX: IC8.11 (T1IN), JP5A.3
RS485-A: IC7.6 (A), R59.2, R60.1, RS485.2
RS485-B: IC7.7 (B), JP1.1, R58.1, RS485.1
RS485-IN-RX: IC7.1 (RO), JP5B.1
RS485-IN-TX: IC7.4 (DI), JP5A.1, R57.1
RTS: R42.1, T9.E, U2.14 (RTS)
SQW: IC3.3 (SQW/INT), RN1.1
USB_D+: U2.5 (D+), USB.4 (D-)
USB_D-: U2.6 (D-), USB.3 (D+)
VBAT: BAT-3V1.+$1 (+), BAT-3V1.+$2 (+1), IC3.14 (VBAT)
VCC: C1.+, C2.2, C25.2, C32.2, C33.1, C36.+, C37.2, FTDI.4, IC1.3 (IN), IC2.6 (-IN), IC5.4 (FB), IC7.8 (VCC), IC8.16 (VCC), JP6.2, L1.2, OK5.4 (COL), R32.1, R34.1, R40.2, R54.1, R59.1, RS232.3, SPI1.1, T6.1 (D), UART2.1, VDC.2
VDD: 7V-15VDC.2, 12V.1, ANALOG-INPUT.3, BUZZ.+ (1), C3.2, C4.1, C5.1, C6.1, C28.2, C30.2, D1.C, D2.C, D3.C, D4.C, D5.C, D6.C, D9.C, D10.C, D13.A, DIIGITAL-INPUT.2, FONTE1.V+, IC2.8 (V+), IC4.8 (V+), IC6.14 (VCC), IC9.20 (VCC), K1.2 (A), K2.2 (A), K3.2 (A), K4.2 (A), OK1.4 (COL), OK2.6 (COL), OK2.8 (COL), OK3.6 (COL), OK3.8 (COL), OK4.6 (COL), OK4.8 (COL), PWM.1, PWM.3, R23.1, R56.1, R61.2, R80.1
VEE: C7.2, C10.+, C14.2, C26.2, C29.+, ESP.2 (3V3), I2C.3, IC1.2 (OUT), IC1.4 (OUT), IC3.2 (VCC), JP4.3, R1.2, R38.2, R67.2, R70.1, R71.1, R72.1, R73.2, RN1.5, RN1.6, RN1.7, RN1.8, SPI1.3, TEMP.3, VDC.1
VSUB+: C12.2, F3.2, JP6.1, T6.2 (S), U2.16 (VCC)

Notes on the sheet:
3V3 Voltage Regulator
5V Voltage Regulator
12V INPUT
PCB POWER SUPPLY - 12V - 1,15A
1n5822
Step-Down Voltage Regulator
Power Supply
uC I2C
PGM
RST
Computer
FTDI-FIRMWARE
USB POWER
Recording Interface
DIGITAL INPUT CIRCUIT
JP3 - USE O JUMPER JP3 PARA REFERENCIA INTERNA DO COMUM NOS SINAIS DE ENTRADA DIGITAL
Digital Inputs
ANALOG INPUT
Analog Input
PWM OUTPUT CIRCUIT
PWM Output
Relay Output A
Relay Output B
BUZZER
REAL TIME CLOCK
BUTTON CONTROLLER
Peripherals Interface
DS18B20 TEMPERATURE
Temp Sensor
JP2 - PARA ACIONAR OS LEDS RGB SERA NECESSARIO SOLDAR O JUMPER
JP4 - O JUMPER JP4 CONTROLA O MODULO DE ENTRADAS DIGITAIS - SE - "3V3" LIGA DIRETO. - SE - "uC" O ESP CONTROLA.
UART2
LED RED-GREEN-BLUE
JP6 - SE APRESENTAR PROBLEMA NA GRAVACAO USB, UTILIZAR O JUMPER JP6 PARA LIGAR O 5V USB DIRETAMENTE
JP1 - UTILIZADO QUANDO NECESSARIO RESISTOR DE FIM DE LINHA DA COMUNICACAO RS485
JP5A & JP5B - SELECIONA O TIPO DE COMUNICACAO UTILIZADA COM A UART2 - RS232 ou RS485

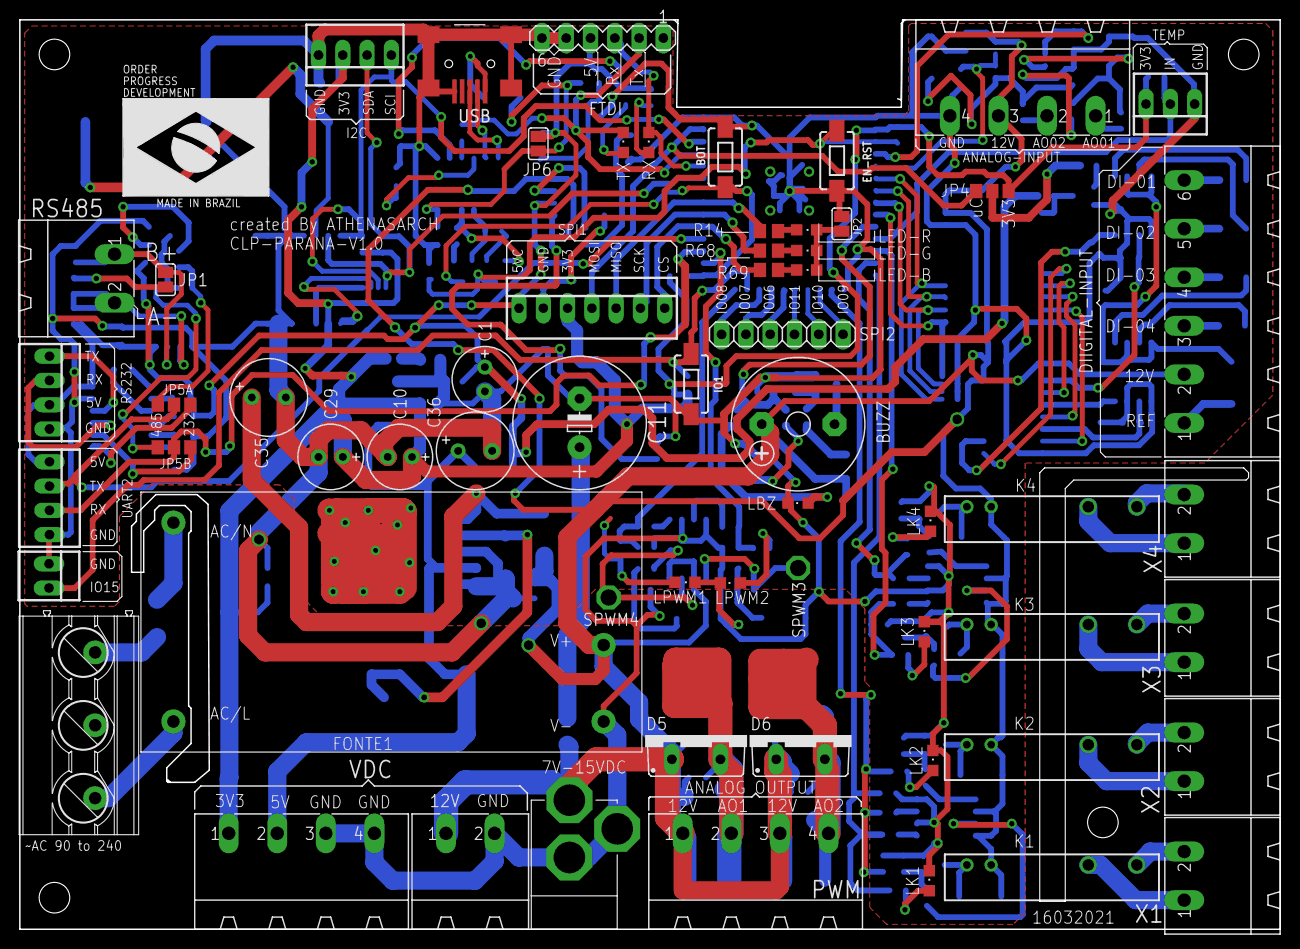
[picture p34: board GETEWAY.brd from above]

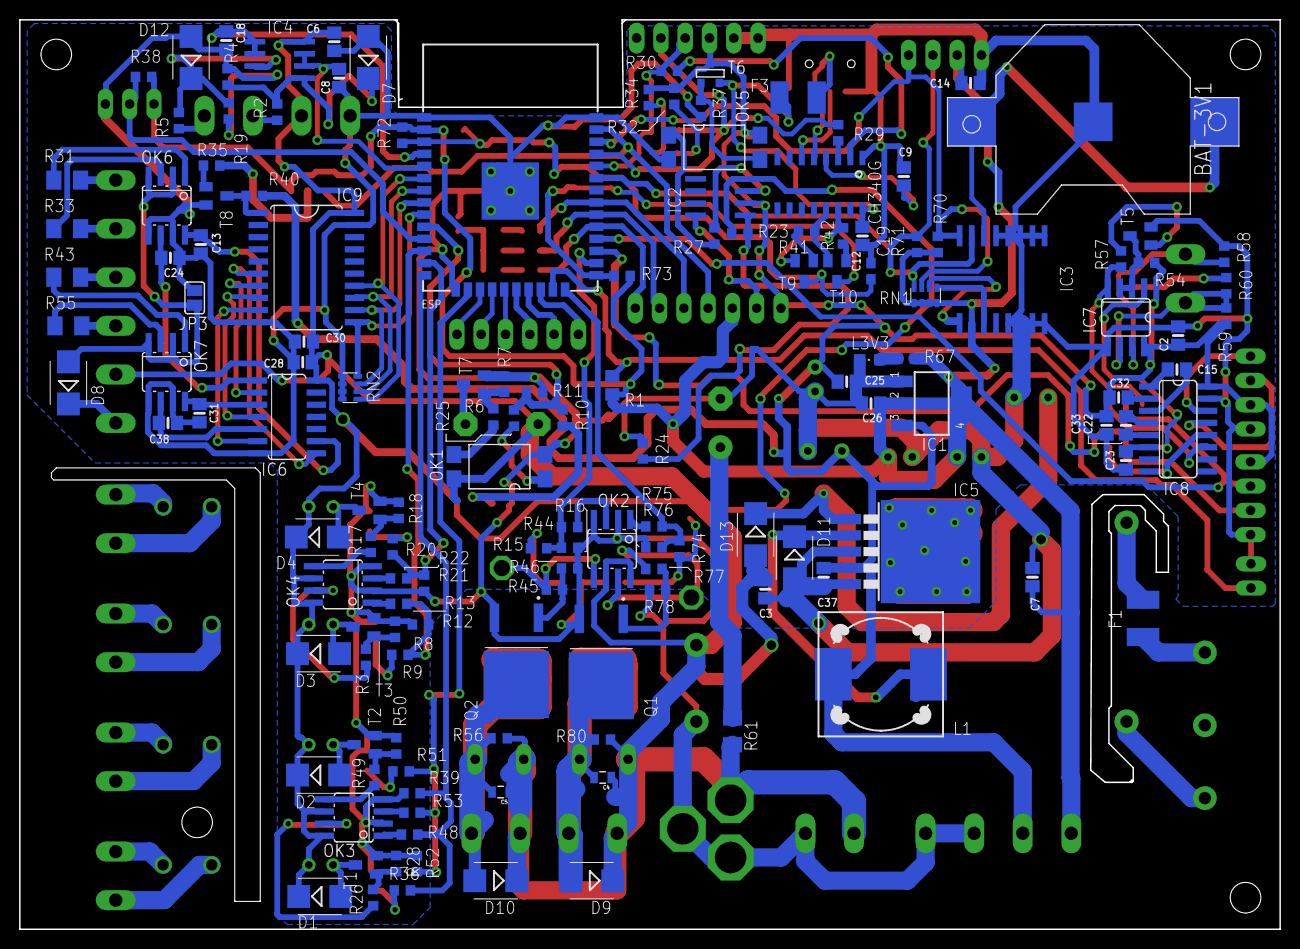
[picture p35: board GETEWAY.brd from below]

Board: 2 copper layers, 131.8 x 95.1 mm, 206 parts (145 on the bottom side), 153 nets.
